Eskdagoat/Qorvo_F24_SD/Eclypse_TEST/Eclypse_Test_PLL_1/Eclypse_Test_PLL_1.runs/impl_1/.init_design.begin.rst

<?xml version="1.0"?>
<ProcessHandle Version="1" Minor="0">
    <Process Command=".planAhead." Owner="ambsc" Host="AB-BEAST" Pid="18544">
    </Process>
</ProcessHandle>
