Eskdagoat/Qorvo_F24_SD/PYNQ/PYNQ_CLOCK_TEST/PYNQ_PLL_TEST.runs/MainDesign_ClockDivider_4_0_synth_1/.vivado.begin.rst

<?xml version="1.0"?>
<ProcessHandle Version="1" Minor="0">
    <Process Command="vivado.bat" Owner="ambsc" Host="AB-BEAST" Pid="27872" HostCore="16" HostMemory="051385802752">
    </Process>
</ProcessHandle>
