Eskdagoat/Qorvo_F24_SD/Eclypse_TEST/Eclypse_Transceiver/Eclypse_Transceiver/Eclypse_Transceiver.runs/impl_1/.init_design.begin.rst

<?xml version="1.0"?>
<ProcessHandle Version="1" Minor="0">
    <Process Command=".planAhead." Owner="andrew" Host="" Pid="36212">
    </Process>
</ProcessHandle>
