Eskdagoat/Qorvo_F24_SD/Computer/Eclypse/Eclypse_Transceiver/Eclypse_Transceiver/Eclypse_Transceiver.runs/impl_1/.vivado.begin.rst

<?xml version="1.0"?>
<ProcessHandle Version="1" Minor="0">
    <Process Command="vivado" Owner="andrew" Host="AB-UB24Vivado" Pid="36140" HostCore="8" HostMemory="16375808">
    </Process>
</ProcessHandle>
