Eskdagoat/Qorvo_F24_SD/SD1_Fall24/Computer/Eclypse/Eclypse_Transceiver/Eclypse_Transceiver/Eclypse_Transceiver.runs/impl_1/clockInfo.txt

-------------------------------------
| Tool Version : Vivado v.2024.2
| Date         : Sat Nov 23 22:49:03 2024
| Host         : AB-UB24Vivado
| Design       : design_1
| Device       : xc7z020-clg484-1--
-------------------------------------

For more information on clockInfo.txt clock routing debug file see https://support.xilinx.com/s/article/000035660?language=en_US
