Eskdagoat/Qorvo_F24_SD/SD2_Spring25/Reports/QORVO_RADIO_EXPO_POSTER_SDII.pptx.pdf

# Design of a Reconfigurable (Software Defined) Radio

# Senior Design II - Fall 2024

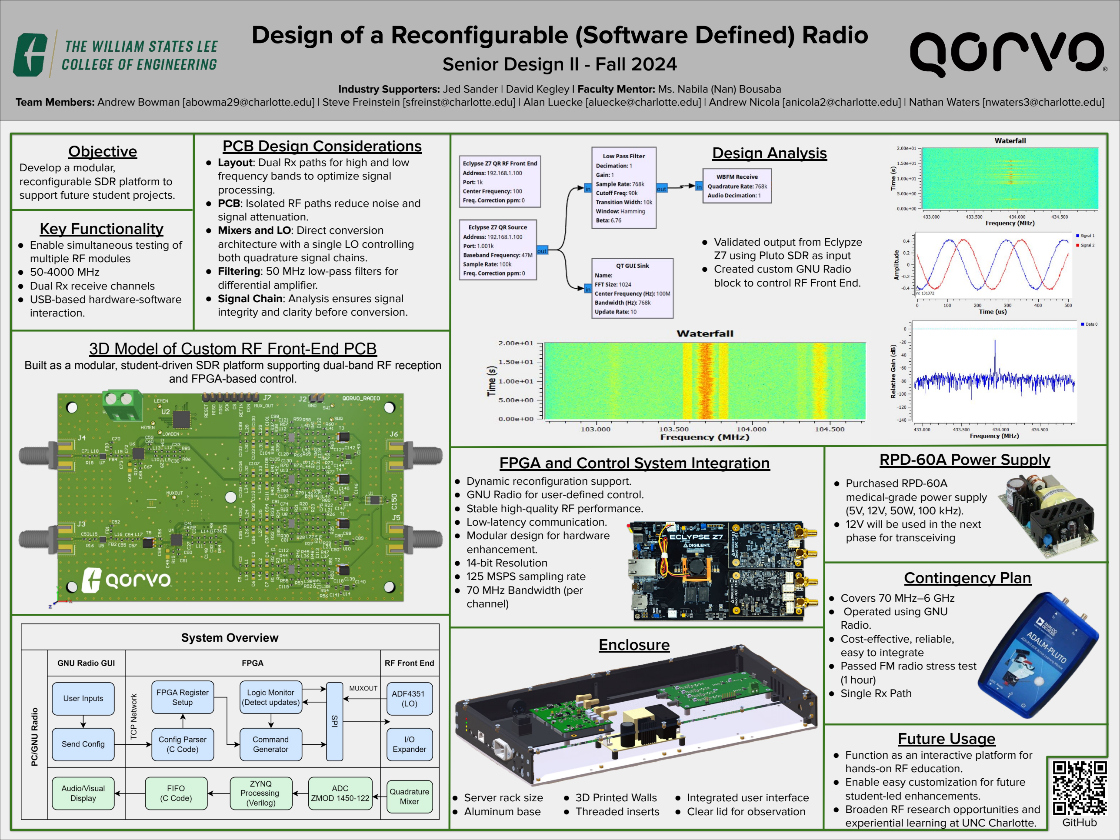
[picture p6: page 1]

## RPD-60A Power Supply

Industry Supporters: Jed Sander | David Kegley | Faculty Mentor: Ms. Nabila (Nan) Bousaba
Team Members: Andrew Bowman [abowma29@charlotte.edu] | Steve Freinstein [sfreinst@charlotte.edu] | Alan Luecke [aluecke@charlotte.edu] | Andrew Nicola [anicola2@charlotte.edu] | Nathan Waters [nwaters3@charlotte.edu]

## Objective

Develop a modular,
reconfigurable SDR platform to support future student projects.

## Key Functionality

- Enable simultaneous testing of multiple RF modules
- 50-4000 MHz
- Dual Rx receive channels
- USB-based hardware-software interaction.

## Design Analysis

## Contingency Plan

## Future Usage

- Function as an interactive platform for hands-on RF education.
- Enable easy customization for future
student-led enhancements.
- Broaden RF research opportunities and experiential learning at UNC Charlotte. GitHub

## PCB Design Considerations

- Layout: Dual Rx paths for high and low frequency bands to optimize signal processing.
- PCB: Isolated RF paths reduce noise and signal attenuation.
- Mixers and LO: Direct conversion architecture with a single LO controlling both quadrature signal chains.
- Filtering: 50 MHz low-pass filters for differential amplifier.
- Signal Chain: Analysis ensures signal integrity and clarity before conversion.

## FPGA and Control System Integration

- Dynamic reconfiguration support.
- GNU Radio for user-defined control.
- Stable high-quality RF performance.
- Low-latency communication.
- Modular design for hardware enhancement.
- 14-bit Resolution
- 125 MSPS sampling rate
- 70 MHz Bandwidth (per
channel)

## 3D Model of Custom RF Front-End PCB

Built as a modular, student-driven SDR platform supporting dual-band RF reception and FPGA-based control.

## Enclosure

- 3D Printed Walls
- Threaded inserts
- Integrated user interface
- Clear lid for observation
- Purchased RPD-60A
medical-grade power supply (5V, 12V, 50W, 100 kHz).
- 12V will be used in the next phase for transceiving
- Covers 70 MHz–6 GHz
- Operated using GNU
Radio.
- Cost-effective, reliable, easy to integrate
- Passed FM radio stress test (1 hour)
- Single Rx Path
- Server rack size
- Aluminum base
- Validated output from Eclypze Z7 using Pluto SDR as input
- Created custom GNU Radio block to control RF Front End.
