Eskdagoat/Qorvo_F24_SD/SD2_Spring25/Reports/QORVO_RADIO_ProjectSummary.pdf

Team Members Andrew Bowman (CPGR), Steve Freinstein (CPGR), Alan Luecke (MEGR), Andrew Nicola (EEGR), Nathan Waters (EEGR)

Mentors Ms. Nabila (Nan) BouSaba (ECE)

Project Overview Our project is the design and implementation of a modular, reconfigurable Software Defined Radio (SDR) platform. The goal is to provide a versatile system that can serve as an educational and prototyping tool for RF communication and signal processing. The system features a custom 6-layer RF front-end PCB designed in Altium, integrated with a Digilent Eclypse Z7 FPGA for high-speed digital signal processing. The RF front-end supports a tuning range of 50 MHz to 4 GHz and includes components for low-noise amplification, filtering, and mixing. The enclosure is constructed from an aluminum base plate and 3D printed walls to provide structural integrity and effective RF shielding. This SDR platform is designed with future expansion in mind—modules can be easily added, removed, or reconfigured. A host interface with GNU Radio on a PC enables real-time signal visualization and control. To validate the design and ensure functionality under constraints, the team also implemented a testing and contingency plan using an ADALM-PLUTO SDR.

Project Supporter Qorvo Inc, Staff Test Engineer David Kegley and RF Test Develpment Engineer Jed Sander
