Eskdagoat/Qorvo_F24_SD/SD1_Fall24/Computer/Eclypse/Diagrams/EclypseZ7_rev0-Copy of Hardware.drawio.png

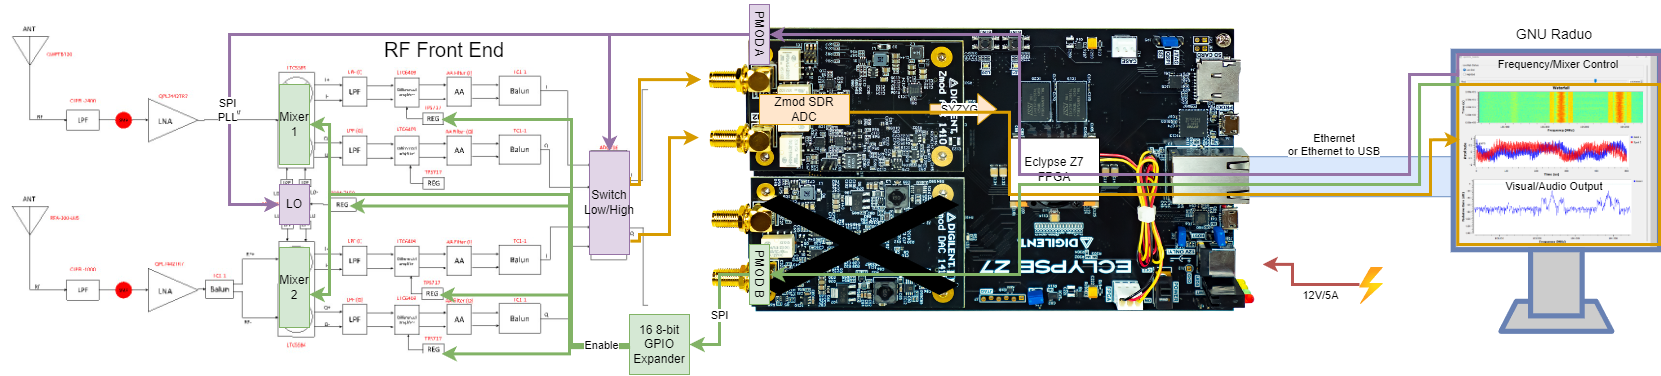
SD1_Fall24/Computer/Eclypse/Diagrams/EclypseZ7_rev0-Copy of Hardware.drawio.png
