Eskdagoat/Qorvo_F24_SD/SD1_Fall24/Computer/Eclypse/Images/Eclypse_PLL_1.png

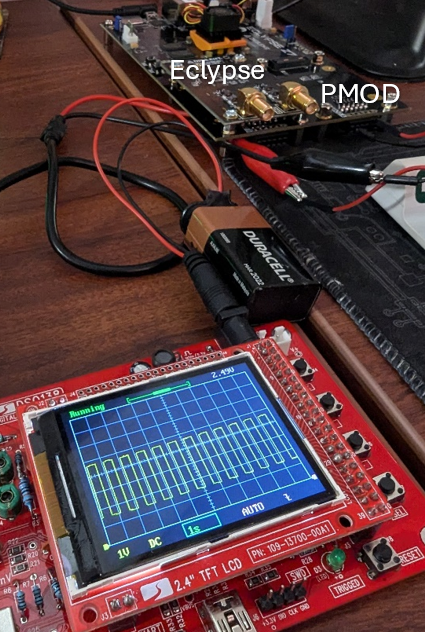
SD1_Fall24/Computer/Eclypse/Images/Eclypse_PLL_1.png
