Eskdagoat/Qorvo_F24_SD/SD1_Fall24/Computer/Images/GNU_Radio_1.png

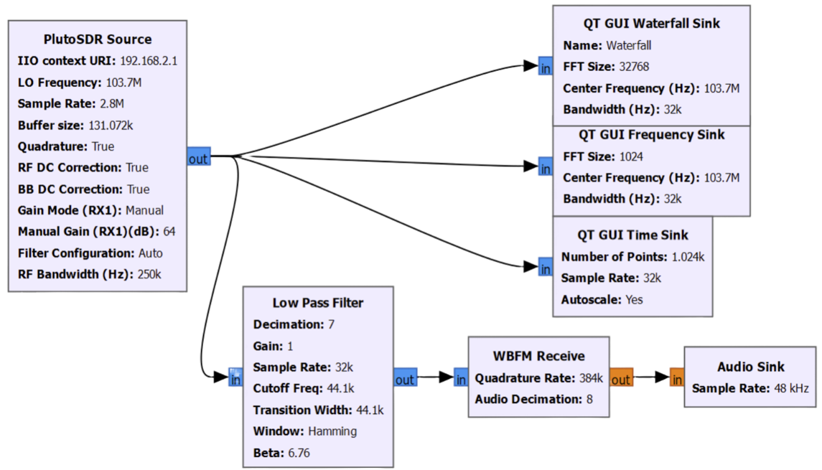
SD1_Fall24/Computer/Images/GNU_Radio_1.png
