Eskdagoat/Qorvo_F24_SD/SD1_Fall24/Electrical/BLOCK DIAGRAM/EclypseZ7_rev0-Hardware.drawio.png

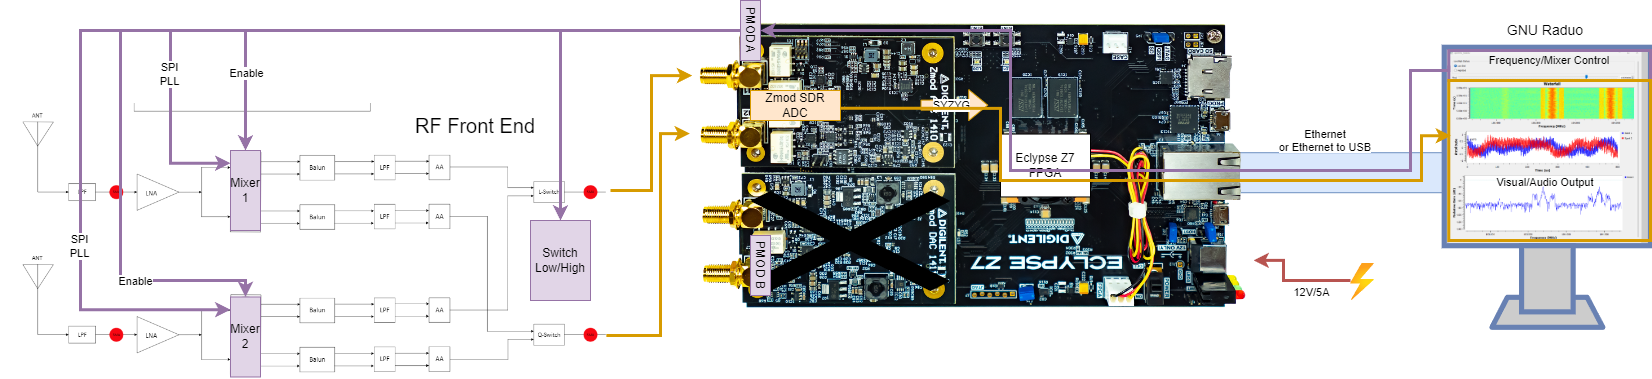
SD1_Fall24/Electrical/BLOCK DIAGRAM/EclypseZ7_rev0-Hardware.drawio.png
