Eskdagoat/Qorvo_F24_SD/SD1_Fall24/Electrical/FILTER/LPF&AA_FILTER.png

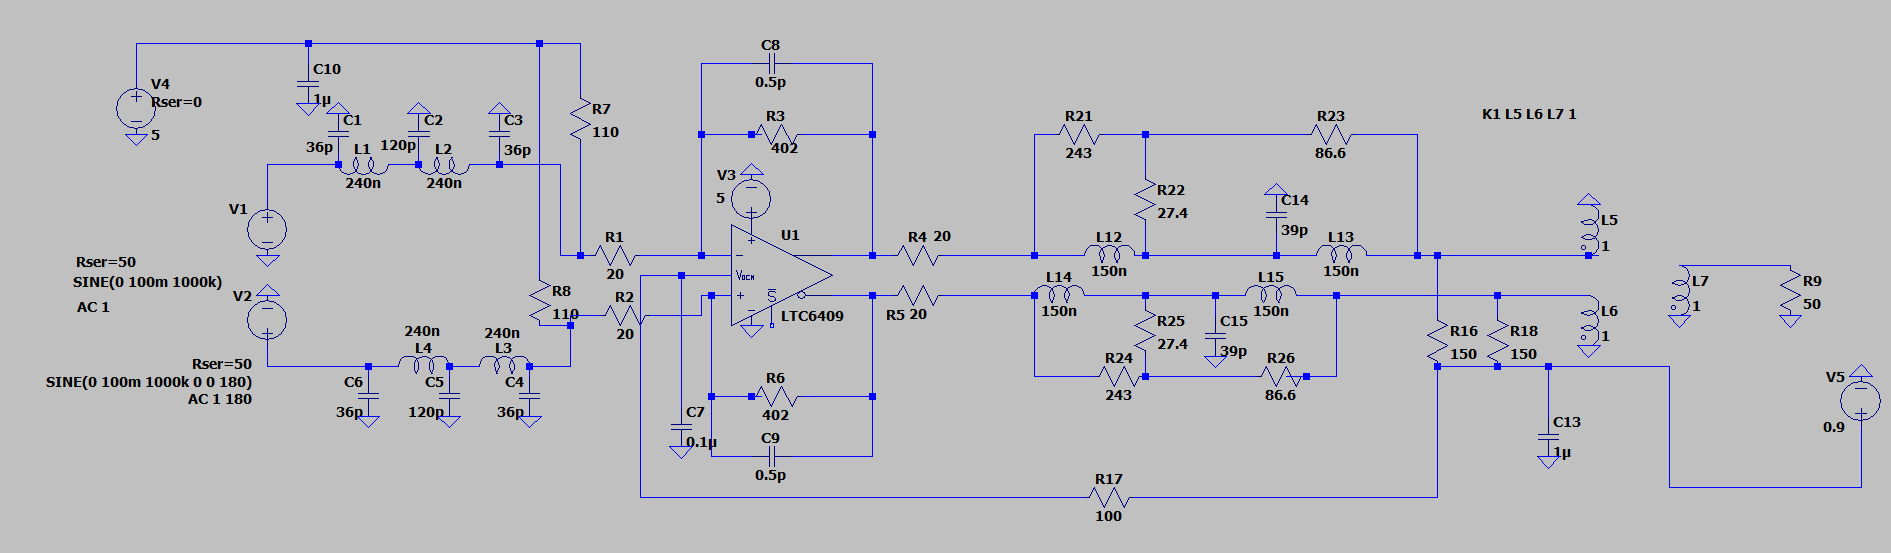
SD1_Fall24/Electrical/FILTER/LPF&AA_FILTER.png
