Eskdagoat/Qorvo_F24_SD/SD1_Fall24/Mechanical/MECHANICAL PICTURES/IMAGE_01.jpg

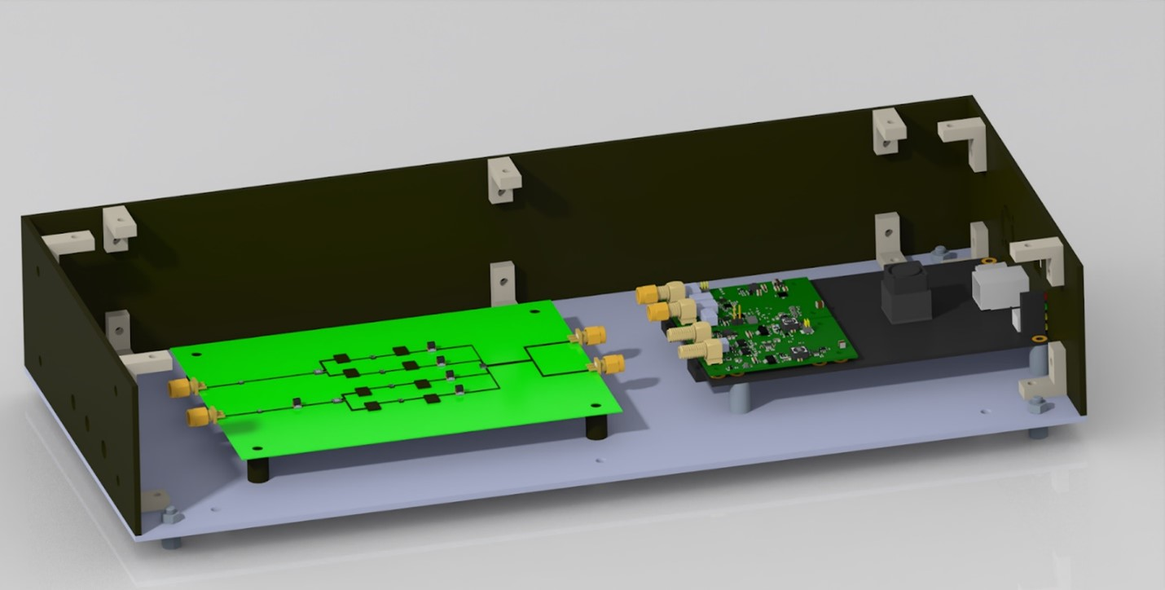
SD1_Fall24/Mechanical/MECHANICAL PICTURES/IMAGE_01.jpg
