Eskdagoat/Qorvo_F24_SD/SD1_Fall24/Mechanical/MECHANICAL PICTURES/IMAGE_02.png

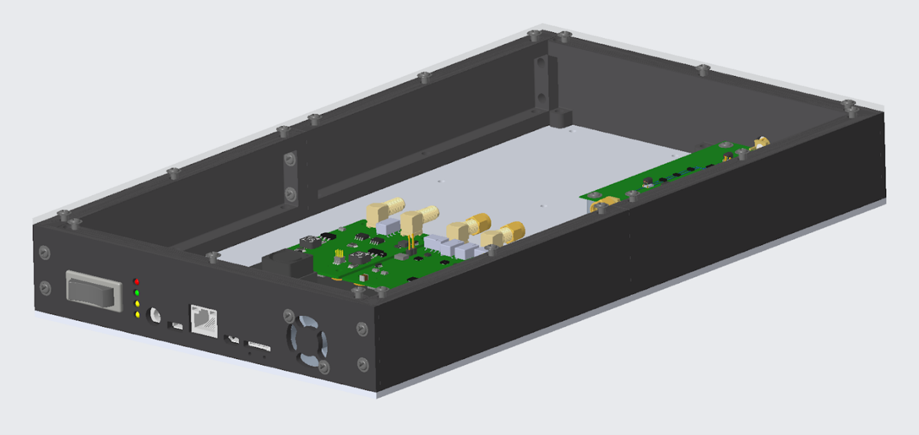
SD1_Fall24/Mechanical/MECHANICAL PICTURES/IMAGE_02.png
