Eskdagoat/Qorvo_F24_SD/Eclypse_TEST/Eclypse_Test_PLL_1/Eclypse_Test_PLL_1.runs/impl_1/.vivado.begin.rst

<?xml version="1.0"?>
<ProcessHandle Version="1" Minor="0">
    <Process Command="vivado.bat" Owner="ambsc" Host="AB-BEAST" Pid="11464" HostCore="16" HostMemory="051385802752">
    </Process>
</ProcessHandle>
<?xml version="1.0"?>
<ProcessHandle Version="1" Minor="0">
    <Process Command="vivado.bat" Owner="ambsc" Host="AB-BEAST" Pid="7532" HostCore="16" HostMemory="051385802752">
    </Process>
</ProcessHandle>
<?xml version="1.0"?>
<ProcessHandle Version="1" Minor="0">
    <Process Command="vivado.bat" Owner="ambsc" Host="AB-BEAST" Pid="12196" HostCore="16" HostMemory="051385802752">
    </Process>
</ProcessHandle>
<?xml version="1.0"?>
<ProcessHandle Version="1" Minor="0">
    <Process Command="vivado.bat" Owner="ambsc" Host="AB-BEAST" Pid="26444" HostCore="16" HostMemory="051385802752">
    </Process>
</ProcessHandle>
<?xml version="1.0"?>
<ProcessHandle Version="1" Minor="0">
    <Process Command="vivado.bat" Owner="ambsc" Host="AB-BEAST" Pid="27564" HostCore="16" HostMemory="051385802752">
    </Process>
</ProcessHandle>
<?xml version="1.0"?>
<ProcessHandle Version="1" Minor="0">
    <Process Command="vivado.bat" Owner="ambsc" Host="AB-BEAST" Pid="28036" HostCore="16" HostMemory="051385802752">
    </Process>
</ProcessHandle>
<?xml version="1.0"?>
<ProcessHandle Version="1" Minor="0">
    <Process Command="vivado.bat" Owner="ambsc" Host="AB-BEAST" Pid="27432" HostCore="16" HostMemory="051385802752">
    </Process>
</ProcessHandle>
<?xml version="1.0"?>
<ProcessHandle Version="1" Minor="0">
    <Process Command="vivado.bat" Owner="ambsc" Host="AB-BEAST" Pid="29864" HostCore="16" HostMemory="051385802752">
    </Process>
</ProcessHandle>
