Eskdagoat/Qorvo_F24_SD/Eclypse_TEST/Eclypse_Test_PLL_1/Eclypse_Test_PLL_1.runs/synth_1/.vivado.begin.rst

<?xml version="1.0"?>
<ProcessHandle Version="1" Minor="0">
    <Process Command="vivado.bat" Owner="ambsc" Host="AB-BEAST" Pid="6168" HostCore="16" HostMemory="051385802752">
    </Process>
</ProcessHandle>
