Eskdagoat/Qorvo_F24_SD/SD1_Fall24/Computer/Eclypse/Eclypse_Test_PLL_1/Eclypse_Test_PLL_1.runs/ClockDivider_Block_ClockDivider_0_0_synth_1/.vivado.begin.rst

<?xml version="1.0"?>
<ProcessHandle Version="1" Minor="0">
    <Process Command="vivado.bat" Owner="ambsc" Host="AB-LENOVO5" Pid="16440" HostCore="8" HostMemory="016705122304">
    </Process>
</ProcessHandle>
