Eskdagoat/Qorvo_F24_SD/SD1_Fall24/Computer/PYNQ/PYNQ_CLOCK_TEST/PYNQ_PLL_TEST.runs/impl_1/clockInfo.txt

-------------------------------------
| Tool Version : Vivado v.2024.1
| Date         : Sun Nov 17 23:51:58 2024
| Host         : AB-Beast
| Design       : design_1
| Device       : xc7z020-clg400-1--
-------------------------------------

For more information on clockInfo.txt clock routing debug file see https://support.xilinx.com/s/article/000035660?language=en_US
