Eskdagoat/Qorvo_F24_SD/SD1_Fall24/Computer/Eclypse/Eclypse_Testing.MD

# Eclypse Z7 Testing

## PLL Output

A PLL signal was output from the PMOD on the PYNQ to test the feasability of outputing a clock over PMOD ports. The code for the PLL was based on code that was tested on the PYNQ-Z2. The guide linked below was used as a starting place for code on the PYNQ-Z2.   The output was tested with a cheap oscilliscope. 

[A PYNQ-Z2 Guide for Absolute Dummies — Part III: Configuring the FPGA Clock](https://blog.umer-farooq.com/a-pynq-z2-guide-for-absolute-dummies-part-iii-tick-tock-using-fpga-clock-33a34ef3f51a)

[Vivado source for PLL Output](https://github.com/Eskdagoat/Qorvo_F24_SD/tree/main/Eclypse_TEST/Eclypse_Test_PLL_1)

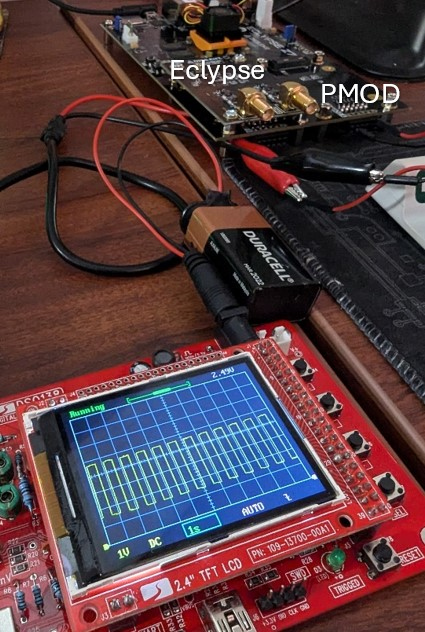
[picture p31: SD1_Fall24/Computer/Eclypse/Images/Eclypse_PLL_1.jpg]
Eclypse PLL Output


Figure 1 - Eclypse PLL Output
