Eskdagoat/Qorvo_F24_SD/SD1_Fall24/Computer/Eclypse/Images/Eclypse_Test_Images.docx

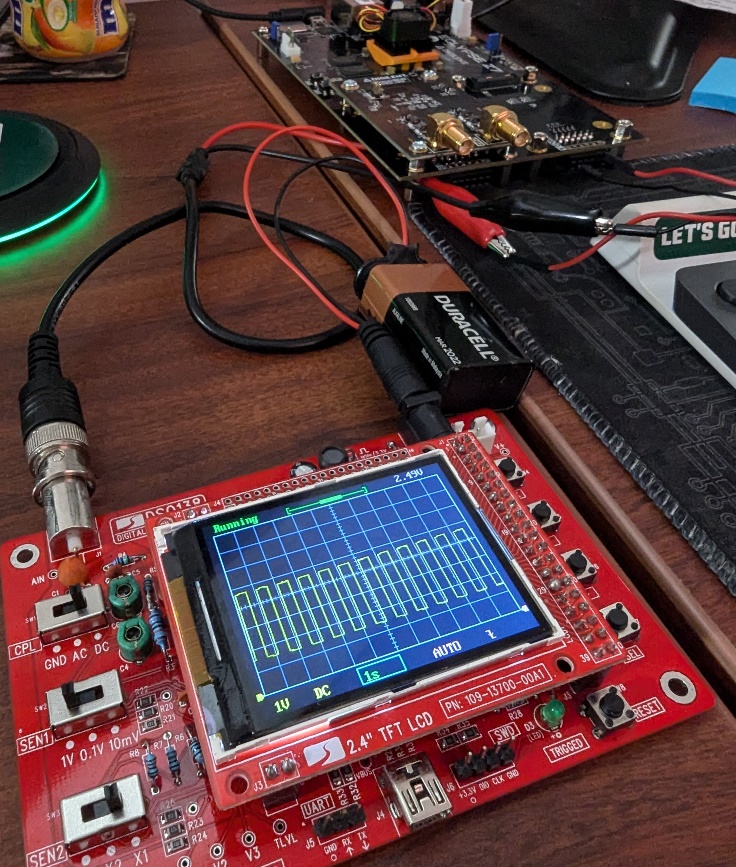
[picture p32: figure]

PMOD

Eclypse
