Eskdagoat/Qorvo_F24_SD/SD1_Fall24/Electrical/PCB/SCHEMATIC/QORVO_RADIO_PDR_DrawingSet_SCHEMATIC.pdf

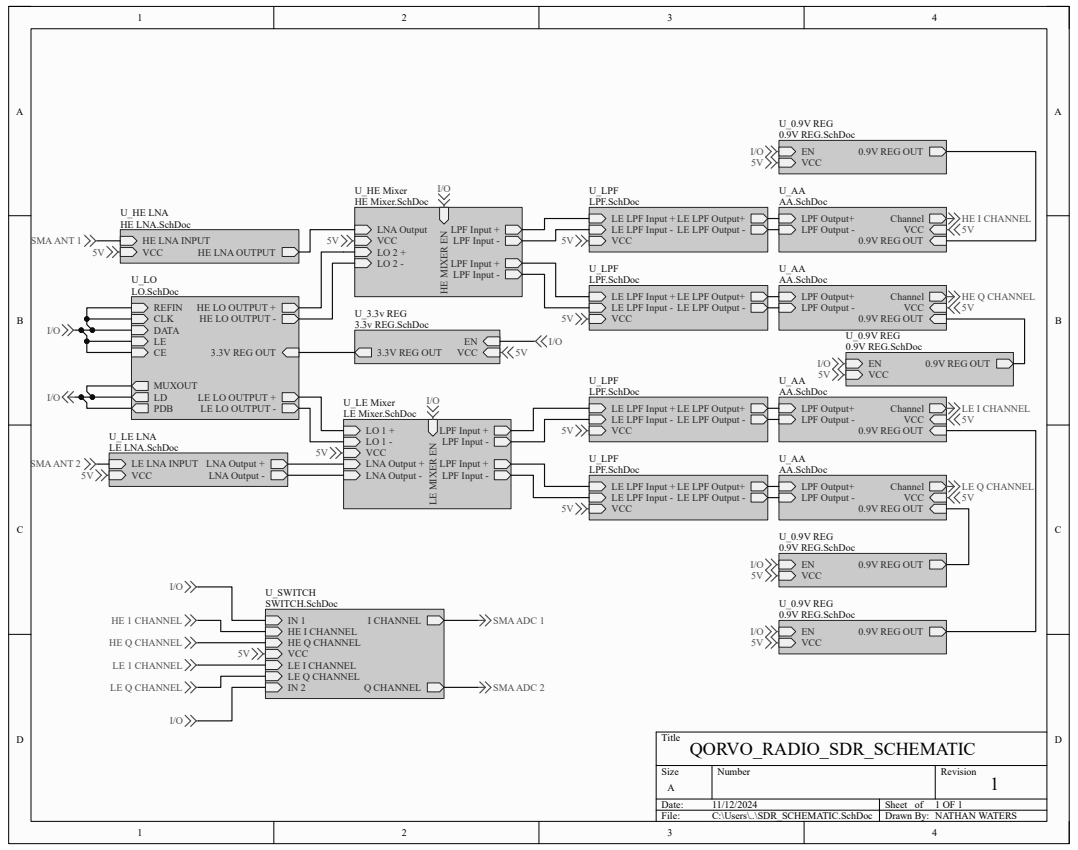
[picture p34: page 1]
Title; Size; Number; Revision; Date:; Sheet of; File:; C:\Users\..\SDR_SCHEMATIC.SchDoc; Drawn By:; VCC; HE LNA OUTPUT; LNA Output + LNA Output -; LNA Output; LPF Input + LPF Input -; HE MIXER EN; LE MIXER EN; REFIN; HE LO OUTPUT +; CLK DATA LE CE; MUXOUT LD PDB; 3.3V REG OUT; U_LO LO.SchDoc; U_3.3v REG 3.3v REG.SchDoc; U_LPF LPF.SchDoc 5V; SMA ANT 1; SMA ANT 2; LPF Output+ LPF Output -; Channel VCC 0.9V REG OUT; U_AA AA.SchDoc; HE I CHANNEL; EN VCC; 0.9V REG OUT; U_0.9V REG 0.9V REG.SchDoc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

U_HE Mixer
HE Mixer.SchDoc

U_LPF
LPF.SchDoc
LE LPF Input +
LE LPF Input -
VCC

U_HE LNA
HE LNA.SchDoc
HE LNA INPUT

LE LPF Output+
LE LPF Output -

HE LO OUTPUT -

LE LO OUTPUT +
LE LO OUTPUT -

U_LE Mixer
LE Mixer.SchDoc
LNA Output +
LNA Output -

U_LE LNA
LE LNA.SchDoc
LE LNA INPUT

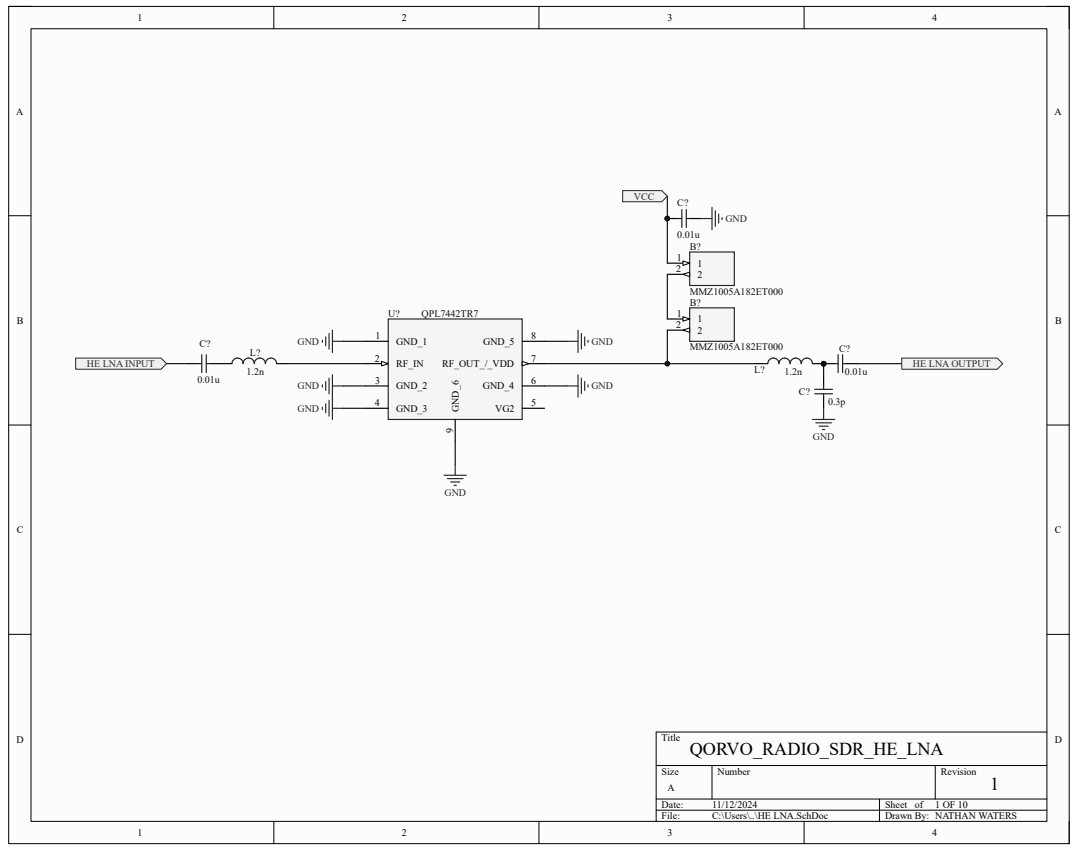
[picture p35: page 2]
Title; Size; Number; Revision; File:; C:\Users\..\HE LNA.SchDoc; Drawn By:; GND_1 1; GND_2 3; GND_3 4; GND_6; GND_5; RF_OUT_/_VDD; GND_4; QPL7442TR7; GND; MMZ1005A182ET000; VCC; QORVO_RADIO_SDR_HE_LNA

HE LNA INPUT

HE LNA OUTPUT

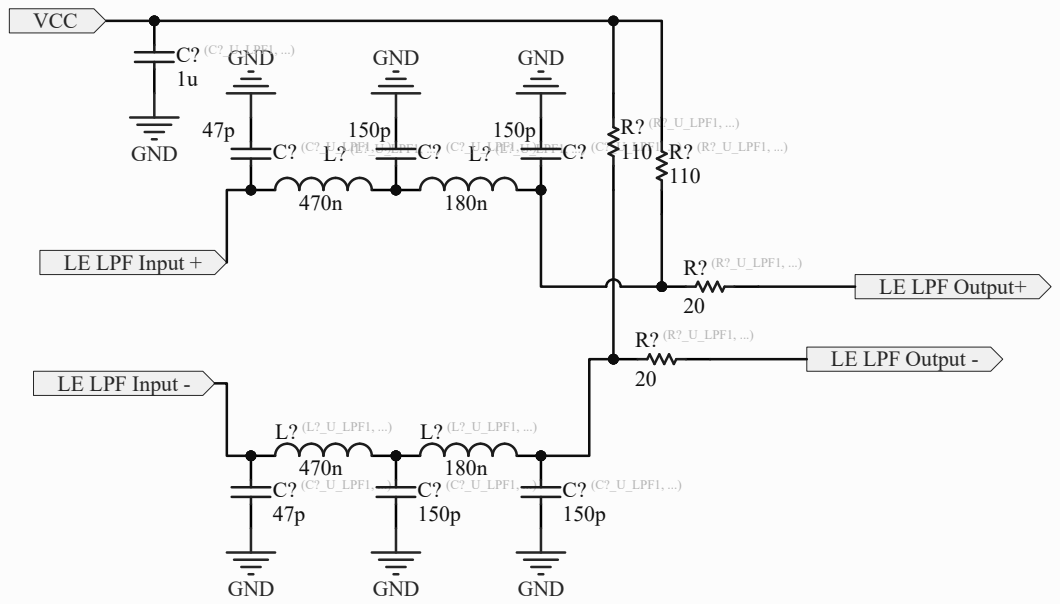
[picture p36: page 3]
Title; Size; Number; Revision; File:; C:\Users\..\LPF.SchDoc; Drawn By:; L? ⁽L?_U_LPF1, ...); C? ⁽C?_U_LPF1, ...); GND; R? ⁽R?_U_LPF1, ...); VCC; QORVO_RADIO_SDR_LPF

LE LPF Input +

LE LPF Output+

LE LPF Output -

LE LPF Input -

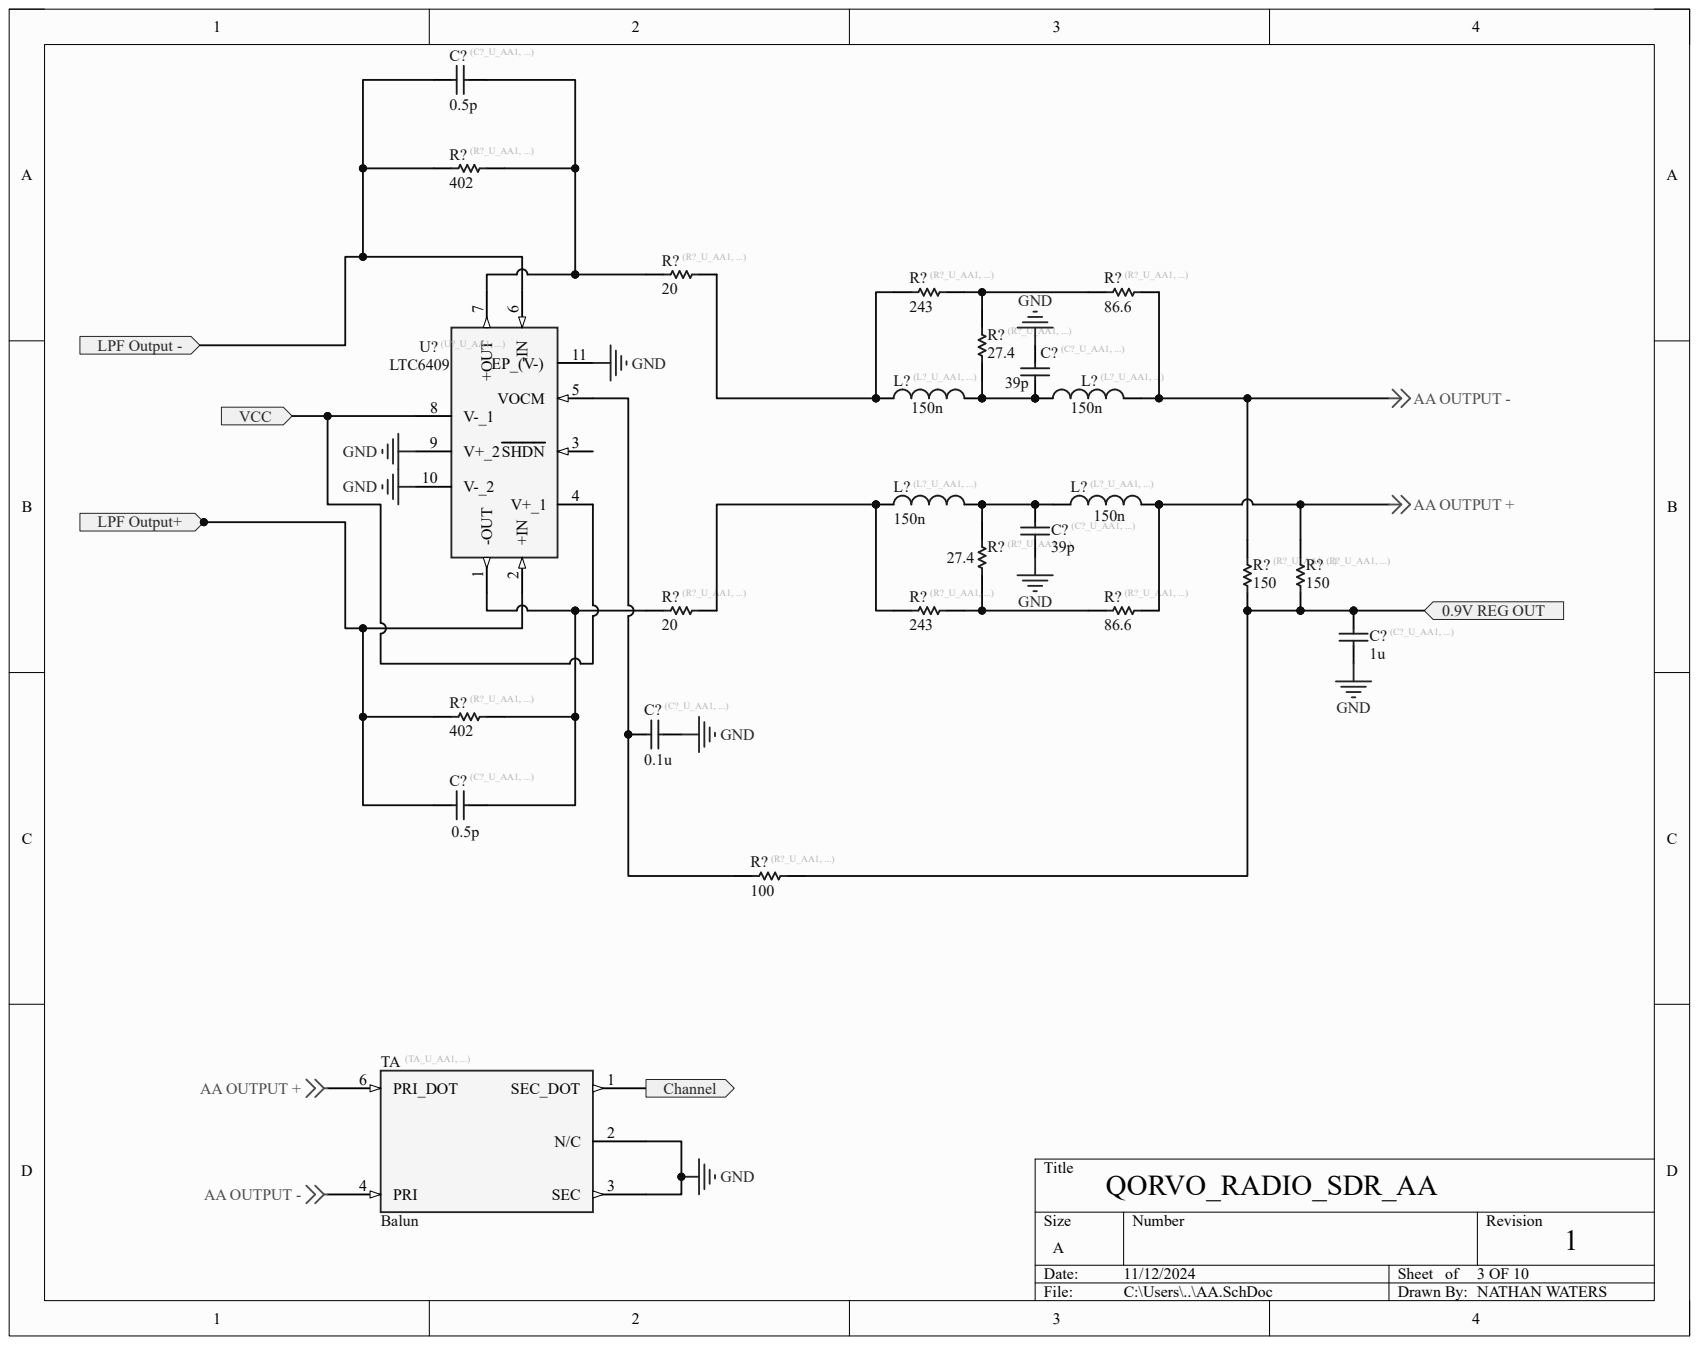
[picture p37: page 4]
Title; Size; Number; Revision; File:; C:\Users\..\AA.SchDoc; Drawn By:; LPF Output+; LPF Output -; -OUT; SHDN; VOCM; 6 +OUT; LTC6409; GND; C? ⁽C?_U_AA1, ...) GND; SEC_DOT; PRI_DOT 6; PRI 4; SEC; Balun; Channel; VCC; 0.9V REG OUT; AA OUTPUT -; AA OUTPUT +; QORVO_RADIO_SDR_AA

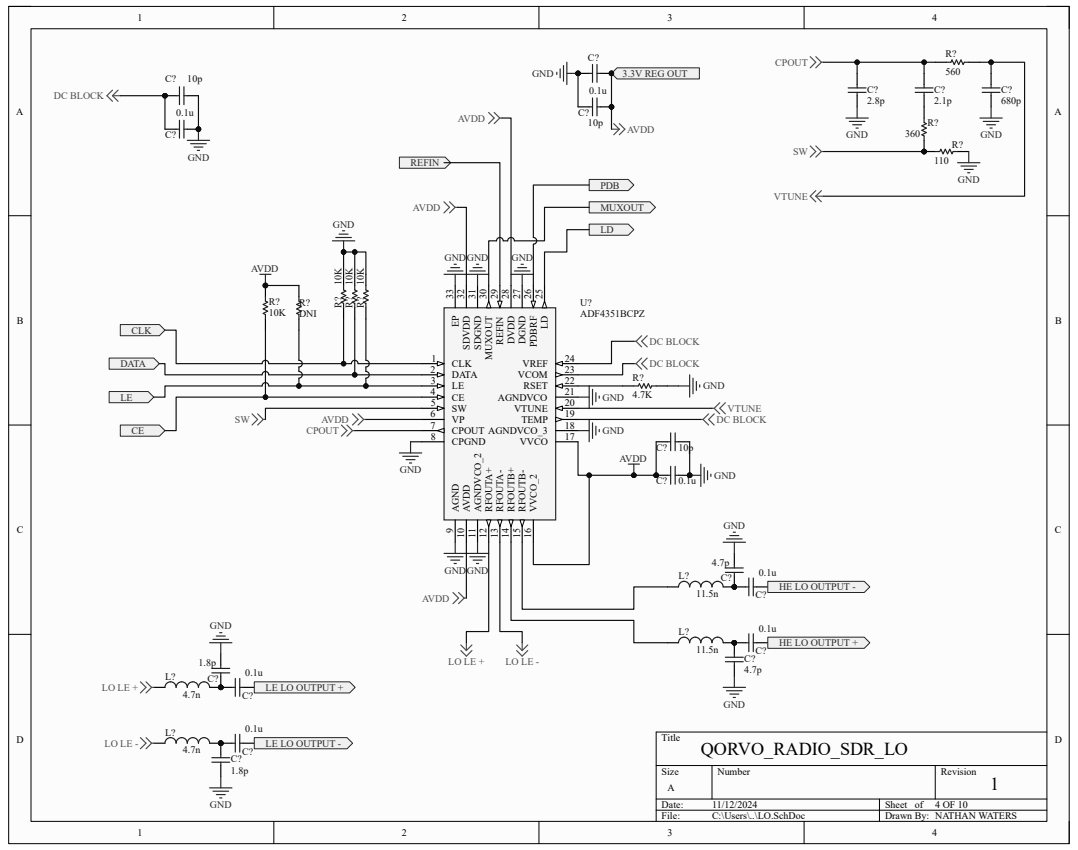
[picture p38: page 5]
Title; Size; Number; Revision; File:; C:\Users\..\LO.SchDoc; Drawn By:; CLK 1 DATA 2 LE 3 CE 4 SW 5 VP 6 CPOUT 7; CPGND 8; AGND; VVCO; 17 AGNDVCO_3; 18 TEMP; 19 VTUNE; 20 AGNDVCO; 21 RSET; 22 VCOM; 23 VREF; 24 LD ²⁵ PDBRF ²⁶ DGND ²⁷ DVDD ²⁸ REFIN ²⁹ MUXOUT ³⁰ SDGND ³¹ SDVDD ³² EP ³³; U? ADF4351BCPZ; AVDD; DNI; GND; DC BLOCK; LE LO OUTPUT -; HE LO OUTPUT +; CPOUT; VTUNE; REFIN; CLK; DATA; MUXOUT; PDB; 3.3V REG OUT; QORVO_RADIO_SDR_LO

9 AVDD 10 AGNDVCO_2 11 RFOUTA+ 12 RFOUTA- 13 RFOUTB+ 14 RFOUTB- 15 VVCO_2 16

HE LO OUTPUT -

LE LO OUTPUT +

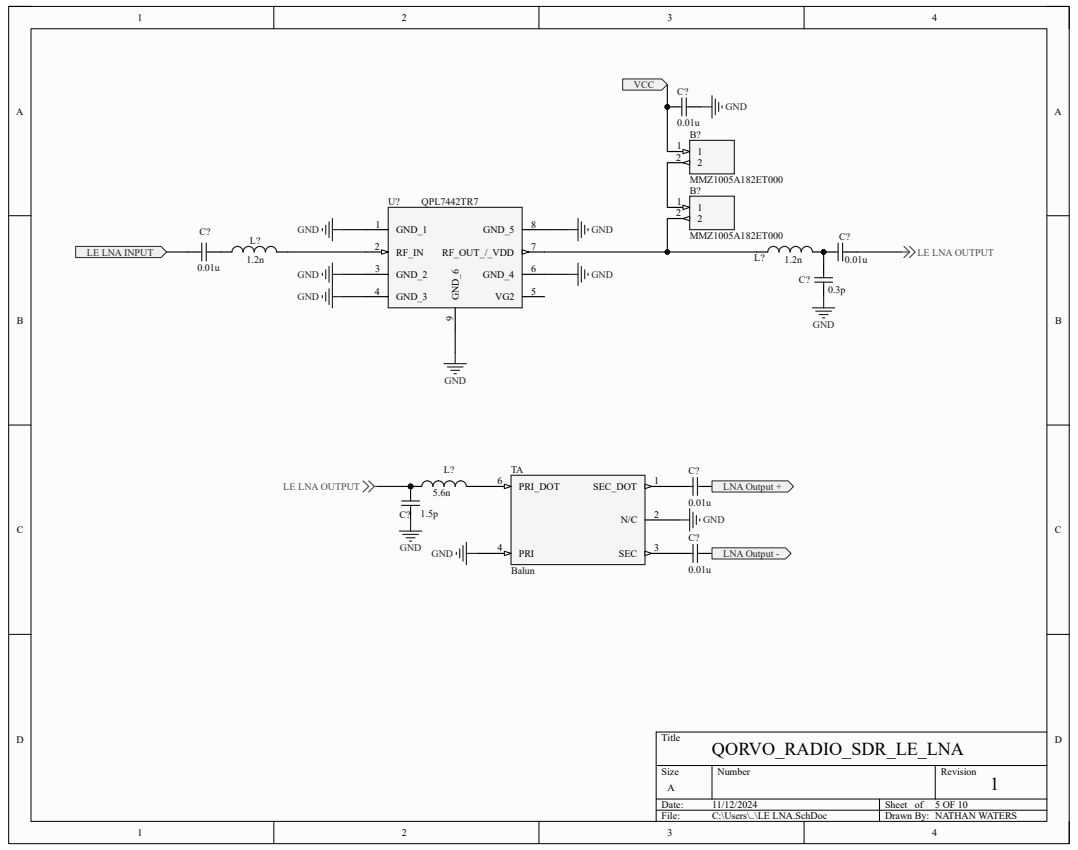
[picture p39: page 6]
Title; Size; Number; Revision; File:; C:\Users\..\LE LNA.SchDoc; Drawn By:; SEC_DOT; 1 PRI_DOT 6; PRI 4; SEC; Balun; GND; LNA Output +; GND_1 1; GND_2 3; GND_3 4; GND_6; GND_5; RF_OUT_/_VDD; GND_4; QPL7442TR7; MMZ1005A182ET000; VCC; QORVO_RADIO_SDR_LE_LNA

LE LNA INPUT

LE LNA OUTPUT

LNA Output - GND
GND

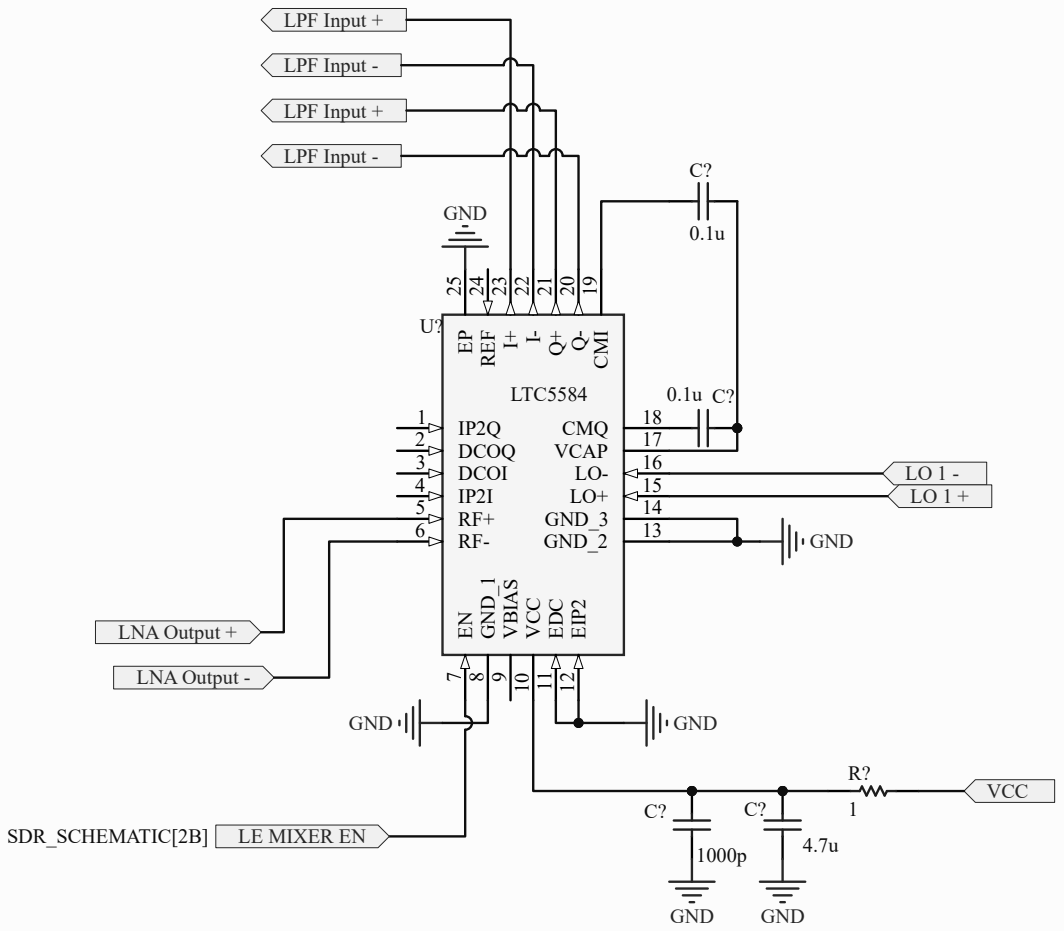
[picture p40: page 7]
Title; Size; Number; Revision; File:; C:\Users\..\LE Mixer.SchDoc; Drawn By:; IP2Q 1 DCOQ 2 DCOI 3 IP2I 4 RF+ 5; 7 GND_1 8 VBIAS; 9 VCC 10 EDC 11 EIP2 12; CMQ; VCAP; GND_3; GND_2; 13 EP ²⁵ REF ²⁴ I+ ²³ I- 22 Q⁺ ²¹ Q⁻ ²⁰ CMI 19; LTC5584; GND; LNA Output +; LNA Output -; LPF Input +; LPF Input -; VCC; QORVO_RADIO_SDR_LE_MIXER; SDR_SCHEMATIC[2B]; LE MIXER EN

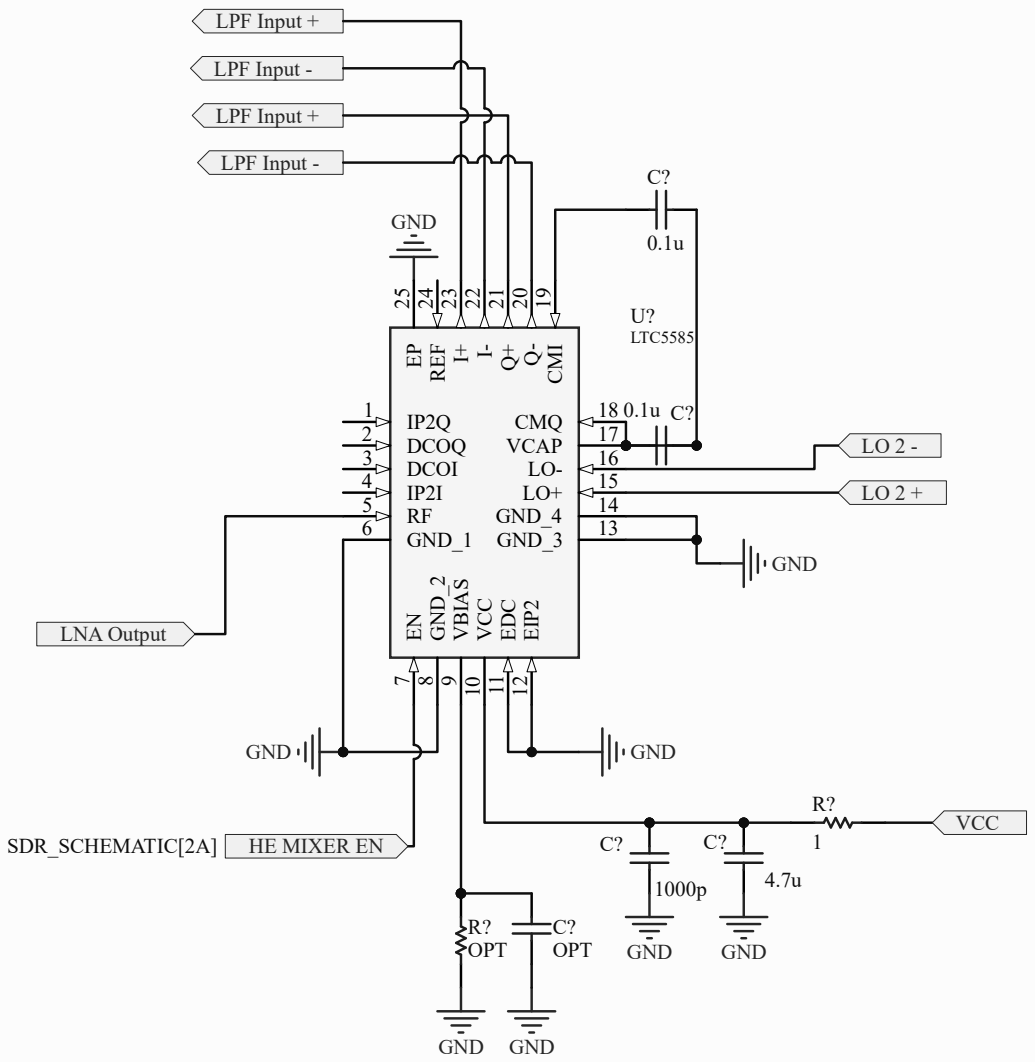
[picture p41: page 8]
Title; Size; Number; Revision; File:; C:\Users\..\HE Mixer.SchDoc; Drawn By:; OPT; GND GND; GND; IP2Q 1 DCOQ 2 DCOI 3 IP2I 4 RF 5; GND_1 6; 7 GND_2 8 VBIAS; 9 VCC 10 EDC 11 EIP2 12; CMQ; VCAP; GND_4; GND_3; 13 EP ²⁵ REF ²⁴ I+ ²³ I- 22 Q⁺ ²¹ Q⁻ ²⁰ CMI 19; U? LTC5585; LNA Output; LPF Input +; LPF Input -; VCC; QORVO_RADIO_SDR_HE_MIXER; SDR_SCHEMATIC[2A]; HE MIXER EN

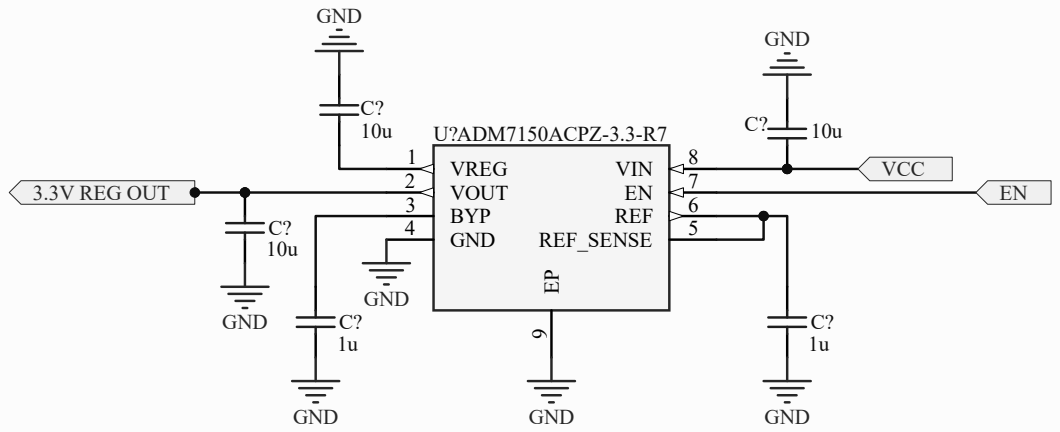
[picture p42: page 9]
Title; Size; Number; Revision; File:; C:\Users\..\3.3v REG.SchDoc; Drawn By:; VREG 1 VOUT 2 BYP 3; GND 4; VIN; REF; REF_SENSE; U?ADM7150ACPZ-3.3-R7; GND; VCC; 3.3V REG OUT; QORVO_RADIO_SDR_3.3V_REG

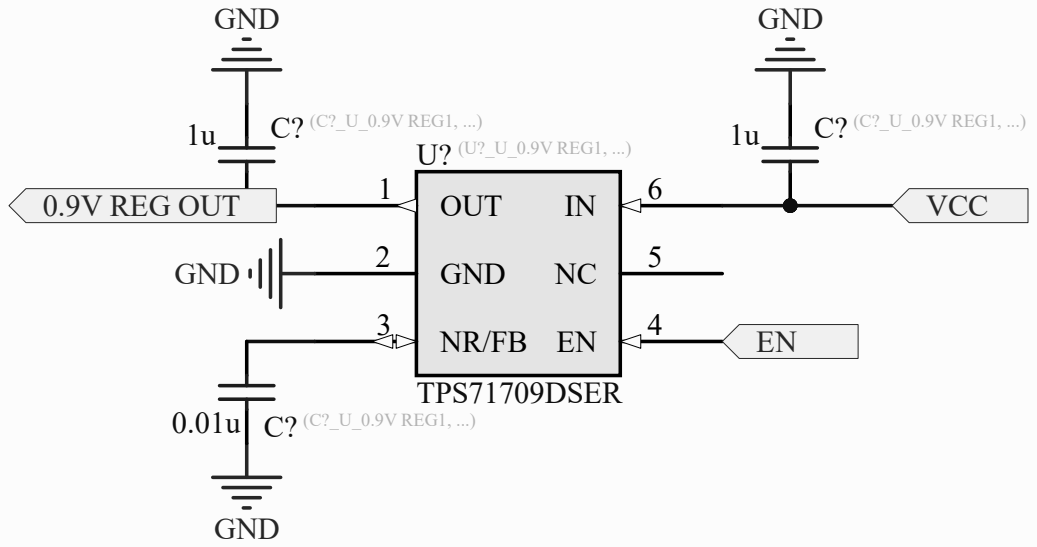
[picture p43: page 10]
Title; Size; Number; Revision; File:; C:\Users\..\0.9V REG.SchDoc; Drawn By:; OUT 1; GND 2; U? ⁽U?_U_0.9V REG1, ...); TPS71709DSER; C? ⁽C?_U_0.9V REG1, ...); GND; VCC; 0.9V REG OUT; QORVO_RADIO_SDR_0.9V_REG

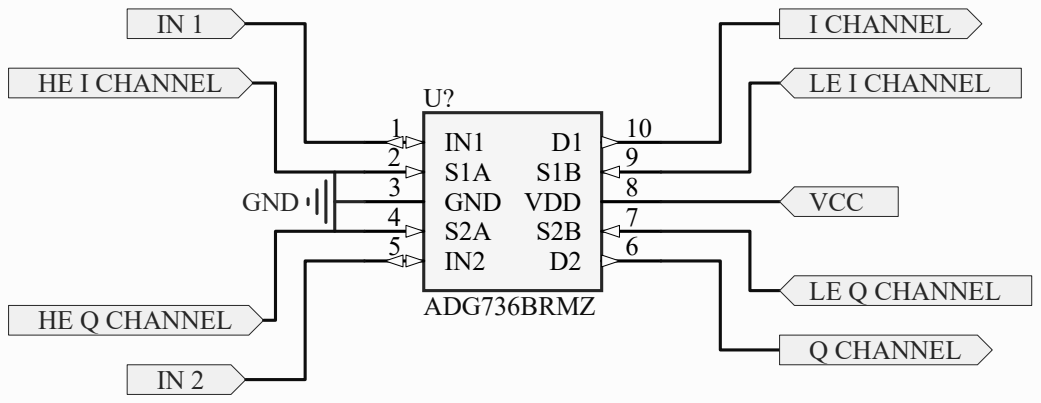
[picture p44: page 11]
Title; Size; Number; Revision; File:; C:\Users\..\SWITCH.SchDoc; Drawn By:; IN1 1 S1A 2 GND 3 S2A 4 IN2 5; VDD; ADG736BRMZ; GND; HE I CHANNEL; HE Q CHANNEL; I CHANNEL; Q CHANNEL; LE I CHANNEL; LE Q CHANNEL; VCC; QORVO_RADIO_SDR_SWITCH
