Eskdagoat/Qorvo_F24_SD/SD1_Fall24/Electrical/BLOCK DIAGRAM/PDR_BLOCK_DIAGRAM.pdf

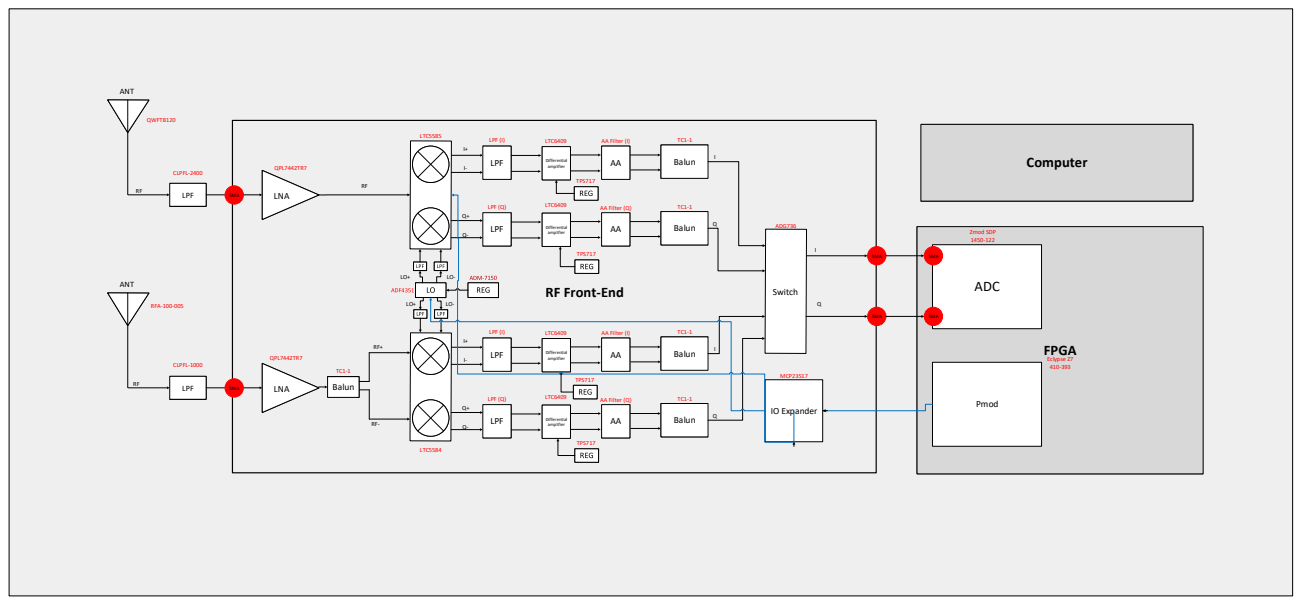
[picture p45: page 1]
LPF; ANT; SMA; LNA; FPGA; ADC; RFA; CLPFL; LTC5585; QPL7442TR7; QWFTB120; Balun; LPF (Q); AA Filter (Q); Differential amplifier; LPF (I); AA Filter (I); Differential; amplifier; Switch; LTC6409; LTC5584; ADG736; TPS717; Eclypse Z7 410; Zmod SDP 1450; RF Front; -End; Computer; IO Expander; Pmod; MCP23S17
