Eskdagoat/Qorvo_F24_SD/SD1_Fall24/Mechanical/ENCLOSURE/Drafts/Base_Plate.pdf

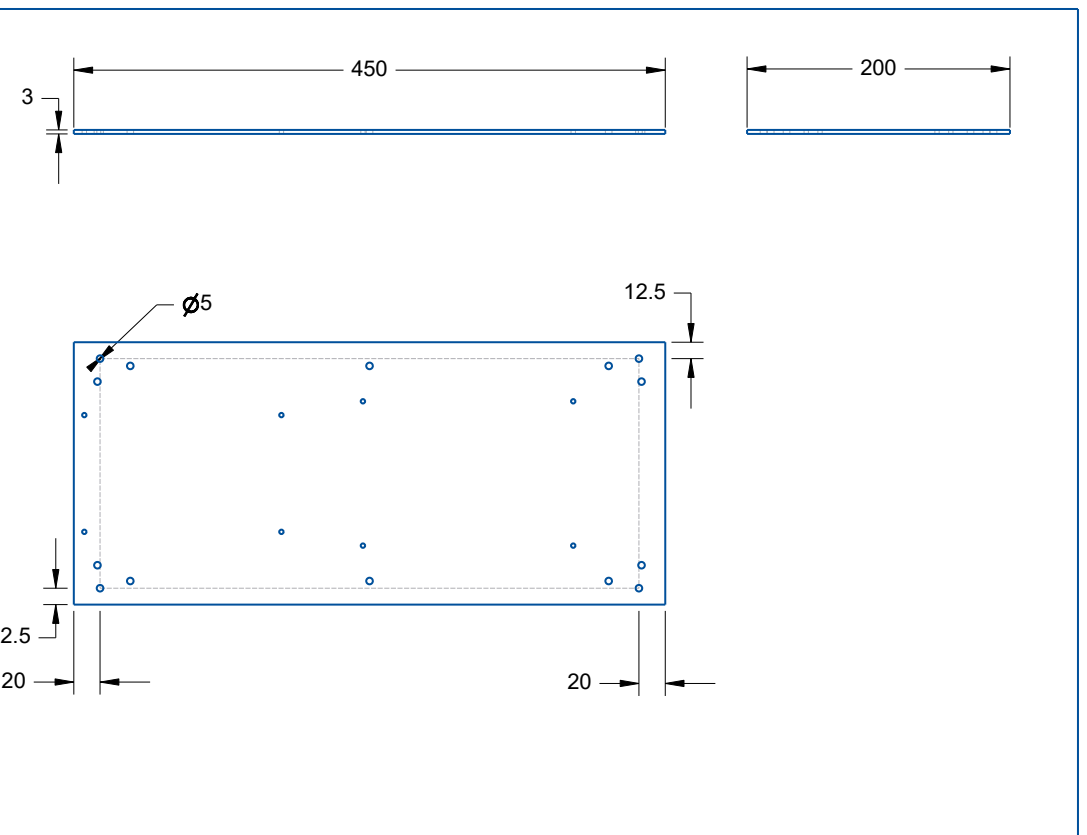
[picture p46: page 1]
