Eskdagoat/Qorvo_F24_SD/SD1_Fall24/Mechanical/ENCLOSURE/Drafts/Base_Plate_02.pdf

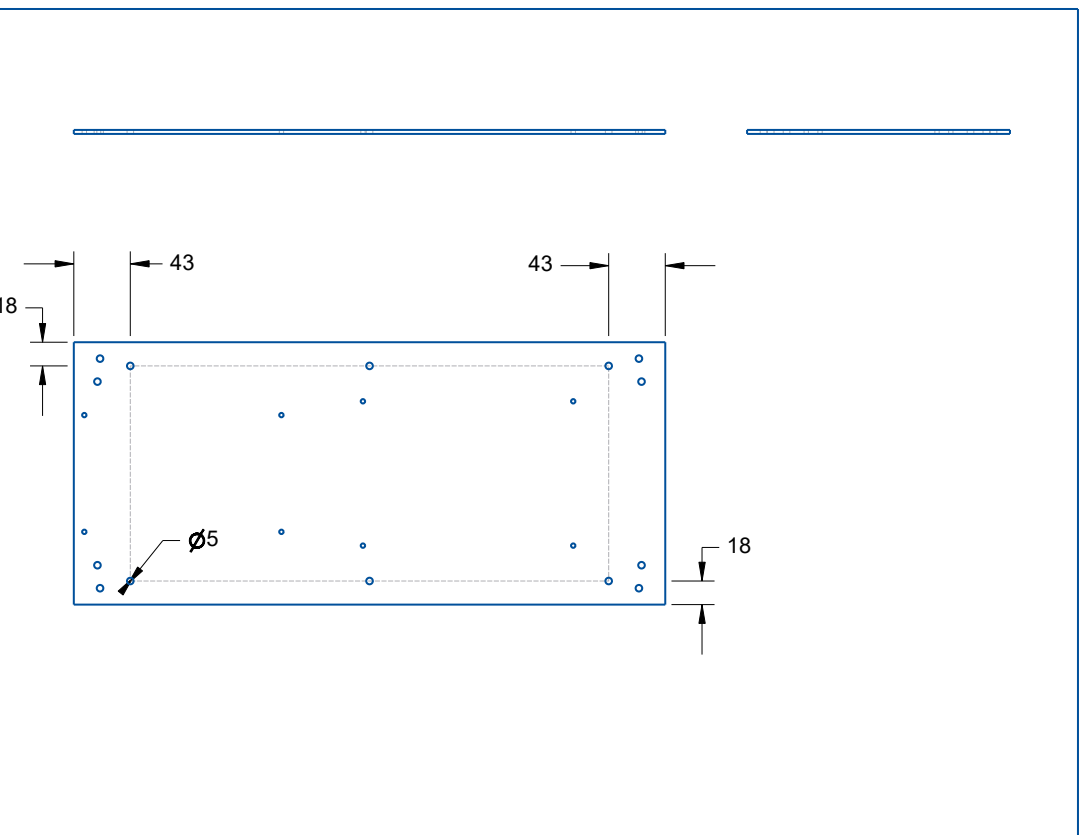
[picture p47: page 1]
