Eskdagoat/Qorvo_F24_SD/SD1_Fall24/Mechanical/ENCLOSURE/Drafts/Base_Plate_03.pdf

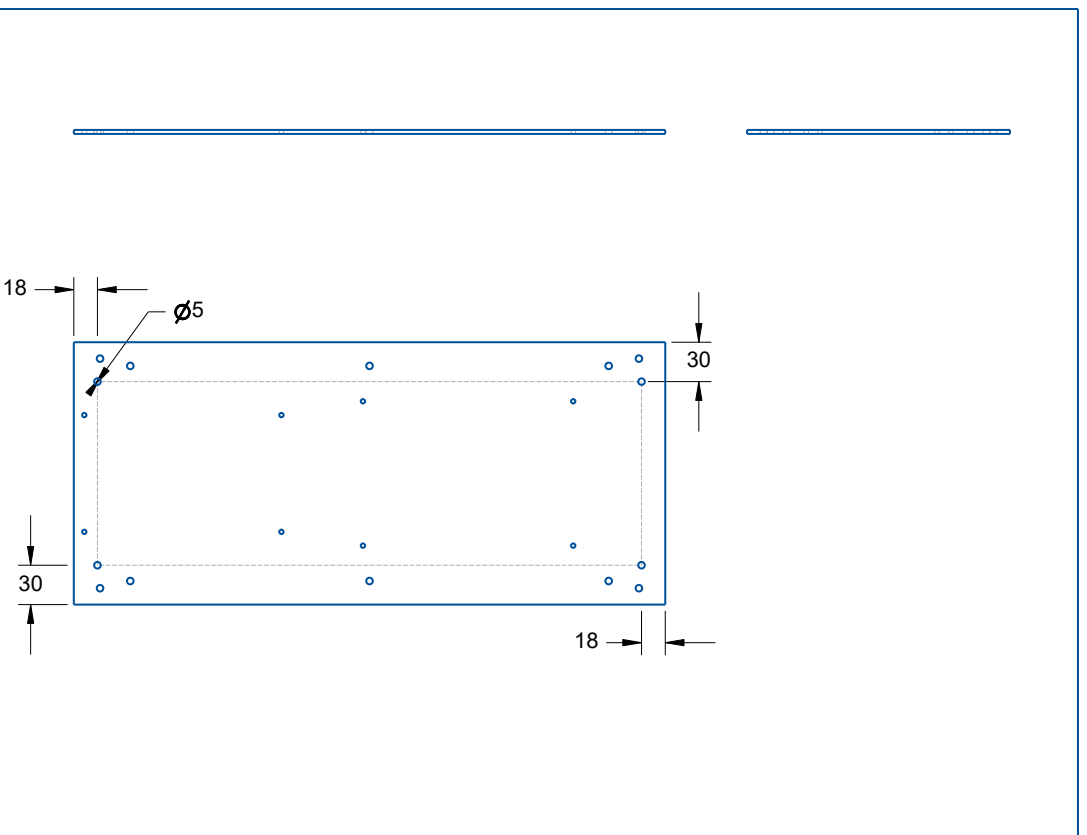
[picture p48: page 1]
