Eskdagoat/Qorvo_F24_SD/SD1_Fall24/Mechanical/ENCLOSURE/Drafts/Base_Plate_04.pdf

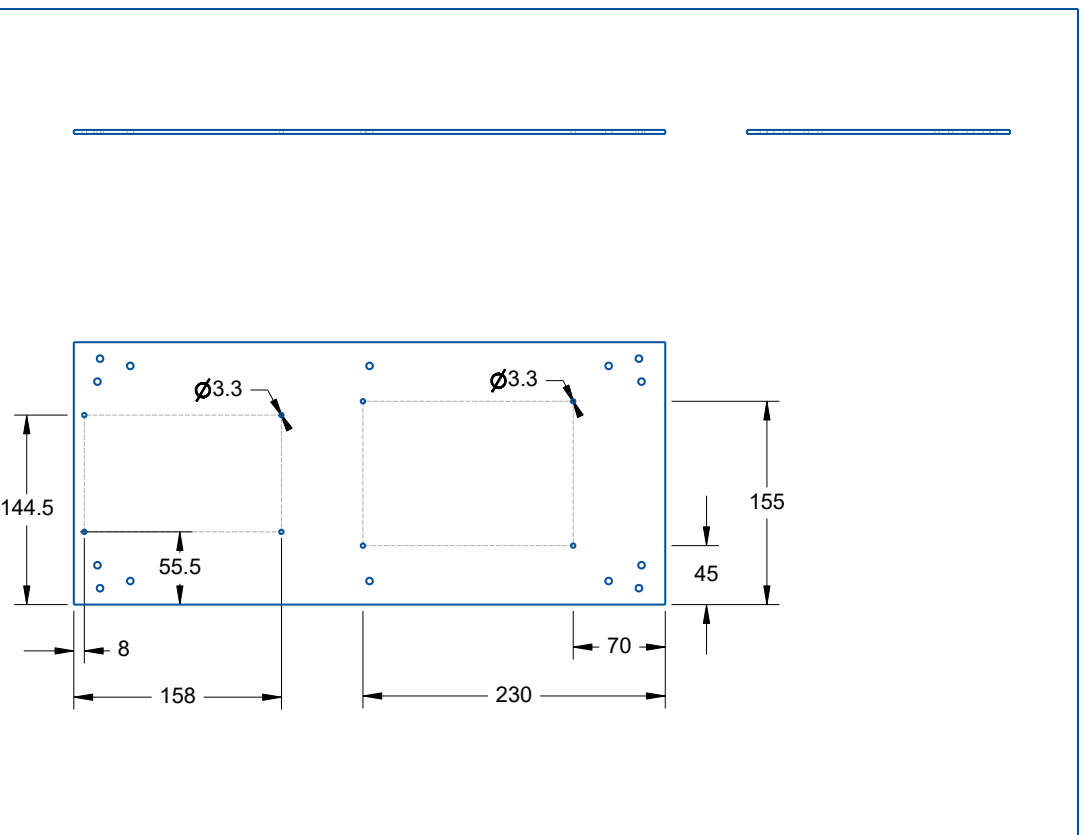
[picture p49: page 1]
