Eskdagoat/Qorvo_F24_SD/SD1_Fall24/Mechanical/ENCLOSURE/Drafts/Enclosure_ISO.pdf

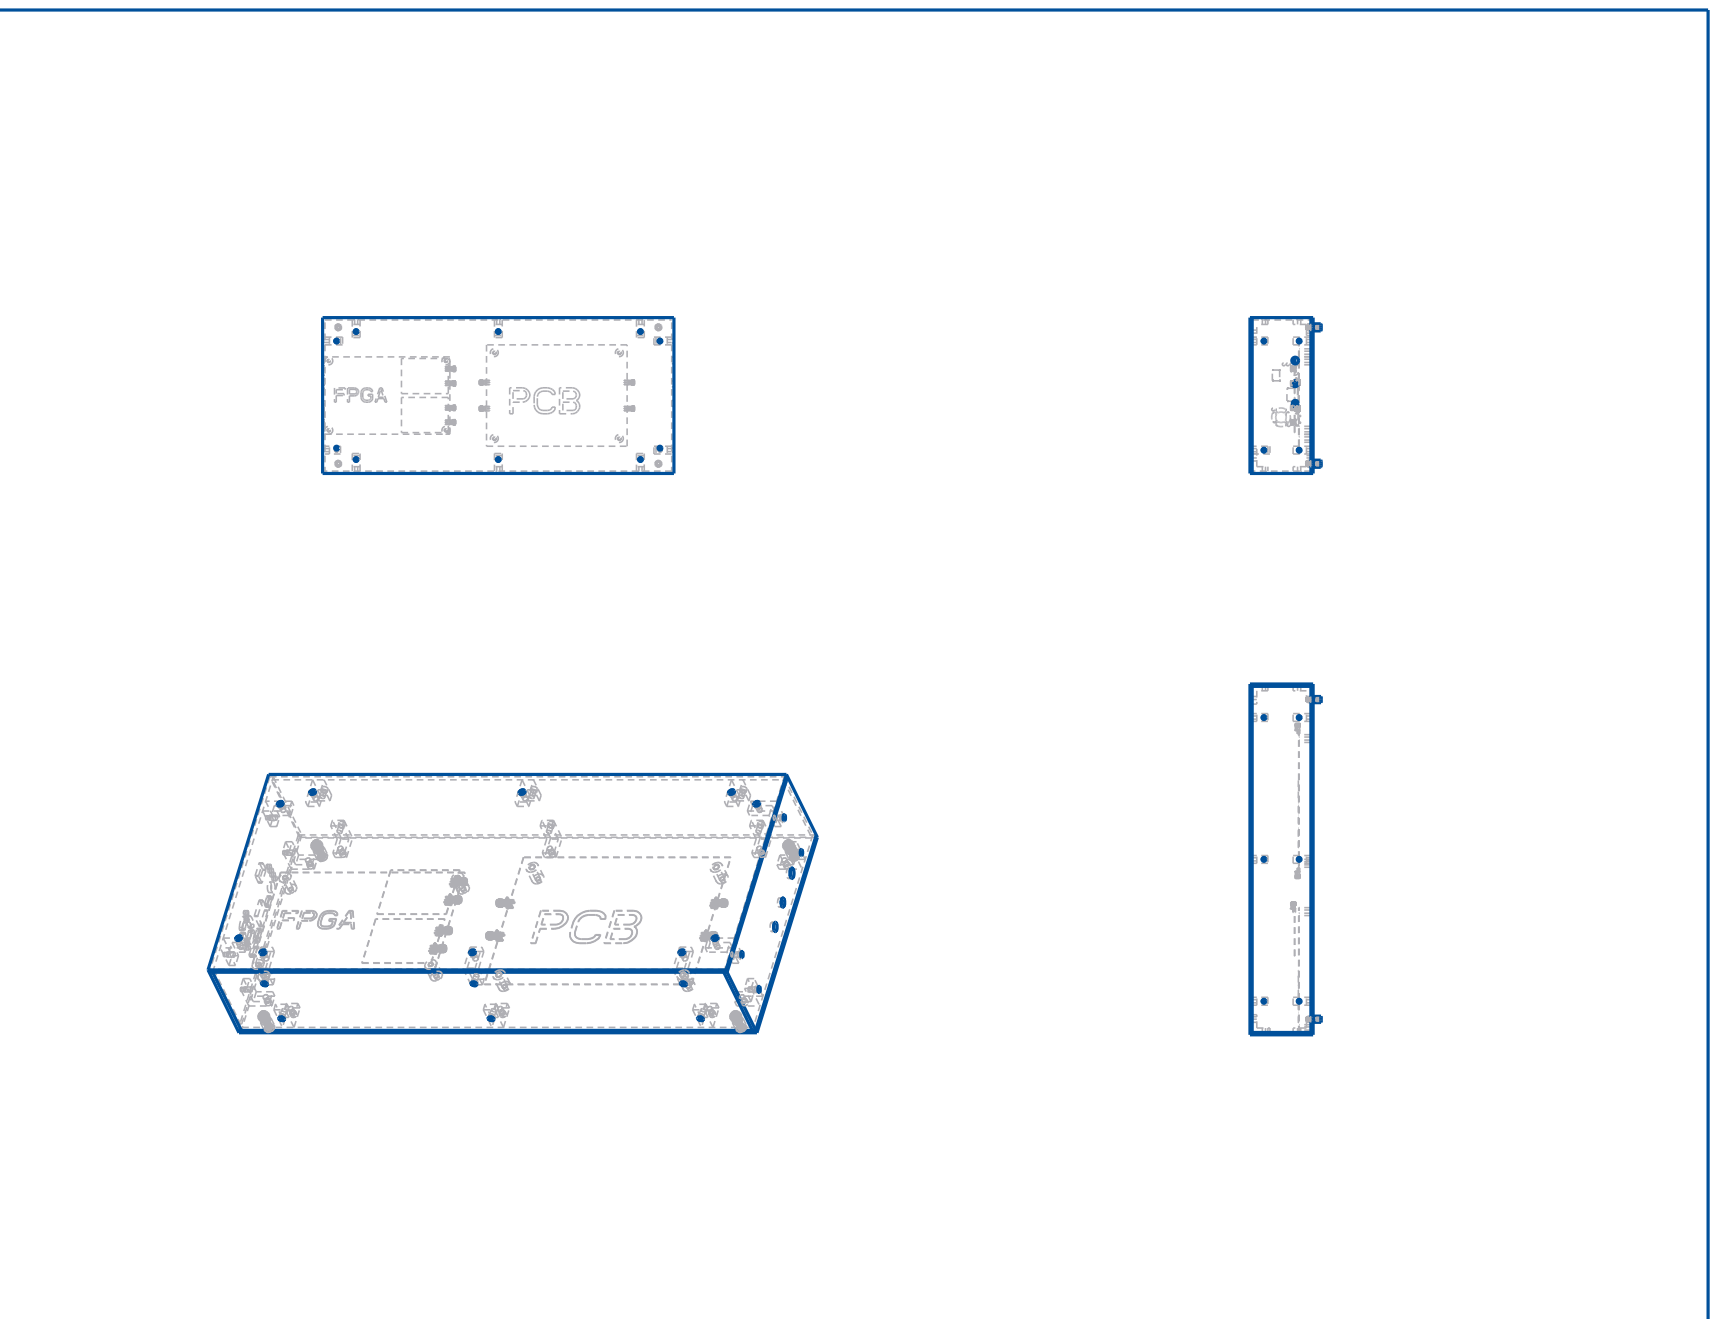
[picture p50: page 1]
