Eskdagoat/Qorvo_F24_SD/SD1_Fall24/Mechanical/ENCLOSURE/Drafts/FPGA_Interface_01.pdf

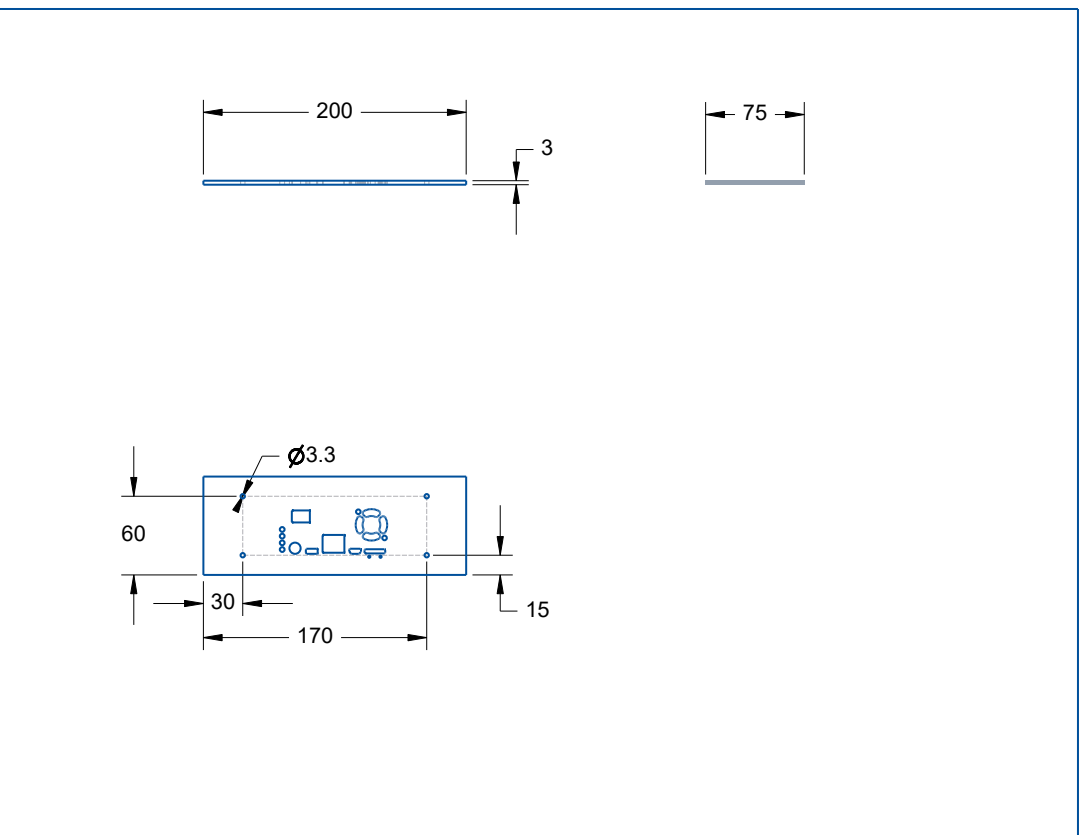
[picture p51: page 1]
