Eskdagoat/Qorvo_F24_SD/SD1_Fall24/Mechanical/ENCLOSURE/Drafts/PCB_interface_01.pdf

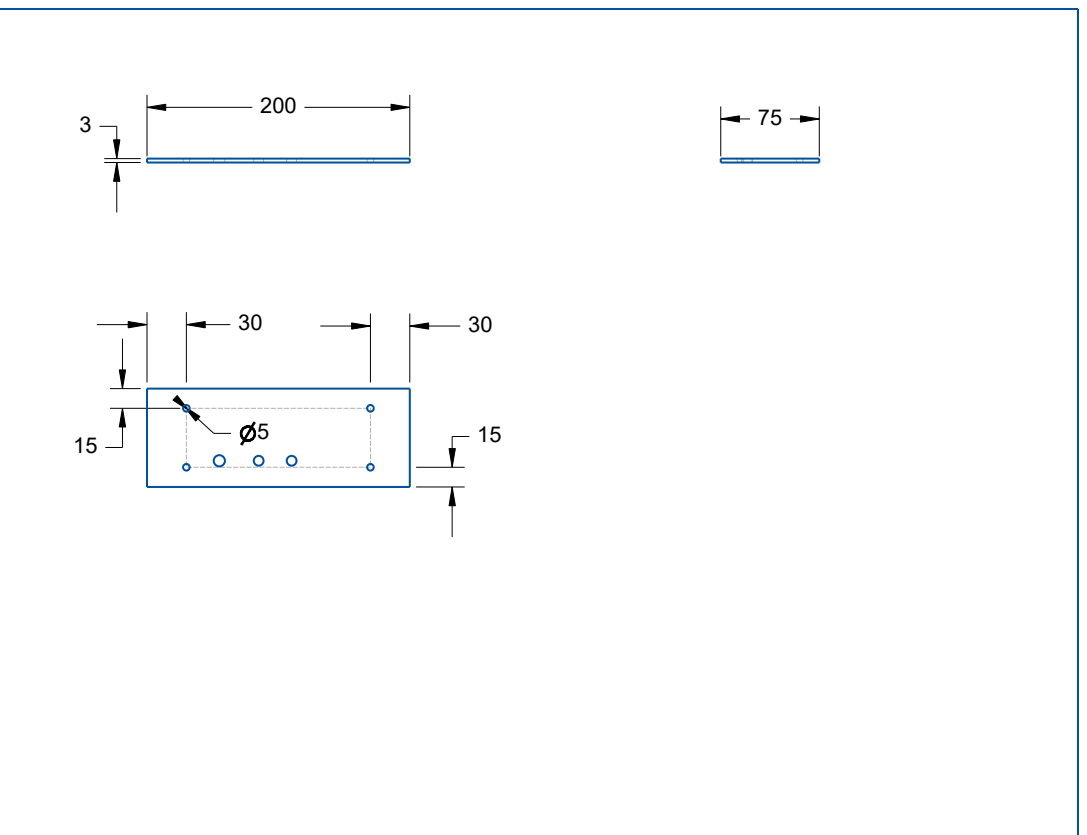
[picture p52: page 1]
