Eskdagoat/Qorvo_F24_SD/SD1_Fall24/Mechanical/ENCLOSURE/Drafts/PCB_interface_02.pdf

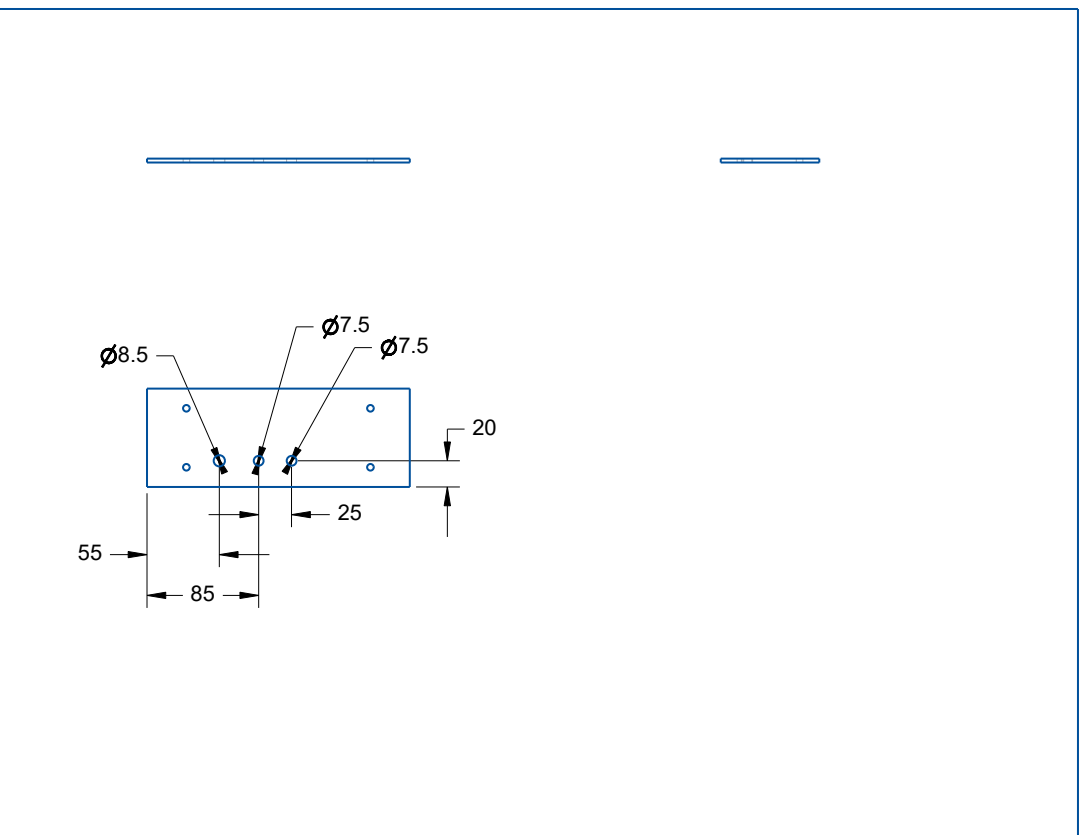
[picture p53: page 1]
