Eskdagoat/Qorvo_F24_SD/SD1_Fall24/Mechanical/ENCLOSURE/Drafts/Plain_Wall_01.pdf

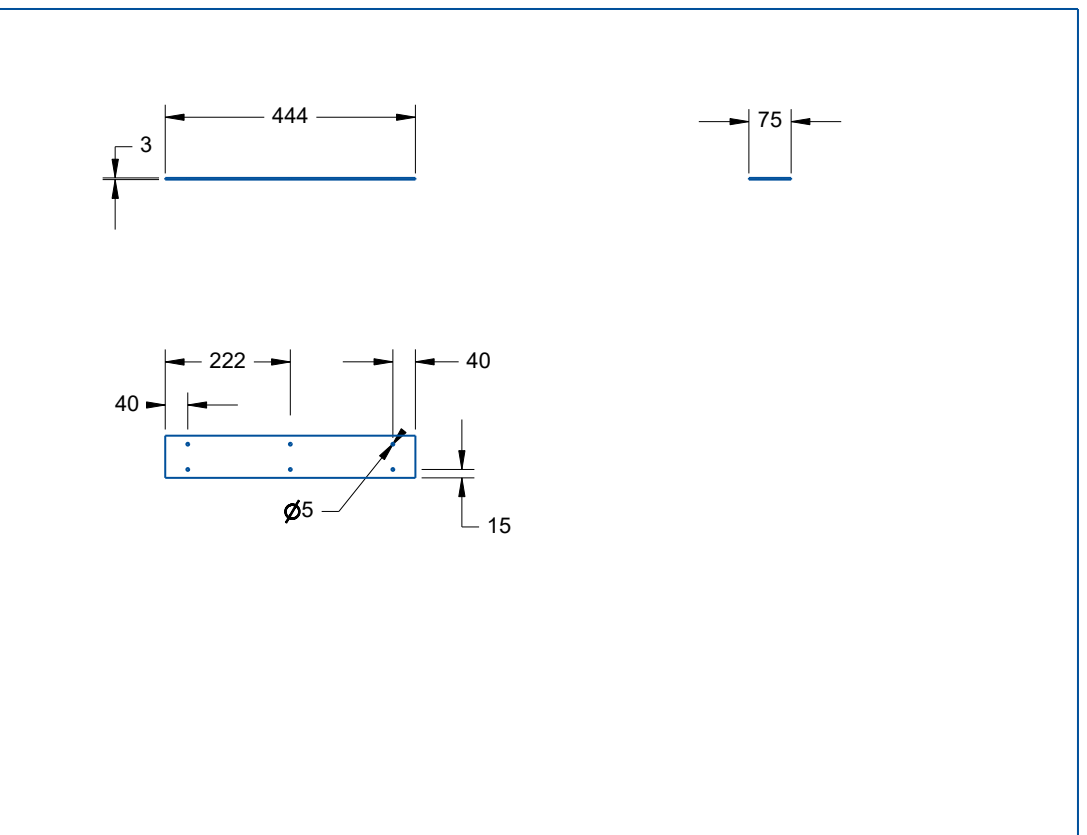
[picture p54: page 1]
