Eskdagoat/Qorvo_F24_SD/SD2_Spring25/Computer/ez7n_sdr_transceiver_with_clock.pdf

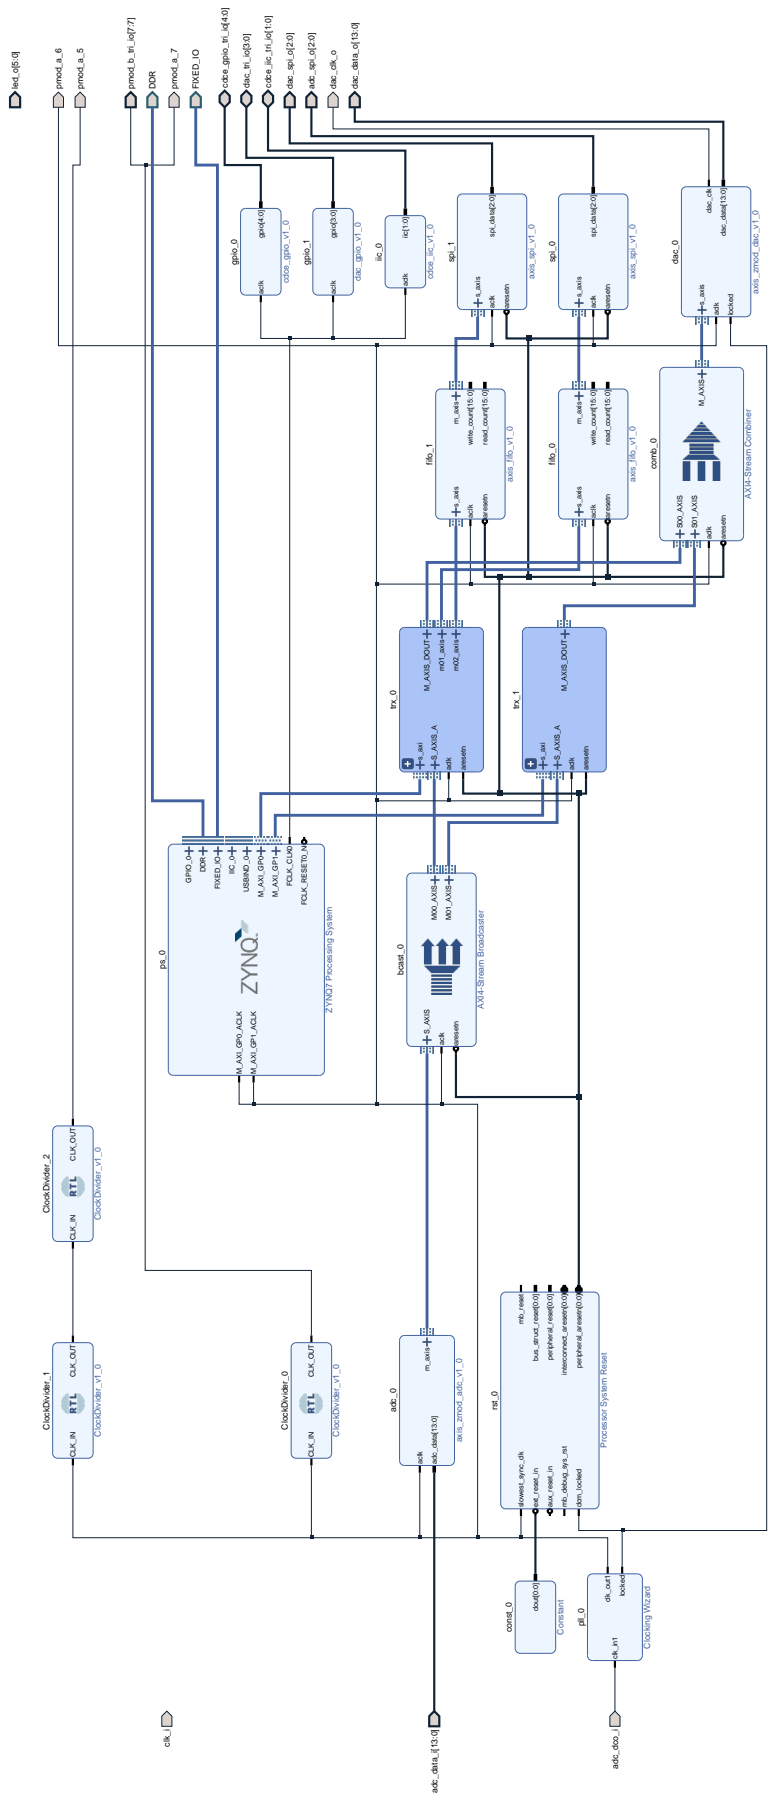
[picture p55: page 1]
ClockDivider_0; ClockDivider_v1_0; CLK_IN CLK_OUT; ClockDivider_1; ClockDivider_2; DDR; FIXED_IO; adc_data_i[13:0]; adc_spi_o[2:0]; adc_0; axis_zmod_adc_v1_0; m_axis; aclk; adc_data[13:0]; bcast_0; AXI4-Stream Broadcaster; S_AXIS M00_AXIS M01_AXIS; aresetn; cdce_gpio_tri_io[4:0]; cdce_iic_tri_io[1:0]; comb_0; AXI4-Stream Combiner; M_AXIS; S00_AXIS; S01_AXIS; const_0; Constant; dout[0:0]; dac_tri_io[3:0]; dac_spi_o[2:0]; dac_data_o[13:0]; dac_0; axis_zmod_dac_v1_0; s_axis; locked; dac_clk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

Processor System Reset
