Eskdagoat/Qorvo_F24_SD/SD1_Fall24/Electrical/BLOCK DIAGRAM/CDR_BLOCK_DIAGRAM.pdf

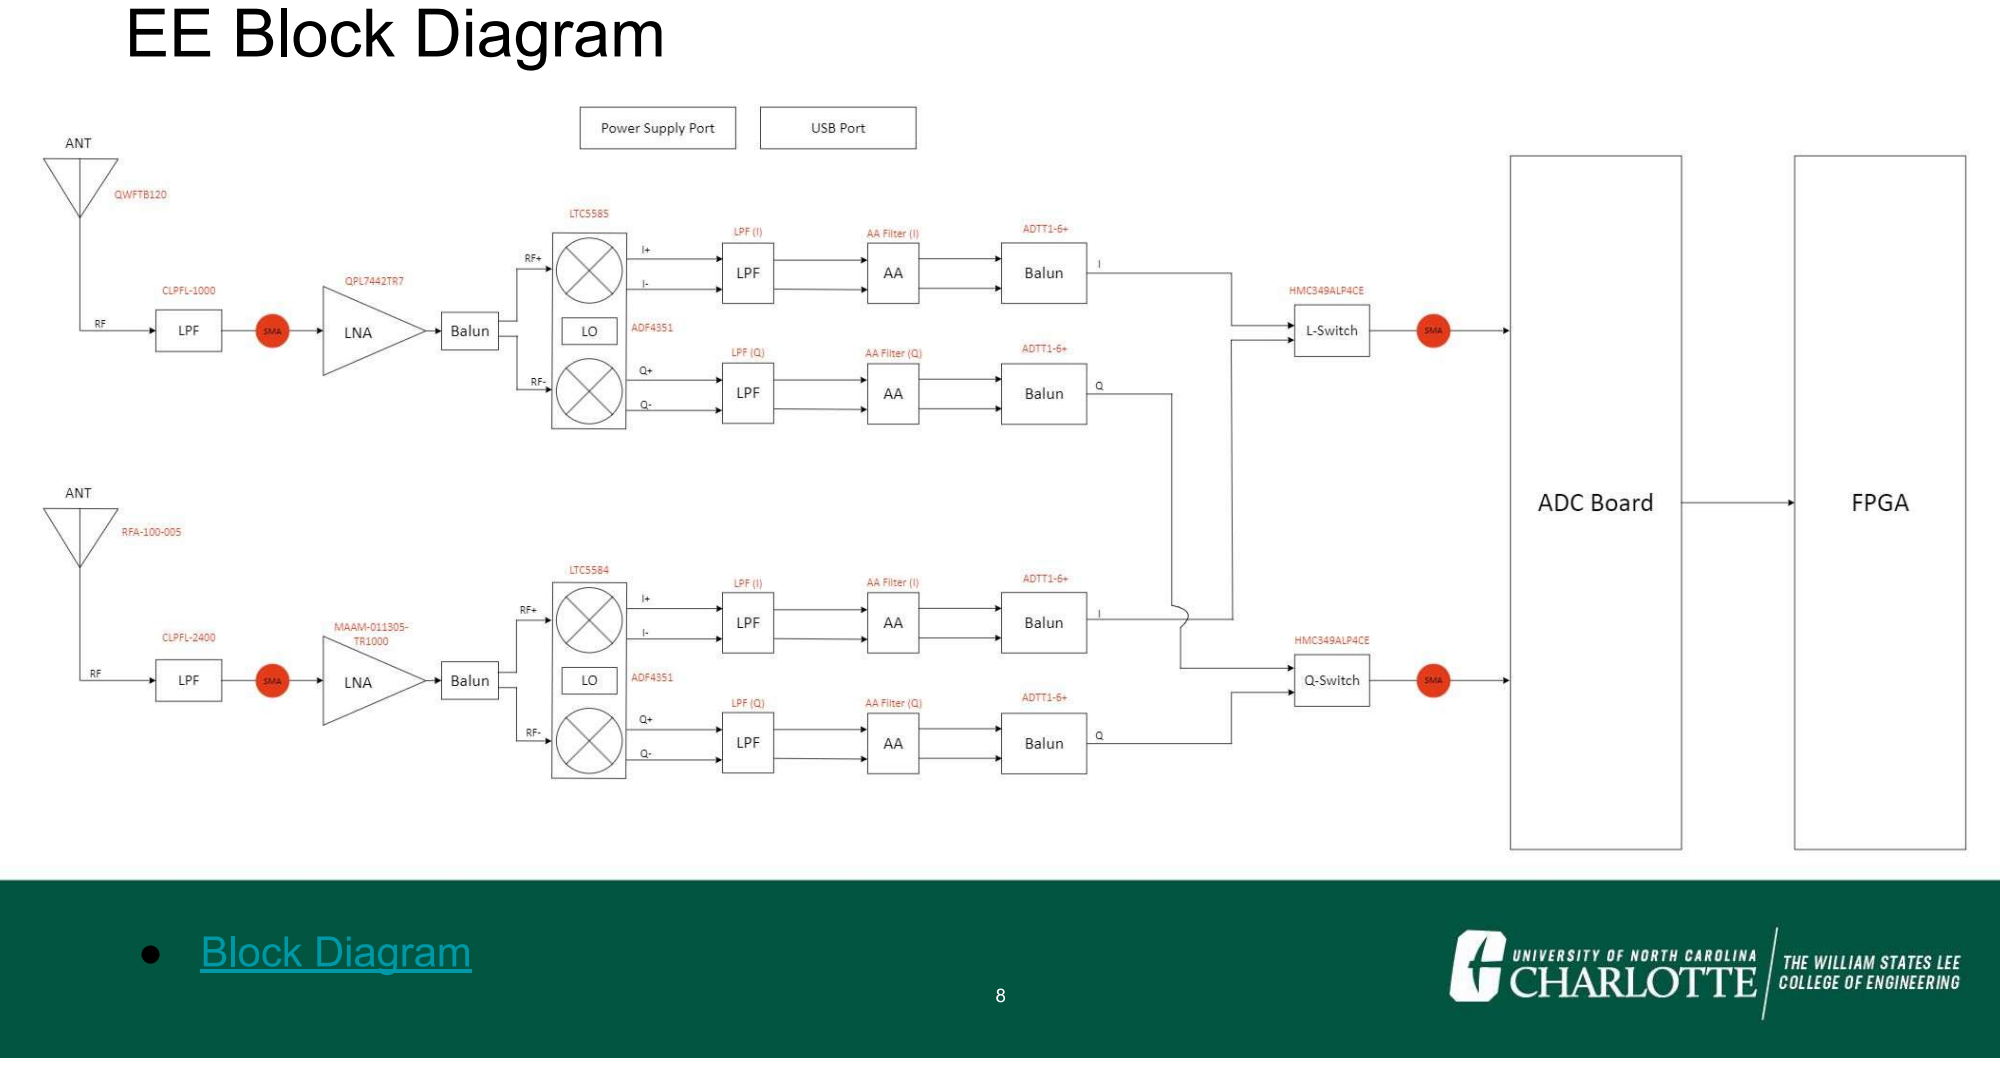
[picture p56: page 1]
