Eskdagoat/Qorvo_F24_SD/SD1_Fall24/Electrical/BLOCK DIAGRAM/INITIAL_BLOCK_DIAGRAM.pdf

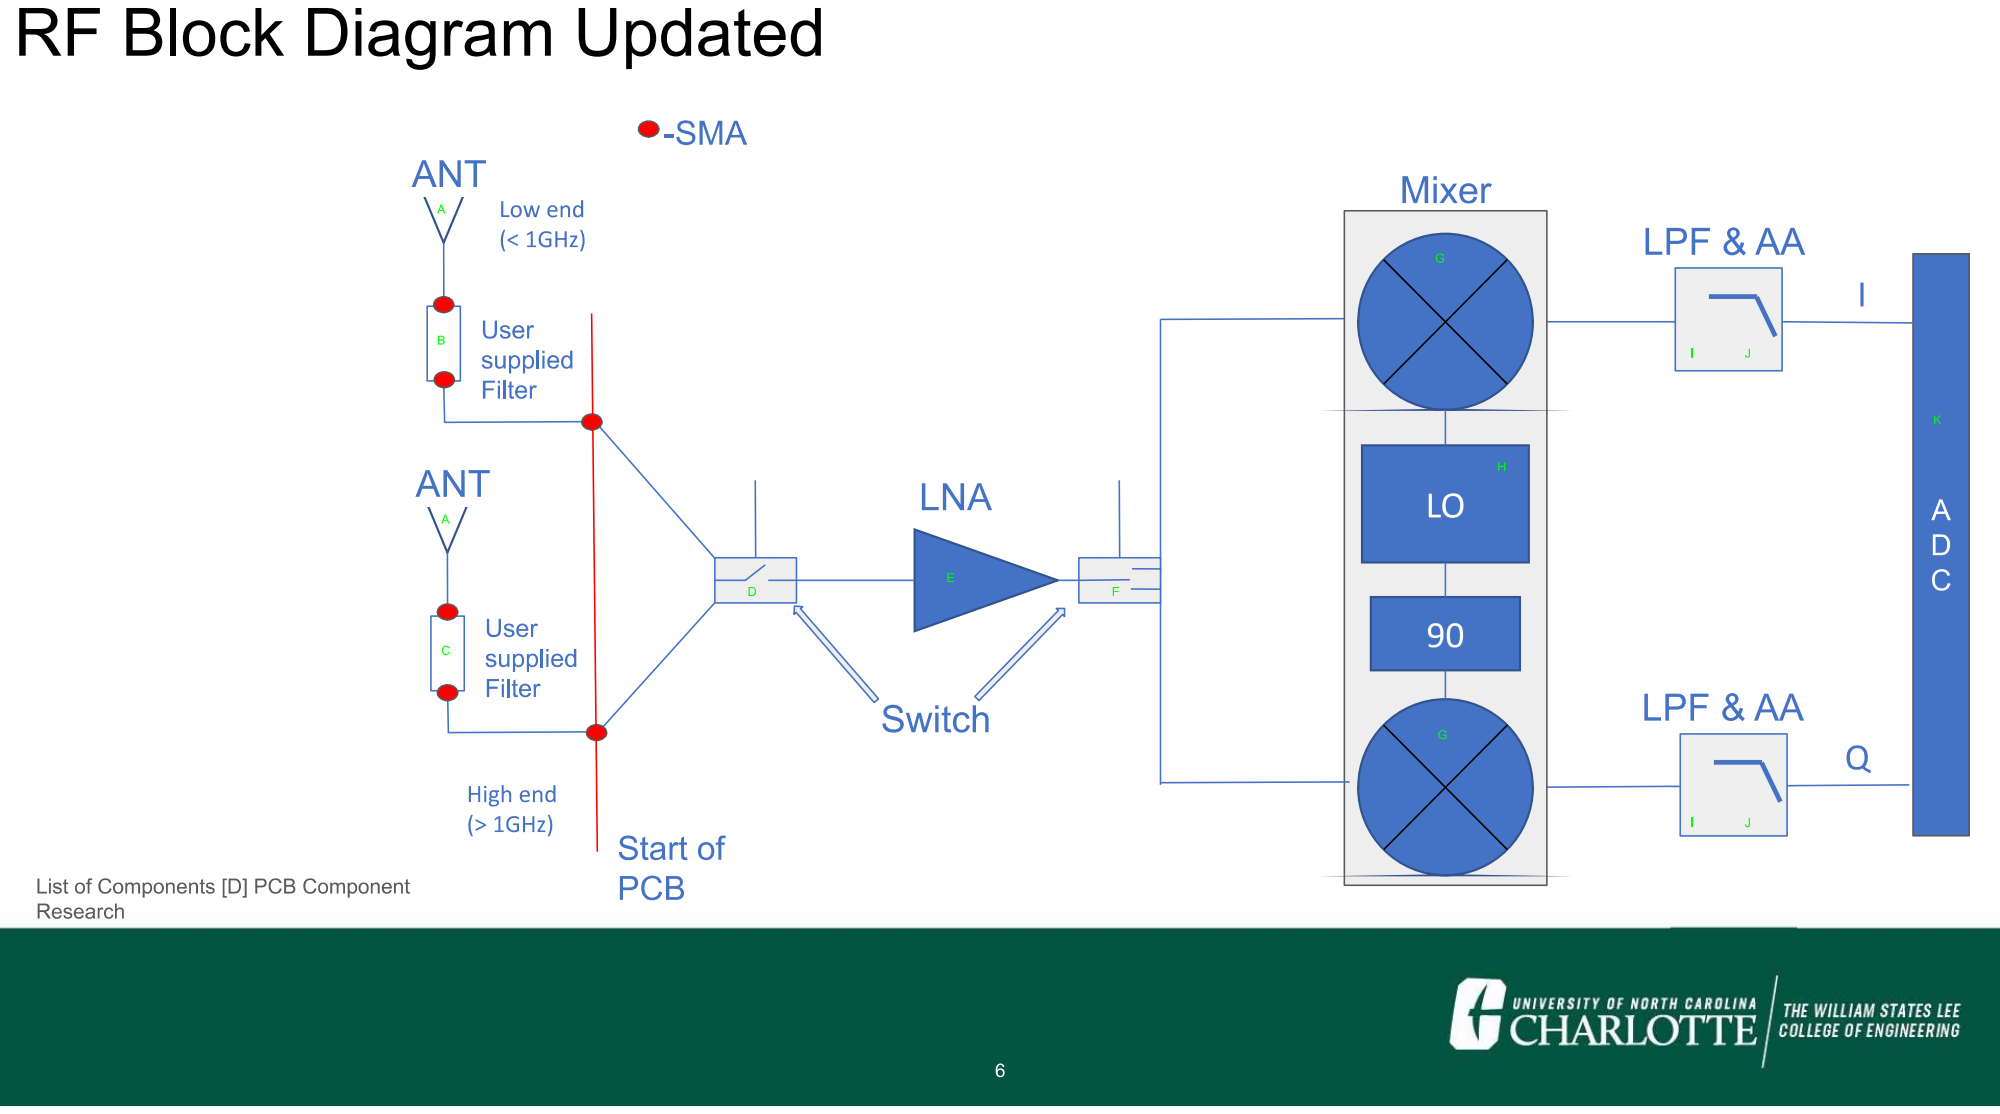
[picture p57: page 1]
