Eskdagoat/Qorvo_F24_SD/(list of files, drawings)

Other design files:
SD1_Fall24/Electrical/PCB/FOOTPRINT/QORVO_RADIO_FOOTPRINT_LIB.PcbLib
SD1_Fall24/Electrical/PCB/SCHEMATIC/QORVO_RADIO_SCHEMATIC_LIB.SchLib
SD1_Fall24/Electrical/PCB/SCHEMATIC/SCHEMATIC DOC/0.9V REG.SchDoc
SD1_Fall24/Electrical/PCB/SCHEMATIC/SCHEMATIC DOC/3.3v REG.SchDoc
SD1_Fall24/Electrical/PCB/SCHEMATIC/SCHEMATIC DOC/AA.SchDoc
SD1_Fall24/Electrical/PCB/SCHEMATIC/SCHEMATIC DOC/HE LNA.SchDoc
SD1_Fall24/Electrical/PCB/SCHEMATIC/SCHEMATIC DOC/HE Mixer.SchDoc
SD1_Fall24/Electrical/PCB/SCHEMATIC/SCHEMATIC DOC/LE LNA.SchDoc
SD1_Fall24/Electrical/PCB/SCHEMATIC/SCHEMATIC DOC/LE Mixer.SchDoc
SD1_Fall24/Electrical/PCB/SCHEMATIC/SCHEMATIC DOC/LO.SchDoc
SD1_Fall24/Electrical/PCB/SCHEMATIC/SCHEMATIC DOC/LPF.SchDoc
SD1_Fall24/Electrical/PCB/SCHEMATIC/SCHEMATIC DOC/SDR_SCHEMATIC.SchDoc
SD1_Fall24/Electrical/PCB/SCHEMATIC/SCHEMATIC DOC/SWITCH.SchDoc
