Eskdagoat/Qorvo_F24_SD/SD1_Fall24/Computer/Eclypse/Eclypse_Transceiver/Eclypse_Transceiver/Eclypse_Transceiver.runs/synth_1/.Xil/system_wrapper_propImpl.xdc

set_property SRC_FILE_INFO {cfile:/home/andrew/eclypse-z7-notes/tmp/sdr_transceiver.gen/sources_1/bd/system/ip/system_pll_0_0/system_pll_0_0.xdc rfile:../../../sdr_transceiver.gen/sources_1/bd/system/ip/system_pll_0_0/system_pll_0_0.xdc id:1 order:EARLY scoped_inst:system_i/pll_0/inst} [current_design]
set_property SRC_FILE_INFO {cfile:/home/andrew/eclypse-z7-notes/tmp/sdr_transceiver.gen/sources_1/bd/system/ip/system_ps_0_0/system_ps_0_0.xdc rfile:../../../sdr_transceiver.gen/sources_1/bd/system/ip/system_ps_0_0/system_ps_0_0.xdc id:2 order:EARLY scoped_inst:system_i/ps_0/inst} [current_design]
set_property SRC_FILE_INFO {cfile:/home/andrew/eclypse-z7-notes/tmp/sdr_transceiver.gen/sources_1/bd/system/ip/system_rst_0_0/system_rst_0_0.xdc rfile:../../../sdr_transceiver.gen/sources_1/bd/system/ip/system_rst_0_0/system_rst_0_0.xdc id:3 order:EARLY scoped_inst:system_i/rst_0/U0} [current_design]
set_property SRC_FILE_INFO {cfile:/home/andrew/eclypse-z7-notes/cfg/ports.xdc rfile:../../../../cfg/ports.xdc id:4} [current_design]
current_instance system_i/pll_0/inst
set_property src_info {type:SCOPED_XDC file:1 line:54 export:INPUT save:INPUT read:READ} [current_design]
set_input_jitter [get_clocks -of_objects [get_ports clk_in1]] 0.600
current_instance
current_instance system_i/ps_0/inst
set_property src_info {type:SCOPED_XDC file:2 line:21 export:INPUT save:INPUT read:READ} [current_design]
set_input_jitter clk_fpga_0 0.3
set_property src_info {type:SCOPED_XDC file:2 line:31 export:INPUT save:INPUT read:READ} [current_design]
set_property PACKAGE_PIN "C12" [get_ports "MIO[53]"]
set_property src_info {type:SCOPED_XDC file:2 line:38 export:INPUT save:INPUT read:READ} [current_design]
set_property PACKAGE_PIN "D10" [get_ports "MIO[52]"]
set_property src_info {type:SCOPED_XDC file:2 line:45 export:INPUT save:INPUT read:READ} [current_design]
set_property PACKAGE_PIN "C10" [get_ports "MIO[51]"]
set_property src_info {type:SCOPED_XDC file:2 line:52 export:INPUT save:INPUT read:READ} [current_design]
set_property PACKAGE_PIN "D13" [get_ports "MIO[50]"]
set_property src_info {type:SCOPED_XDC file:2 line:59 export:INPUT save:INPUT read:READ} [current_design]
set_property PACKAGE_PIN "C14" [get_ports "MIO[49]"]
set_property src_info {type:SCOPED_XDC file:2 line:66 export:INPUT save:INPUT read:READ} [current_design]
set_property PACKAGE_PIN "D11" [get_ports "MIO[48]"]
set_property src_info {type:SCOPED_XDC file:2 line:73 export:INPUT save:INPUT read:READ} [current_design]
set_property PACKAGE_PIN "B10" [get_ports "MIO[47]"]
set_property src_info {type:SCOPED_XDC file:2 line:80 export:INPUT save:INPUT read:READ} [current_design]
set_property PACKAGE_PIN "D12" [get_ports "MIO[46]"]
set_property src_info {type:SCOPED_XDC file:2 line:87 export:INPUT save:INPUT read:READ} [current_design]
set_property PACKAGE_PIN "B9" [get_ports "MIO[45]"]
set_property src_info {type:SCOPED_XDC file:2 line:94 export:INPUT save:INPUT read:READ} [current_design]
set_property PACKAGE_PIN "E13" [get_ports "MIO[44]"]
set_property src_info {type:SCOPED_XDC file:2 line:101 export:INPUT save:INPUT read:READ} [current_design]
set_property PACKAGE_PIN "B11" [get_ports "MIO[43]"]
set_property src_info {type:SCOPED_XDC file:2 line:108 export:INPUT save:INPUT read:READ} [current_design]
set_property PACKAGE_PIN "D8" [get_ports "MIO[42]"]
set_property src_info {type:SCOPED_XDC file:2 line:115 export:INPUT save:INPUT read:READ} [current_design]
set_property PACKAGE_PIN "C8" [get_ports "MIO[41]"]
set_property src_info {type:SCOPED_XDC file:2 line:122 export:INPUT save:INPUT read:READ} [current_design]
set_property PACKAGE_PIN "E14" [get_ports "MIO[40]"]
set_property src_info {type:SCOPED_XDC file:2 line:129 export:INPUT save:INPUT read:READ} [current_design]
set_property PACKAGE_PIN "C13" [get_ports "MIO[39]"]
set_property src_info {type:SCOPED_XDC file:2 line:136 export:INPUT save:INPUT read:READ} [current_design]
set_property PACKAGE_PIN "F13" [get_ports "MIO[38]"]
set_property src_info {type:SCOPED_XDC file:2 line:143 export:INPUT save:INPUT read:READ} [current_design]
set_property PACKAGE_PIN "B14" [get_ports "MIO[37]"]
set_property src_info {type:SCOPED_XDC file:2 line:150 export:INPUT save:INPUT read:READ} [current_design]
set_property PACKAGE_PIN "A9" [get_ports "MIO[36]"]
set_property src_info {type:SCOPED_XDC file:2 line:157 export:INPUT save:INPUT read:READ} [current_design]
set_property PACKAGE_PIN "F14" [get_ports "MIO[35]"]
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
set_property src_info {type:SCOPED_XDC file:2 line:344 export:INPUT save:INPUT read:READ} [current_design]
set_property PACKAGE_PIN "E5" [get_ports "MIO[8]"]
set_property src_info {type:SCOPED_XDC file:2 line:350 export:INPUT save:INPUT read:READ} [current_design]
set_property PACKAGE_PIN "D5" [get_ports "MIO[7]"]
set_property src_info {type:SCOPED_XDC file:2 line:356 export:INPUT save:INPUT read:READ} [current_design]
set_property PACKAGE_PIN "A4" [get_ports "MIO[6]"]
set_property src_info {type:SCOPED_XDC file:2 line:362 export:INPUT save:INPUT read:READ} [current_design]
set_property PACKAGE_PIN "A3" [get_ports "MIO[5]"]
set_property src_info {type:SCOPED_XDC file:2 line:368 export:INPUT save:INPUT read:READ} [current_design]
set_property PACKAGE_PIN "E4" [get_ports "MIO[4]"]
set_property src_info {type:SCOPED_XDC file:2 line:374 export:INPUT save:INPUT read:READ} [current_design]
set_property PACKAGE_PIN "F6" [get_ports "MIO[3]"]
set_property src_info {type:SCOPED_XDC file:2 line:380 export:INPUT save:INPUT read:READ} [current_design]
set_property PACKAGE_PIN "A2" [get_ports "MIO[2]"]
set_property src_info {type:SCOPED_XDC file:2 line:386 export:INPUT save:INPUT read:READ} [current_design]
set_property PACKAGE_PIN "A1" [get_ports "MIO[1]"]
set_property src_info {type:SCOPED_XDC file:2 line:393 export:INPUT save:INPUT read:READ} [current_design]
set_property PACKAGE_PIN "G6" [get_ports "MIO[0]"]
set_property src_info {type:SCOPED_XDC file:2 line:399 export:INPUT save:INPUT read:READ} [current_design]
set_property PACKAGE_PIN "N7" [get_ports "DDR_VRP"]
set_property src_info {type:SCOPED_XDC file:2 line:403 export:INPUT save:INPUT read:READ} [current_design]
set_property PACKAGE_PIN "M7" [get_ports "DDR_VRN"]
set_property src_info {type:SCOPED_XDC file:2 line:407 export:INPUT save:INPUT read:READ} [current_design]
set_property PACKAGE_PIN "R4" [get_ports "DDR_WEB"]
set_property src_info {type:SCOPED_XDC file:2 line:411 export:INPUT save:INPUT read:READ} [current_design]
set_property PACKAGE_PIN "R5" [get_ports "DDR_RAS_n"]
set_property src_info {type:SCOPED_XDC file:2 line:415 export:INPUT save:INPUT read:READ} [current_design]
set_property PACKAGE_PIN "P5" [get_ports "DDR_ODT"]
set_property src_info {type:SCOPED_XDC file:2 line:419 export:INPUT save:INPUT read:READ} [current_design]
set_property PACKAGE_PIN "F3" [get_ports "DDR_DRSTB"]
set_property src_info {type:SCOPED_XDC file:2 line:423 export:INPUT save:INPUT read:READ} [current_design]
set_property PACKAGE_PIN "V2" [get_ports "DDR_DQS[3]"]
set_property src_info {type:SCOPED_XDC file:2 line:427 export:INPUT save:INPUT read:READ} [current_design]
set_property PACKAGE_PIN "N2" [get_ports "DDR_DQS[2]"]
set_property src_info {type:SCOPED_XDC file:2 line:431 export:INPUT save:INPUT read:READ} [current_design]
set_property PACKAGE_PIN "H2" [get_ports "DDR_DQS[1]"]
set_property src_info {type:SCOPED_XDC file:2 line:435 export:INPUT save:INPUT read:READ} [current_design]
set_property PACKAGE_PIN "C2" [get_ports "DDR_DQS[0]"]
set_property src_info {type:SCOPED_XDC file:2 line:439 export:INPUT save:INPUT read:READ} [current_design]
set_property PACKAGE_PIN "W2" [get_ports "DDR_DQS_n[3]"]
set_property src_info {type:SCOPED_XDC file:2 line:443 export:INPUT save:INPUT read:READ} [current_design]
set_property PACKAGE_PIN "P2" [get_ports "DDR_DQS_n[2]"]
set_property src_info {type:SCOPED_XDC file:2 line:447 export:INPUT save:INPUT read:READ} [current_design]
set_property PACKAGE_PIN "J2" [get_ports "DDR_DQS_n[1]"]
set_property src_info {type:SCOPED_XDC file:2 line:451 export:INPUT save:INPUT read:READ} [current_design]
set_property PACKAGE_PIN "D2" [get_ports "DDR_DQS_n[0]"]
set_property src_info {type:SCOPED_XDC file:2 line:455 export:INPUT save:INPUT read:READ} [current_design]
set_property PACKAGE_PIN "G1" [get_ports "DDR_DQ[9]"]
set_property src_info {type:SCOPED_XDC file:2 line:459 export:INPUT save:INPUT read:READ} [current_design]
set_property PACKAGE_PIN "G2" [get_ports "DDR_DQ[8]"]
set_property src_info {type:SCOPED_XDC file:2 line:463 export:INPUT save:INPUT read:READ} [current_design]
set_property PACKAGE_PIN "F1" [get_ports "DDR_DQ[7]"]
set_property src_info {type:SCOPED_XDC file:2 line:467 export:INPUT save:INPUT read:READ} [current_design]
set_property PACKAGE_PIN "F2" [get_ports "DDR_DQ[6]"]
set_property src_info {type:SCOPED_XDC file:2 line:471 export:INPUT save:INPUT read:READ} [current_design]
set_property PACKAGE_PIN "E1" [get_ports "DDR_DQ[5]"]
set_property src_info {type:SCOPED_XDC file:2 line:475 export:INPUT save:INPUT read:READ} [current_design]
set_property PACKAGE_PIN "E3" [get_ports "DDR_DQ[4]"]
set_property src_info {type:SCOPED_XDC file:2 line:479 export:INPUT save:INPUT read:READ} [current_design]
set_property PACKAGE_PIN "D3" [get_ports "DDR_DQ[3]"]
set_property src_info {type:SCOPED_XDC file:2 line:483 export:INPUT save:INPUT read:READ} [current_design]
set_property PACKAGE_PIN "Y1" [get_ports "DDR_DQ[31]"]
set_property src_info {type:SCOPED_XDC file:2 line:487 export:INPUT save:INPUT read:READ} [current_design]
set_property PACKAGE_PIN "W3" [get_ports "DDR_DQ[30]"]
set_property src_info {type:SCOPED_XDC file:2 line:491 export:INPUT save:INPUT read:READ} [current_design]
set_property PACKAGE_PIN "B2" [get_ports "DDR_DQ[2]"]
set_property src_info {type:SCOPED_XDC file:2 line:495 export:INPUT save:INPUT read:READ} [current_design]
set_property PACKAGE_PIN "Y3" [get_ports "DDR_DQ[29]"]
set_property src_info {type:SCOPED_XDC file:2 line:499 export:INPUT save:INPUT read:READ} [current_design]
set_property PACKAGE_PIN "W1" [get_ports "DDR_DQ[28]"]
set_property src_info {type:SCOPED_XDC file:2 line:503 export:INPUT save:INPUT read:READ} [current_design]
set_property PACKAGE_PIN "U2" [get_ports "DDR_DQ[27]"]
set_property src_info {type:SCOPED_XDC file:2 line:507 export:INPUT save:INPUT read:READ} [current_design]
set_property PACKAGE_PIN "AA1" [get_ports "DDR_DQ[26]"]
set_property src_info {type:SCOPED_XDC file:2 line:511 export:INPUT save:INPUT read:READ} [current_design]
set_property PACKAGE_PIN "U1" [get_ports "DDR_DQ[25]"]
set_property src_info {type:SCOPED_XDC file:2 line:515 export:INPUT save:INPUT read:READ} [current_design]
set_property PACKAGE_PIN "AA3" [get_ports "DDR_DQ[24]"]
set_property src_info {type:SCOPED_XDC file:2 line:519 export:INPUT save:INPUT read:READ} [current_design]
set_property PACKAGE_PIN "R1" [get_ports "DDR_DQ[23]"]
set_property src_info {type:SCOPED_XDC file:2 line:523 export:INPUT save:INPUT read:READ} [current_design]
set_property PACKAGE_PIN "M2" [get_ports "DDR_DQ[22]"]
set_property src_info {type:SCOPED_XDC file:2 line:527 export:INPUT save:INPUT read:READ} [current_design]
set_property PACKAGE_PIN "T2" [get_ports "DDR_DQ[21]"]
set_property src_info {type:SCOPED_XDC file:2 line:531 export:INPUT save:INPUT read:READ} [current_design]
set_property PACKAGE_PIN "R3" [get_ports "DDR_DQ[20]"]
set_property src_info {type:SCOPED_XDC file:2 line:535 export:INPUT save:INPUT read:READ} [current_design]
set_property PACKAGE_PIN "C3" [get_ports "DDR_DQ[1]"]
set_property src_info {type:SCOPED_XDC file:2 line:539 export:INPUT save:INPUT read:READ} [current_design]
set_property PACKAGE_PIN "T1" [get_ports "DDR_DQ[19]"]
set_property src_info {type:SCOPED_XDC file:2 line:543 export:INPUT save:INPUT read:READ} [current_design]
set_property PACKAGE_PIN "N3" [get_ports "DDR_DQ[18]"]
set_property src_info {type:SCOPED_XDC file:2 line:547 export:INPUT save:INPUT read:READ} [current_design]
set_property PACKAGE_PIN "T3" [get_ports "DDR_DQ[17]"]
set_property src_info {type:SCOPED_XDC file:2 line:551 export:INPUT save:INPUT read:READ} [current_design]
set_property PACKAGE_PIN "M1" [get_ports "DDR_DQ[16]"]
set_property src_info {type:SCOPED_XDC file:2 line:555 export:INPUT save:INPUT read:READ} [current_design]
set_property PACKAGE_PIN "K3" [get_ports "DDR_DQ[15]"]
set_property src_info {type:SCOPED_XDC file:2 line:559 export:INPUT save:INPUT read:READ} [current_design]
set_property PACKAGE_PIN "J1" [get_ports "DDR_DQ[14]"]
set_property src_info {type:SCOPED_XDC file:2 line:563 export:INPUT save:INPUT read:READ} [current_design]
set_property PACKAGE_PIN "K1" [get_ports "DDR_DQ[13]"]
set_property src_info {type:SCOPED_XDC file:2 line:567 export:INPUT save:INPUT read:READ} [current_design]
set_property PACKAGE_PIN "L3" [get_ports "DDR_DQ[12]"]
set_property src_info {type:SCOPED_XDC file:2 line:571 export:INPUT save:INPUT read:READ} [current_design]
set_property PACKAGE_PIN "L2" [get_ports "DDR_DQ[11]"]
set_property src_info {type:SCOPED_XDC file:2 line:575 export:INPUT save:INPUT read:READ} [current_design]
set_property PACKAGE_PIN "L1" [get_ports "DDR_DQ[10]"]
set_property src_info {type:SCOPED_XDC file:2 line:579 export:INPUT save:INPUT read:READ} [current_design]
set_property PACKAGE_PIN "D1" [get_ports "DDR_DQ[0]"]
set_property src_info {type:SCOPED_XDC file:2 line:583 export:INPUT save:INPUT read:READ} [current_design]
set_property PACKAGE_PIN "AA2" [get_ports "DDR_DM[3]"]
set_property src_info {type:SCOPED_XDC file:2 line:587 export:INPUT save:INPUT read:READ} [current_design]
set_property PACKAGE_PIN "P1" [get_ports "DDR_DM[2]"]
set_property src_info {type:SCOPED_XDC file:2 line:591 export:INPUT save:INPUT read:READ} [current_design]
set_property PACKAGE_PIN "H3" [get_ports "DDR_DM[1]"]
set_property src_info {type:SCOPED_XDC file:2 line:595 export:INPUT save:INPUT read:READ} [current_design]
set_property PACKAGE_PIN "B1" [get_ports "DDR_DM[0]"]
set_property src_info {type:SCOPED_XDC file:2 line:599 export:INPUT save:INPUT read:READ} [current_design]
set_property PACKAGE_PIN "P6" [get_ports "DDR_CS_n"]
set_property src_info {type:SCOPED_XDC file:2 line:603 export:INPUT save:INPUT read:READ} [current_design]
set_property PACKAGE_PIN "V3" [get_ports "DDR_CKE"]
set_property src_info {type:SCOPED_XDC file:2 line:607 export:INPUT save:INPUT read:READ} [current_design]
set_property PACKAGE_PIN "N4" [get_ports "DDR_Clk"]
set_property src_info {type:SCOPED_XDC file:2 line:611 export:INPUT save:INPUT read:READ} [current_design]
set_property PACKAGE_PIN "N5" [get_ports "DDR_Clk_n"]
set_property src_info {type:SCOPED_XDC file:2 line:615 export:INPUT save:INPUT read:READ} [current_design]
set_property PACKAGE_PIN "P3" [get_ports "DDR_CAS_n"]
set_property src_info {type:SCOPED_XDC file:2 line:619 export:INPUT save:INPUT read:READ} [current_design]
set_property PACKAGE_PIN "M6" [get_ports "DDR_BankAddr[2]"]
set_property src_info {type:SCOPED_XDC file:2 line:623 export:INPUT save:INPUT read:READ} [current_design]
set_property PACKAGE_PIN "L6" [get_ports "DDR_BankAddr[1]"]
set_property src_info {type:SCOPED_XDC file:2 line:627 export:INPUT save:INPUT read:READ} [current_design]
set_property PACKAGE_PIN "L7" [get_ports "DDR_BankAddr[0]"]
set_property src_info {type:SCOPED_XDC file:2 line:631 export:INPUT save:INPUT read:READ} [current_design]
set_property PACKAGE_PIN "H5" [get_ports "DDR_Addr[9]"]
set_property src_info {type:SCOPED_XDC file:2 line:635 export:INPUT save:INPUT read:READ} [current_design]
set_property PACKAGE_PIN "J5" [get_ports "DDR_Addr[8]"]
set_property src_info {type:SCOPED_XDC file:2 line:639 export:INPUT save:INPUT read:READ} [current_design]
set_property PACKAGE_PIN "J6" [get_ports "DDR_Addr[7]"]
set_property src_info {type:SCOPED_XDC file:2 line:643 export:INPUT save:INPUT read:READ} [current_design]
set_property PACKAGE_PIN "J7" [get_ports "DDR_Addr[6]"]
set_property src_info {type:SCOPED_XDC file:2 line:647 export:INPUT save:INPUT read:READ} [current_design]
set_property PACKAGE_PIN "K5" [get_ports "DDR_Addr[5]"]
set_property src_info {type:SCOPED_XDC file:2 line:651 export:INPUT save:INPUT read:READ} [current_design]
set_property PACKAGE_PIN "K6" [get_ports "DDR_Addr[4]"]
set_property src_info {type:SCOPED_XDC file:2 line:655 export:INPUT save:INPUT read:READ} [current_design]
set_property PACKAGE_PIN "L4" [get_ports "DDR_Addr[3]"]
set_property src_info {type:SCOPED_XDC file:2 line:659 export:INPUT save:INPUT read:READ} [current_design]
set_property PACKAGE_PIN "K4" [get_ports "DDR_Addr[2]"]
set_property src_info {type:SCOPED_XDC file:2 line:663 export:INPUT save:INPUT read:READ} [current_design]
set_property PACKAGE_PIN "M5" [get_ports "DDR_Addr[1]"]
set_property src_info {type:SCOPED_XDC file:2 line:667 export:INPUT save:INPUT read:READ} [current_design]
set_property PACKAGE_PIN "G4" [get_ports "DDR_Addr[14]"]
set_property src_info {type:SCOPED_XDC file:2 line:671 export:INPUT save:INPUT read:READ} [current_design]
set_property PACKAGE_PIN "F4" [get_ports "DDR_Addr[13]"]
set_property src_info {type:SCOPED_XDC file:2 line:675 export:INPUT save:INPUT read:READ} [current_design]
set_property PACKAGE_PIN "H4" [get_ports "DDR_Addr[12]"]
set_property src_info {type:SCOPED_XDC file:2 line:679 export:INPUT save:INPUT read:READ} [current_design]
set_property PACKAGE_PIN "G5" [get_ports "DDR_Addr[11]"]
set_property src_info {type:SCOPED_XDC file:2 line:683 export:INPUT save:INPUT read:READ} [current_design]
set_property PACKAGE_PIN "J3" [get_ports "DDR_Addr[10]"]
set_property src_info {type:SCOPED_XDC file:2 line:687 export:INPUT save:INPUT read:READ} [current_design]
set_property PACKAGE_PIN "M4" [get_ports "DDR_Addr[0]"]
set_property src_info {type:SCOPED_XDC file:2 line:691 export:INPUT save:INPUT read:READ} [current_design]
set_property PACKAGE_PIN "B5" [get_ports "PS_PORB"]
set_property src_info {type:SCOPED_XDC file:2 line:694 export:INPUT save:INPUT read:READ} [current_design]
set_property PACKAGE_PIN "C9" [get_ports "PS_SRSTB"]
set_property src_info {type:SCOPED_XDC file:2 line:697 export:INPUT save:INPUT read:READ} [current_design]
set_property PACKAGE_PIN "F7" [get_ports "PS_CLK"]
current_instance
current_instance system_i/rst_0/U0
set_property src_info {type:SCOPED_XDC file:3 line:50 export:INPUT save:INPUT read:READ} [current_design]
create_waiver -type CDC -id {CDC-11} -user "proc_sys_reset" -desc "Timing uncritical paths" -tags "1171415" -scope -internal -to [get_pins -quiet -filter REF_PIN_NAME=~*D -of_objects [get_cells -hierarchical -filter {NAME =~ */ACTIVE_LOW_AUX.ACT_LO_AUX/GENERATE_LEVEL_P_S_CDC.SINGLE_BIT.CROSS_PLEVEL_IN2SCNDRY_IN_cdc_to}]]
current_instance
set_property src_info {type:XDC file:4 line:4 export:INPUT save:INPUT read:READ} [current_design]
set_property PACKAGE_PIN D18 [get_ports clk_i]
set_property src_info {type:XDC file:4 line:12 export:INPUT save:INPUT read:READ} [current_design]
set_property PACKAGE_PIN B17 [get_ports {led_o[0]}]
set_property src_info {type:XDC file:4 line:13 export:INPUT save:INPUT read:READ} [current_design]
set_property PACKAGE_PIN B16 [get_ports {led_o[1]}]
set_property src_info {type:XDC file:4 line:14 export:INPUT save:INPUT read:READ} [current_design]
set_property PACKAGE_PIN A17 [get_ports {led_o[2]}]
set_property src_info {type:XDC file:4 line:15 export:INPUT save:INPUT read:READ} [current_design]
set_property PACKAGE_PIN A19 [get_ports {led_o[3]}]
set_property src_info {type:XDC file:4 line:16 export:INPUT save:INPUT read:READ} [current_design]
set_property PACKAGE_PIN A18 [get_ports {led_o[4]}]
set_property src_info {type:XDC file:4 line:17 export:INPUT save:INPUT read:READ} [current_design]
set_property PACKAGE_PIN A16 [get_ports {led_o[5]}]
set_property src_info {type:XDC file:4 line:23 export:INPUT save:INPUT read:READ} [current_design]
set_property PACKAGE_PIN B15 [get_ports {pmod_a_tri_io[0]}]
set_property src_info {type:XDC file:4 line:24 export:INPUT save:INPUT read:READ} [current_design]
set_property PACKAGE_PIN C15 [get_ports {pmod_a_tri_io[1]}]
set_property src_info {type:XDC file:4 line:25 export:INPUT save:INPUT read:READ} [current_design]
set_property PACKAGE_PIN D15 [get_ports {pmod_a_tri_io[2]}]
set_property src_info {type:XDC file:4 line:26 export:INPUT save:INPUT read:READ} [current_design]
set_property PACKAGE_PIN E16 [get_ports {pmod_a_tri_io[3]}]
set_property src_info {type:XDC file:4 line:27 export:INPUT save:INPUT read:READ} [current_design]
set_property PACKAGE_PIN E15 [get_ports {pmod_a_tri_io[4]}]
set_property src_info {type:XDC file:4 line:28 export:INPUT save:INPUT read:READ} [current_design]
set_property PACKAGE_PIN F17 [get_ports {pmod_a_tri_io[5]}]
set_property src_info {type:XDC file:4 line:29 export:INPUT save:INPUT read:READ} [current_design]
set_property PACKAGE_PIN F16 [get_ports {pmod_a_tri_io[6]}]
set_property src_info {type:XDC file:4 line:30 export:INPUT save:INPUT read:READ} [current_design]
set_property PACKAGE_PIN G16 [get_ports {pmod_a_tri_io[7]}]
set_property src_info {type:XDC file:4 line:34 export:INPUT save:INPUT read:READ} [current_design]
set_property PACKAGE_PIN G15 [get_ports {pmod_b_tri_io[0]}]
set_property src_info {type:XDC file:4 line:35 export:INPUT save:INPUT read:READ} [current_design]
set_property PACKAGE_PIN D16 [get_ports {pmod_b_tri_io[1]}]
set_property src_info {type:XDC file:4 line:36 export:INPUT save:INPUT read:READ} [current_design]
set_property PACKAGE_PIN D17 [get_ports {pmod_b_tri_io[2]}]
set_property src_info {type:XDC file:4 line:37 export:INPUT save:INPUT read:READ} [current_design]
set_property PACKAGE_PIN E18 [get_ports {pmod_b_tri_io[3]}]
set_property src_info {type:XDC file:4 line:38 export:INPUT save:INPUT read:READ} [current_design]
set_property PACKAGE_PIN F18 [get_ports {pmod_b_tri_io[4]}]
set_property src_info {type:XDC file:4 line:39 export:INPUT save:INPUT read:READ} [current_design]
set_property PACKAGE_PIN G17 [get_ports {pmod_b_tri_io[5]}]
set_property src_info {type:XDC file:4 line:40 export:INPUT save:INPUT read:READ} [current_design]
set_property PACKAGE_PIN H18 [get_ports {pmod_b_tri_io[6]}]
set_property src_info {type:XDC file:4 line:41 export:INPUT save:INPUT read:READ} [current_design]
set_property PACKAGE_PIN H17 [get_ports {pmod_b_tri_io[7]}]
set_property src_info {type:XDC file:4 line:47 export:INPUT save:INPUT read:READ} [current_design]
set_property PACKAGE_PIN N22 [get_ports {adc_data_i[0]}]
set_property src_info {type:XDC file:4 line:48 export:INPUT save:INPUT read:READ} [current_design]
set_property PACKAGE_PIN L21 [get_ports {adc_data_i[1]}]
set_property src_info {type:XDC file:4 line:49 export:INPUT save:INPUT read:READ} [current_design]
set_property PACKAGE_PIN R16 [get_ports {adc_data_i[2]}]
set_property src_info {type:XDC file:4 line:50 export:INPUT save:INPUT read:READ} [current_design]
set_property PACKAGE_PIN J18 [get_ports {adc_data_i[3]}]
set_property src_info {type:XDC file:4 line:51 export:INPUT save:INPUT read:READ} [current_design]
set_property PACKAGE_PIN K18 [get_ports {adc_data_i[4]}]
set_property src_info {type:XDC file:4 line:52 export:INPUT save:INPUT read:READ} [current_design]
set_property PACKAGE_PIN L19 [get_ports {adc_data_i[5]}]
set_property src_info {type:XDC file:4 line:53 export:INPUT save:INPUT read:READ} [current_design]
set_property PACKAGE_PIN L18 [get_ports {adc_data_i[6]}]
set_property src_info {type:XDC file:4 line:54 export:INPUT save:INPUT read:READ} [current_design]
set_property PACKAGE_PIN L22 [get_ports {adc_data_i[7]}]
set_property src_info {type:XDC file:4 line:55 export:INPUT save:INPUT read:READ} [current_design]
set_property PACKAGE_PIN K20 [get_ports {adc_data_i[8]}]
set_property src_info {type:XDC file:4 line:56 export:INPUT save:INPUT read:READ} [current_design]
set_property PACKAGE_PIN P16 [get_ports {adc_data_i[9]}]
set_property src_info {type:XDC file:4 line:57 export:INPUT save:INPUT read:READ} [current_design]
set_property PACKAGE_PIN K19 [get_ports {adc_data_i[10]}]
set_property src_info {type:XDC file:4 line:58 export:INPUT save:INPUT read:READ} [current_design]
set_property PACKAGE_PIN J22 [get_ports {adc_data_i[11]}]
set_property src_info {type:XDC file:4 line:59 export:INPUT save:INPUT read:READ} [current_design]
set_property PACKAGE_PIN J21 [get_ports {adc_data_i[12]}]
set_property src_info {type:XDC file:4 line:60 export:INPUT save:INPUT read:READ} [current_design]
set_property PACKAGE_PIN P22 [get_ports {adc_data_i[13]}]
set_property src_info {type:XDC file:4 line:63 export:INPUT save:INPUT read:READ} [current_design]
set_property PACKAGE_PIN M19 [get_ports adc_dco_i]
set_property src_info {type:XDC file:4 line:67 export:INPUT save:INPUT read:READ} [current_design]
set_property PACKAGE_PIN R18 [get_ports {adc_spi_o[0]}]
set_property src_info {type:XDC file:4 line:68 export:INPUT save:INPUT read:READ} [current_design]
set_property PACKAGE_PIN T18 [get_ports {adc_spi_o[1]}]
set_property src_info {type:XDC file:4 line:69 export:INPUT save:INPUT read:READ} [current_design]
set_property PACKAGE_PIN M21 [get_ports {adc_spi_o[2]}]
set_property src_info {type:XDC file:4 line:75 export:INPUT save:INPUT read:READ} [current_design]
set_property PACKAGE_PIN P17 [get_ports {cdce_gpio_tri_io[0]}]
set_property src_info {type:XDC file:4 line:76 export:INPUT save:INPUT read:READ} [current_design]
set_property PACKAGE_PIN T16 [get_ports {cdce_gpio_tri_io[1]}]
set_property src_info {type:XDC file:4 line:77 export:INPUT save:INPUT read:READ} [current_design]
set_property PACKAGE_PIN T19 [get_ports {cdce_gpio_tri_io[2]}]
set_property src_info {type:XDC file:4 line:78 export:INPUT save:INPUT read:READ} [current_design]
set_property PACKAGE_PIN P18 [get_ports {cdce_gpio_tri_io[3]}]
set_property src_info {type:XDC file:4 line:79 export:INPUT save:INPUT read:READ} [current_design]
set_property PACKAGE_PIN N15 [get_ports {cdce_gpio_tri_io[4]}]
set_property src_info {type:XDC file:4 line:85 export:INPUT save:INPUT read:READ} [current_design]
set_property PACKAGE_PIN T17 [get_ports {cdce_iic_tri_io[0]}]
set_property src_info {type:XDC file:4 line:86 export:INPUT save:INPUT read:READ} [current_design]
set_property PACKAGE_PIN R19 [get_ports {cdce_iic_tri_io[1]}]
set_property src_info {type:XDC file:4 line:92 export:INPUT save:INPUT read:READ} [current_design]
set_property PACKAGE_PIN Y19 [get_ports {dac_data_o[0]}]
set_property src_info {type:XDC file:4 line:93 export:INPUT save:INPUT read:READ} [current_design]
set_property PACKAGE_PIN Y18 [get_ports {dac_data_o[1]}]
set_property src_info {type:XDC file:4 line:94 export:INPUT save:INPUT read:READ} [current_design]
set_property PACKAGE_PIN AB22 [get_ports {dac_data_o[2]}]
set_property src_info {type:XDC file:4 line:95 export:INPUT save:INPUT read:READ} [current_design]
set_property PACKAGE_PIN AB20 [get_ports {dac_data_o[3]}]
set_property src_info {type:XDC file:4 line:96 export:INPUT save:INPUT read:READ} [current_design]
set_property PACKAGE_PIN AA18 [get_ports {dac_data_o[4]}]
set_property src_info {type:XDC file:4 line:97 export:INPUT save:INPUT read:READ} [current_design]
set_property PACKAGE_PIN AA19 [get_ports {dac_data_o[5]}]
set_property src_info {type:XDC file:4 line:98 export:INPUT save:INPUT read:READ} [current_design]
set_property PACKAGE_PIN Y21 [get_ports {dac_data_o[6]}]
set_property src_info {type:XDC file:4 line:99 export:INPUT save:INPUT read:READ} [current_design]
set_property PACKAGE_PIN Y20 [get_ports {dac_data_o[7]}]
set_property src_info {type:XDC file:4 line:100 export:INPUT save:INPUT read:READ} [current_design]
set_property PACKAGE_PIN V15 [get_ports {dac_data_o[8]}]
set_property src_info {type:XDC file:4 line:101 export:INPUT save:INPUT read:READ} [current_design]
set_property PACKAGE_PIN V14 [get_ports {dac_data_o[9]}]
set_property src_info {type:XDC file:4 line:102 export:INPUT save:INPUT read:READ} [current_design]
set_property PACKAGE_PIN AB15 [get_ports {dac_data_o[10]}]
set_property src_info {type:XDC file:4 line:103 export:INPUT save:INPUT read:READ} [current_design]
set_property PACKAGE_PIN AB14 [get_ports {dac_data_o[11]}]
set_property src_info {type:XDC file:4 line:104 export:INPUT save:INPUT read:READ} [current_design]
set_property PACKAGE_PIN W13 [get_ports {dac_data_o[12]}]
set_property src_info {type:XDC file:4 line:105 export:INPUT save:INPUT read:READ} [current_design]
set_property PACKAGE_PIN V13 [get_ports {dac_data_o[13]}]
set_property src_info {type:XDC file:4 line:108 export:INPUT save:INPUT read:READ} [current_design]
set_property PACKAGE_PIN W16 [get_ports dac_clk_o]
set_property src_info {type:XDC file:4 line:112 export:INPUT save:INPUT read:READ} [current_design]
set_property PACKAGE_PIN Y14 [get_ports {dac_spi_o[0]}]
set_property src_info {type:XDC file:4 line:113 export:INPUT save:INPUT read:READ} [current_design]
set_property PACKAGE_PIN AA13 [get_ports {dac_spi_o[1]}]
set_property src_info {type:XDC file:4 line:114 export:INPUT save:INPUT read:READ} [current_design]
set_property PACKAGE_PIN AA14 [get_ports {dac_spi_o[2]}]
set_property src_info {type:XDC file:4 line:118 export:INPUT save:INPUT read:READ} [current_design]
set_property PACKAGE_PIN Y13 [get_ports {dac_tri_io[0]}]
set_property src_info {type:XDC file:4 line:119 export:INPUT save:INPUT read:READ} [current_design]
set_property PACKAGE_PIN AA22 [get_ports {dac_tri_io[1]}]
set_property src_info {type:XDC file:4 line:120 export:INPUT save:INPUT read:READ} [current_design]
set_property PACKAGE_PIN W15 [get_ports {dac_tri_io[2]}]
set_property src_info {type:XDC file:4 line:121 export:INPUT save:INPUT read:READ} [current_design]
set_property PACKAGE_PIN Y15 [get_ports {dac_tri_io[3]}]
