Eskdagoat/Qorvo_F24_SD/SD1_Fall24/Computer/Eclypse/Eclypse_Transceiver/Eclypse_Transceiver/Eclypse_Transceiver.gen/sources_1/bd/system/ip/system_conv_1_0/synth/system_conv_1_0.v

// (c) Copyright 1986-2022 Xilinx, Inc. All Rights Reserved.
// (c) Copyright 2022-2024 Advanced Micro Devices, Inc. All rights reserved.
// 
// This file contains confidential and proprietary information
// of AMD and is protected under U.S. and international copyright
// and other intellectual property laws.
// 
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
// CRITICAL APPLICATIONS
// AMD products are not designed or intended to be fail-
// safe, or for use in any application requiring fail-safe
// performance, such as life-support or safety devices or
// systems, Class III medical devices, nuclear facilities,
// applications related to the deployment of airbags, or any
// other applications that could lead to death, personal
// injury, or severe property or environmental damage
// (individually and collectively, "Critical
// Applications"). Customer assumes the sole risk and
// liability of any use of AMD products in Critical
// Applications, subject only to applicable laws and
// regulations governing limitations on product liability.
// 
// THIS COPYRIGHT NOTICE AND DISCLAIMER MUST BE RETAINED AS
// PART OF THIS FILE AT ALL TIMES.
// 
// DO NOT MODIFY THIS FILE.


// IP VLNV: xilinx.com:ip:axis_dwidth_converter:1.1
// IP Revision: 32

(* X_CORE_INFO = "axis_dwidth_converter_v1_1_32_axis_dwidth_converter,Vivado 2024.2" *)
(* CHECK_LICENSE_TYPE = "system_conv_1_0,axis_dwidth_converter_v1_1_32_axis_dwidth_converter,{}" *)
(* CORE_GENERATION_INFO = "system_conv_1_0,axis_dwidth_converter_v1_1_32_axis_dwidth_converter,{x_ipProduct=Vivado 2024.2,x_ipVendor=xilinx.com,x_ipLibrary=ip,x_ipName=axis_dwidth_converter,x_ipVersion=1.1,x_ipCoreRevision=32,x_ipLanguage=VERILOG,x_ipSimLanguage=MIXED,C_FAMILY=zynq,C_S_AXIS_TDATA_WIDTH=32,C_M_AXIS_TDATA_WIDTH=64,C_AXIS_TID_WIDTH=1,C_AXIS_TDEST_WIDTH=1,C_S_AXIS_TUSER_WIDTH=1,C_M_AXIS_TUSER_WIDTH=1,C_AXIS_SIGNAL_SET=0b00000000000000000000000000000011}" *)
(* DowngradeIPIdentifiedWarnings = "yes" *)
module system_conv_1_0 (
  aclk,
  aresetn,
  s_axis_tvalid,
  s_axis_tready,
  s_axis_tdata,
  m_axis_tvalid,
  m_axis_tready,
  m_axis_tdata
);

(* X_INTERFACE_INFO = "xilinx.com:signal:clock:1.0 CLKIF CLK" *)
(* X_INTERFACE_MODE = "slave" *)
(* X_INTERFACE_PARAMETER = "XIL_INTERFACENAME CLKIF, ASSOCIATED_BUSIF S_AXIS:M_AXIS, ASSOCIATED_RESET aresetn, ASSOCIATED_CLKEN aclken, FREQ_HZ 122880000, FREQ_TOLERANCE_HZ 0, PHASE 0.0, CLK_DOMAIN /pll_0_clk_out1, INSERT_VIP 0" *)
input wire aclk;
(* X_INTERFACE_INFO = "xilinx.com:signal:reset:1.0 RSTIF RST" *)
(* X_INTERFACE_MODE = "slave" *)
(* X_INTERFACE_PARAMETER = "XIL_INTERFACENAME RSTIF, POLARITY ACTIVE_LOW, INSERT_VIP 0, TYPE INTERCONNECT" *)
input wire aresetn;
(* X_INTERFACE_INFO = "xilinx.com:interface:axis:1.0 S_AXIS TVALID" *)
(* X_INTERFACE_MODE = "slave" *)
(* X_INTERFACE_PARAMETER = "XIL_INTERFACENAME S_AXIS, TDATA_NUM_BYTES 4, TDEST_WIDTH 0, TID_WIDTH 0, TUSER_WIDTH 0, HAS_TREADY 1, HAS_TSTRB 0, HAS_TKEEP 0, HAS_TLAST 0, FREQ_HZ 122880000, PHASE 0.0, CLK_DOMAIN /pll_0_clk_out1, LAYERED_METADATA xilinx.com:interface:datatypes:1.0 {TDATA {datatype {name {attribs {resolve_type immediate dependency {} format string minimum {} maximum {}} value data} bitwidth {attribs {resolve_type generated dependency width format long minimum {} maximum {}} value 32} bitoffset {attribs {resolv\
e_type immediate dependency {} format long minimum {} maximum {}} value 0} real {float {sigwidth {attribs {resolve_type generated dependency fractwidth format long minimum {} maximum {}} value 24}}}}} TDATA_WIDTH 32 TUSER {datatype {name {attribs {resolve_type immediate dependency {} format string minimum {} maximum {}} value {}} bitwidth {attribs {resolve_type automatic dependency {} format long minimum {} maximum {}} value 0} bitoffset {attribs {resolve_type immediate dependency {} format long\
 minimum {} maximum {}} value 0} struct {field_underflow {name {attribs {resolve_type immediate dependency {} format string minimum {} maximum {}} value underflow} enabled {attribs {resolve_type generated dependency underflow_enabled format bool minimum {} maximum {}} value false} datatype {name {attribs {resolve_type immediate dependency {} format string minimum {} maximum {}} value {}} bitwidth {attribs {resolve_type generated dependency underflow_bitwidth format long minimum {} maximum {}} va\
lue 0} bitoffset {attribs {resolve_type immediate dependency {} format long minimum {} maximum {}} value 0}}} field_overflow {name {attribs {resolve_type immediate dependency {} format string minimum {} maximum {}} value overflow} enabled {attribs {resolve_type generated dependency overflow_enabled format bool minimum {} maximum {}} value false} datatype {name {attribs {resolve_type immediate dependency {} format string minimum {} maximum {}} value {}} bitwidth {attribs {resolve_type generated d\
ependency overflow_bitwidth format long minimum {} maximum {}} value 0} bitoffset {attribs {resolve_type generated dependency overflow_bitoffset format long minimum {} maximum {}} value 0}}} field_invalid_op {name {attribs {resolve_type immediate dependency {} format string minimum {} maximum {}} value invalid_op} enabled {attribs {resolve_type generated dependency invalid_op_enabled format bool minimum {} maximum {}} value false} datatype {name {attribs {resolve_type immediate dependency {} for\
mat string minimum {} maximum {}} value {}} bitwidth {attribs {resolve_type generated dependency invalid_op_bitwidth format long minimum {} maximum {}} value 0} bitoffset {attribs {resolve_type generated dependency invalid_op_bitoffset format long minimum {} maximum {}} value 0}}} field_div_by_zero {name {attribs {resolve_type immediate dependency {} format string minimum {} maximum {}} value div_by_zero} enabled {attribs {resolve_type generated dependency div_by_zero_enabled format bool minimum\
 {} maximum {}} value false} datatype {name {attribs {resolve_type immediate dependency {} format string minimum {} maximum {}} value {}} bitwidth {attribs {resolve_type generated dependency div_by_zero_bitwidth format long minimum {} maximum {}} value 0} bitoffset {attribs {resolve_type generated dependency div_by_zero_bitoffset format long minimum {} maximum {}} value 0}}} field_accum_input_overflow {name {attribs {resolve_type immediate dependency {} format string minimum {} maximum {}} value\
 accum_input_overflow} enabled {attribs {resolve_type generated dependency accum_input_overflow_enabled format bool minimum {} maximum {}} value false} datatype {name {attribs {resolve_type immediate dependency {} format string minimum {} maximum {}} value {}} bitwidth {attribs {resolve_type generated dependency accum_input_overflow_bitwidth format long minimum {} maximum {}} value 0} bitoffset {attribs {resolve_type generated dependency accum_input_overflow_bitoffset format long minimum {} maxi\
mum {}} value 0}}} field_accum_overflow {name {attribs {resolve_type immediate dependency {} format string minimum {} maximum {}} value accum_overflow} enabled {attribs {resolve_type generated dependency accum_overflow_enabled format bool minimum {} maximum {}} value false} datatype {name {attribs {resolve_type immediate dependency {} format string minimum {} maximum {}} value {}} bitwidth {attribs {resolve_type generated dependency accum_overflow_bitwidth format long minimum {} maximum {}} valu\
e 0} bitoffset {attribs {resolve_type generated dependency accum_overflow_bitoffset format long minimum {} maximum {}} value 0}}} field_a_tuser {name {attribs {resolve_type immediate dependency {} format string minimum {} maximum {}} value a_tuser} enabled {attribs {resolve_type generated dependency a_tuser_enabled format bool minimum {} maximum {}} value false} datatype {name {attribs {resolve_type immediate dependency {} format string minimum {} maximum {}} value {}} bitwidth {attribs {resolve\
_type generated dependency a_tuser_bitwidth format long minimum {} maximum {}} value 0} bitoffset {attribs {resolve_type generated dependency a_tuser_bitoffset format long minimum {} maximum {}} value 0}}} field_b_tuser {name {attribs {resolve_type immediate dependency {} format string minimum {} maximum {}} value b_tuser} enabled {attribs {resolve_type generated dependency b_tuser_enabled format bool minimum {} maximum {}} value false} datatype {name {attribs {resolve_type immediate dependency \
{} format string minimum {} maximum {}} value {}} bitwidth {attribs {resolve_type generated dependency b_tuser_bitwidth format long minimum {} maximum {}} value 0} bitoffset {attribs {resolve_type generated dependency b_tuser_bitoffset format long minimum {} maximum {}} value 0}}} field_c_tuser {name {attribs {resolve_type immediate dependency {} format string minimum {} maximum {}} value c_tuser} enabled {attribs {resolve_type generated dependency c_tuser_enabled format bool minimum {} maximum \
{}} value false} datatype {name {attribs {resolve_type immediate dependency {} format string minimum {} maximum {}} value {}} bitwidth {attribs {resolve_type generated dependency c_tuser_bitwidth format long minimum {} maximum {}} value 0} bitoffset {attribs {resolve_type generated dependency c_tuser_bitoffset format long minimum {} maximum {}} value 0}}} field_operation_tuser {name {attribs {resolve_type immediate dependency {} format string minimum {} maximum {}} value operation_tuser} enabled\
 {attribs {resolve_type generated dependency operation_tuser_enabled format bool minimum {} maximum {}} value false} datatype {name {attribs {resolve_type immediate dependency {} format string minimum {} maximum {}} value {}} bitwidth {attribs {resolve_type generated dependency operation_tuser_bitwidth format long minimum {} maximum {}} value 0} bitoffset {attribs {resolve_type generated dependency operation_tuser_bitoffset format long minimum {} maximum {}} value 0}}}}}} TUSER_WIDTH 0}, INSERT_\
VIP 0" *)
input wire s_axis_tvalid;
(* X_INTERFACE_INFO = "xilinx.com:interface:axis:1.0 S_AXIS TREADY" *)
output wire s_axis_tready;
(* X_INTERFACE_INFO = "xilinx.com:interface:axis:1.0 S_AXIS TDATA" *)
input wire [31 : 0] s_axis_tdata;
(* X_INTERFACE_INFO = "xilinx.com:interface:axis:1.0 M_AXIS TVALID" *)
(* X_INTERFACE_MODE = "master" *)
(* X_INTERFACE_PARAMETER = "XIL_INTERFACENAME M_AXIS, TDATA_NUM_BYTES 8, TDEST_WIDTH 0, TID_WIDTH 0, TUSER_WIDTH 0, HAS_TREADY 1, HAS_TSTRB 0, HAS_TKEEP 0, HAS_TLAST 0, FREQ_HZ 122880000, PHASE 0.0, CLK_DOMAIN /pll_0_clk_out1, LAYERED_METADATA undef, INSERT_VIP 0" *)
output wire m_axis_tvalid;
(* X_INTERFACE_INFO = "xilinx.com:interface:axis:1.0 M_AXIS TREADY" *)
input wire m_axis_tready;
(* X_INTERFACE_INFO = "xilinx.com:interface:axis:1.0 M_AXIS TDATA" *)
output wire [63 : 0] m_axis_tdata;

  axis_dwidth_converter_v1_1_32_axis_dwidth_converter #(
    .C_FAMILY("zynq"),
    .C_S_AXIS_TDATA_WIDTH(32),
    .C_M_AXIS_TDATA_WIDTH(64),
    .C_AXIS_TID_WIDTH(1),
    .C_AXIS_TDEST_WIDTH(1),
    .C_S_AXIS_TUSER_WIDTH(1),
    .C_M_AXIS_TUSER_WIDTH(1),
    .C_AXIS_SIGNAL_SET(32'B00000000000000000000000000000011)
  ) inst (
    .aclk(aclk),
    .aresetn(aresetn),
    .aclken(1'H1),
    .s_axis_tvalid(s_axis_tvalid),
    .s_axis_tready(s_axis_tready),
    .s_axis_tdata(s_axis_tdata),
    .s_axis_tstrb(4'HF),
    .s_axis_tkeep(4'HF),
    .s_axis_tlast(1'H1),
    .s_axis_tid(1'H0),
    .s_axis_tdest(1'H0),
    .s_axis_tuser(1'H0),
    .m_axis_tvalid(m_axis_tvalid),
    .m_axis_tready(m_axis_tready),
    .m_axis_tdata(m_axis_tdata),
    .m_axis_tstrb(),
    .m_axis_tkeep(),
    .m_axis_tlast(),
    .m_axis_tid(),
    .m_axis_tdest(),
    .m_axis_tuser()
  );
endmodule
