Eskdagoat/Qorvo_F24_SD/SD1_Fall24/Computer/Eclypse/Eclypse_Transceiver/Eclypse_Transceiver/Eclypse_Transceiver.gen/sources_1/bd/system/ip/system_fir_0_0/cmodel/system_fir_0_0.h

//------------------------------------------------------------------------------
// (c) Copyright 2023 Advanced Micro Devices. All rights reserved.
//
// This file contains confidential and proprietary information
// of AMD, Inc. and is protected under U.S. and
// international copyright and other intellectual property
// laws.
//
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
// CRITICAL APPLICATIONS
// AMD products are not designed or intended to be fail-
// safe, or for use in any application requiring fail-safe
// performance, such as life-support or safety devices or
// systems, Class III medical devices, nuclear facilities,
// applications related to the deployment of airbags, or any
// other applications that could lead to death, personal
// injury, or severe property or environmental damage
// (individually and collectively, "Critical
// Applications"). Customer assumes the sole risk and
// liability of any use of AMD products in Critical
// Applications, subject only to applicable laws and
// regulations governing limitations on product liability.
//
// THIS COPYRIGHT NOTICE AND DISCLAIMER MUST BE RETAINED AS
// PART OF THIS FILE AT ALL TIMES.
//------------------------------------------------------------------------------ 
//
// C Model configuration for the "system_fir_0_0" instance.
//
//------------------------------------------------------------------------------
//
// coefficients: -1.6474608535e-08,-4.7302195930e-08,-7.8619468076e-10,3.0921189871e-08,1.8608837232e-08,3.2734022251e-08,-6.2813438189e-09,-1.5221363991e-07,-8.3032953559e-08,3.1439829734e-07,3.0552900504e-07,-4.7396324870e-07,-7.1323740619e-07,5.4707476786e-07,1.3341171590e-06,-4.1393271599e-07,-2.1496782582e-06,-6.7769353338e-08,3.0742601185e-06,1.0366765715e-06,-3.9428070248e-06,-2.5909585490e-06,4.5135845246e-06,4.7460225319e-06,-4.4910558070e-06,-7.3953978786e-06,3.5707408445e-06,1.0285546038e-05,-1.5032224453e-06,-1.3015815434e-05,-1.8313444384e-06,1.5072320650e-05,6.3521132941e-06,-1.5899576427e-05,-1.1727813184e-05,1.5005323291e-05,1.7365093303e-05,-1.2089910213e-05,-2.2458022005e-05,7.1673633916e-06,2.6093058018e-05,-6.6389116544e-07,-2.7418691729e-05,-6.5473442360e-06,2.5854600003e-05,1.3198330110e-05,-2.1309361735e-05,-1.7782206252e-05,1.4361810624e-05,1.8811515648e-05,-6.3566406461e-06,-1.5155979368e-05,-6.3247080943e-07,6.4130448230e-06,4.0040582068e-06,6.7546397959e-06,-1.0026074055e-06,-2.2393312940e-05,-1.0760842920e-05,3.7217184434e-05,3.2690283793e-05,-4.6839875203e-05,-6.4629245773e-05,4.6239001154e-05,1.0436232686e-04,-3.0525157948e-05,-1.4740012610e-04,-4.1219698477e-06,1.8711256488e-04,5.9452347683e-05,-2.1528991520e-04,-1.3425249804e-04,2.2313567651e-04,2.2375017156e-04,-2.0262013024e-04,-3.1950057315e-04,1.4803738125e-04,4.0989148374e-04,-5.7537086900e-05,-4.8132818219e-04,-6.5649818729e-05,5.2004965910e-04,2.1257912313e-04,-5.1442095551e-04,-3.688588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

const xip_fir_v7_2_pattern system_fir_0_0_chanpats[1] = {P_BASIC};

static xip_fir_v7_2_config gen_system_fir_0_0_config() {
  xip_fir_v7_2_config config;
  config.name                = "system_fir_0_0";
  config.filter_type         = 2;
  config.rate_change         = XIP_FIR_INTEGER_RATE;
  config.interp_rate         = 1;
  config.decim_rate          = 2;
  config.zero_pack_factor    = 1;
  config.coeff               = &system_fir_0_0_coefficients[0];
  config.coeff_padding       = 5;
  config.num_coeffs          = 309;
  config.coeff_sets          = 1;
  config.reloadable          = 0;
  config.is_halfband         = 0;
  config.quantization        = XIP_FIR_QUANTIZED_ONLY;
  config.coeff_width         = 24;
  config.coeff_fract_width   = 23;
  config.chan_seq            = XIP_FIR_BASIC_CHAN_SEQ;
  config.num_channels        = 2;
  config.init_pattern        = system_fir_0_0_chanpats[0];
  config.num_paths           = 1;
  config.data_width          = 32;
  config.data_fract_width    = 0;
  config.output_rounding_mode= XIP_FIR_CONVERGENT_EVEN;
  config.output_width        = 25;
  config.output_fract_width  = 0,
  config.config_method       = XIP_FIR_CONFIG_SINGLE;
  return config;
}

const xip_fir_v7_2_config system_fir_0_0_config = gen_system_fir_0_0_config();
