Eskdagoat/Qorvo_F24_SD/SD1_Fall24/Computer/Eclypse/Eclypse_Transceiver/Eclypse_Transceiver/Eclypse_Transceiver.gen/sources_1/bd/system/ip/system_fir_0_0/cmodel/tb_system_fir_0_0.c

//-----------------------------------------------------------------------------
//  (c) Copyright 2014 2023 Advanced Micro Devices, Inc. All rights reserved.
//
//  This file contains confidential and proprietary information
//  of AMD, Inc. and is protected under U.S. and
//  international copyright and other intellectual property
//  laws.
//
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
//  CRITICAL APPLICATIONS
//  AMD products are not designed or intended to be fail-
//  safe, or for use in any application requiring fail-safe
//  performance, such as life-support or safety devices or
//  systems, Class III medical devices, nuclear facilities,
//  applications related to the deployment of airbags, or any
//  other applications that could lead to death, personal
//  injury, or severe property or environmental damage
//  (individually and collectively, "Critical
//  Applications"). Customer assumes the sole risk and
//  liability of any use of AMD products in Critical
//  Applications, subject only to applicable laws and
//  regulations governing limitations on product liability.
//
//  THIS COPYRIGHT NOTICE AND DISCLAIMER MUST BE RETAINED AS
//  PART OF THIS FILE AT ALL TIMES.
//-----------------------------------------------------------------------------
// C testbench for the "system_fir_0_0" instance
//   o Basic C testbench based on the run_bitacc_cmodel.c smoke test program
//     included in the C model zip files. Please refer run_bitacc_cmodel.c
//     for further examples of how to use the FIR Compiler C model.
//   o Unzip the appropriate platform specifc zip file and use the following example 
//     command line to compile and link this TB:
//     gcc -x c++ -I. -L. -lIp_fir_compiler_v7_2_23_bitacc_cmodel -Wl,-rpath,. -o tb_system_fir_0_0 tb_system_fir_0_0.c

#include <stdio.h>
#include "fir_compiler_v7_2_bitacc_cmodel.h"
#include "system_fir_0_0.h"

//---------------------------------------------------------------------------------------------------------------------
// Example message handler
static void msg_print(void* handle, int error, const char* msg)
{
	printf("%s\n",msg);
}

//---------------------------------------------------------------------------------------------------------------------
//Print a xip_array_real
void print_array_real(const xip_array_real* x)
{
  putchar('[');
  if (x && x->data && x->data_size)
  {
    const xip_real* p=x->data;
    const xip_real* q=x->data;
    const xip_real* r=x->data+x->data_size;
    while (q!=r)
    {
      if (q!=p) putchar(' ');
      printf("%g",*q);
      q++;
    }
  }
  putchar(']');
  putchar('\n');
}

//----------------------------------------------------------------------------------------------------------------------
// Fill data array with a scaled impulse. Assumes 3-D array.
int create_impulse(xip_array_real* x) {
  int path;
  int chan;
  int i;
  for (path = 0; path < x->dim[0];path++) {
    for (chan = 0; chan < x->dim[1];chan++) {
       xip_fir_v7_2_xip_array_real_set_chan(x,(double)((path+1)*(chan+1)),path,chan,0,P_BASIC);
       for (i = 1; i < x->dim[2];i++) {
         xip_fir_v7_2_xip_array_real_set_chan(x,0,path,chan,i,P_BASIC);
       }
    }
  }
  return 0;
}
//----------------------------------------------------------------------------------------------------------------------
// String arrays used by the print_config funtion
const char *filt_desc[5] = { "SINGLE RATE", "INTERPOLATION", "DECIMATION", "HILBERT", "INTERPOLATED" };
const char *seq_desc[2] = { "Basic" , "Advanced" };

//----------------------------------------------------------------------------------------------------------------------
// Print a summary of a filter configuration
int print_config(const xip_fir_v7_2_config* cfg) {
  printf("Configuration of %s:\n",cfg->name);
  printf("\tFilter       : ");
  if ( cfg->filter_type == XIP_FIR_SINGLE_RATE || cfg->filter_type == XIP_FIR_HILBERT ) {
    printf("%s\n",filt_desc[cfg->filter_type]);
  } else if ( cfg->filter_type == XIP_FIR_INTERPOLATED ) {
    printf("%s by %d\n",filt_desc[cfg->filter_type],cfg->zero_pack_factor);
  } else {
    printf("%s up by %d down by %d\n",filt_desc[cfg->filter_type],cfg->interp_rate,cfg->decim_rate);
  }
  printf("\tCoefficients : %d ",cfg->coeff_sets);
  if ( cfg->is_halfband ) {
    printf("Halfband ");
  }
  if (cfg->reloadable) {
    printf("Reloadable ");
  }
  printf("coefficient set(s) of %d taps\n",cfg->num_coeffs);
  printf("\tData         : %d path(s) of %d %s channel(s)\n",cfg->num_paths,cfg->num_channels,seq_desc[cfg->chan_seq]);
  
  return 0;
}
  
//----------------------------------------------------------------------------------------------------------------------
int main () {
  const char* ver_str = xip_fir_v7_2_get_version();
  printf("FIR Compiler C Model version: %s\n",ver_str);
  
  print_config(&system_fir_0_0_config);
  
  //Create filter instances
  xip_fir_v7_2* system_fir_0_0_inst = xip_fir_v7_2_create(&system_fir_0_0_config,&msg_print,0);
  if (!system_fir_0_0_inst) {
    printf("Error creating instance\n",system_fir_0_0_config.name);
    return -1;
  } else { 
    printf("Created instance\n",system_fir_0_0_config.name);
  }
  
  // Create input data packet
  xip_array_real* din = xip_array_real_create();
  xip_array_real_reserve_dim(din,3);
  din->dim_size = 3; // 3D array
  din->dim[0] = system_fir_0_0_config.num_paths;
  din->dim[1] = system_fir_0_0_config.num_channels; 
  din->dim[2] = system_fir_0_0_config.num_coeffs; // vectors in a single packet
  din->data_size = din->dim[0] * din->dim[1] * din->dim[2];
  if (xip_array_real_reserve_data(din,din->data_size) == XIP_STATUS_OK) {
    printf("Reserved data\n");
  } else {
    printf("Unable to reserve data!\n");
    return -1;
  }
  
  // Create output data packet
  //  - Automatically sized using xip_fir_v7_2_calc_size
  xip_array_real* dout = xip_array_real_create();
  xip_array_real_reserve_dim(dout,3);
  dout->dim_size = 3; // 3D array
  if(xip_fir_v7_2_calc_size(system_fir_0_0_inst,din,dout,0)== XIP_STATUS_OK) {
    printf("Calculated output data size\n");
    if (xip_array_real_reserve_data(dout,dout->data_size) == XIP_STATUS_OK) {
      printf("Reserved data\n");
    } else {
      printf("Unable to reserve data!\n");
      return -1;
    }
  } else {
    printf("Unable to calculate output date size\n");
    return -1;
  }
  
  // Populate data in with an impulse
  printf("Create impulse\n");
  create_impulse(din);
  
  // Send input data and filter
  if ( xip_fir_v7_2_data_send(system_fir_0_0_inst,din)== XIP_STATUS_OK) {
    printf("Sent data     : ");
    print_array_real(din);
  } else {
    printf("Error sending data\n");
    return -1;
  }
  
  // Retrieve filtered data
  if ( xip_fir_v7_2_data_get(system_fir_0_0_inst,dout,0)== XIP_STATUS_OK) {
    printf("Fetched result: ");
    print_array_real(dout);
  } else {
    printf("Error getting data\n");
    return -1;
  }
}
