Eskdagoat/Qorvo_F24_SD/SD1_Fall24/Computer/Eclypse/Eclypse_Transceiver/Eclypse_Transceiver/Eclypse_Transceiver.gen/sources_1/bd/system/ip/system_concat_0_0/sim/system_concat_0_0_sc.cpp

// (c) Copyright 1986-2022 Xilinx, Inc. All Rights Reserved.
// (c) Copyright 2022-2024 Advanced Micro Devices, Inc. All rights reserved.
// 
// This file contains confidential and proprietary information
// of AMD and is protected under U.S. and international copyright
// and other intellectual property laws.
// 
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
// CRITICAL APPLICATIONS
// AMD products are not designed or intended to be fail-
// safe, or for use in any application requiring fail-safe
// performance, such as life-support or safety devices or
// systems, Class III medical devices, nuclear facilities,
// applications related to the deployment of airbags, or any
// other applications that could lead to death, personal
// injury, or severe property or environmental damage
// (individually and collectively, "Critical
// Applications"). Customer assumes the sole risk and
// liability of any use of AMD products in Critical
// Applications, subject only to applicable laws and
// regulations governing limitations on product liability.
// 
// THIS COPYRIGHT NOTICE AND DISCLAIMER MUST BE RETAINED AS
// PART OF THIS FILE AT ALL TIMES.
// 
// DO NOT MODIFY THIS FILE.


#include "system_concat_0_0_sc.h"

#include "system_concat_0_0_core.h"

#include <map>
#include <string>

system_concat_0_0_sc::system_concat_0_0_sc(const sc_core::sc_module_name& nm) : sc_core::sc_module(nm), mp_impl(NULL)
{
  // configure connectivity manager
  xsc::utils::xsc_sim_manager::addInstance("system_concat_0_0", this);

  // initialize module
    xsc::common_cpp::properties model_param_props;
    model_param_props.addLong("IN0_WIDTH", "16");
    model_param_props.addLong("IN1_WIDTH", "16");
    model_param_props.addLong("IN2_WIDTH", "1");
    model_param_props.addLong("IN3_WIDTH", "1");
    model_param_props.addLong("IN4_WIDTH", "1");
    model_param_props.addLong("IN5_WIDTH", "1");
    model_param_props.addLong("IN6_WIDTH", "1");
    model_param_props.addLong("IN7_WIDTH", "1");
    model_param_props.addLong("IN8_WIDTH", "1");
    model_param_props.addLong("IN9_WIDTH", "1");
    model_param_props.addLong("IN10_WIDTH", "1");
    model_param_props.addLong("IN11_WIDTH", "1");
    model_param_props.addLong("IN12_WIDTH", "1");
    model_param_props.addLong("IN13_WIDTH", "1");
    model_param_props.addLong("IN14_WIDTH", "1");
    model_param_props.addLong("IN15_WIDTH", "1");
    model_param_props.addLong("IN16_WIDTH", "1");
    model_param_props.addLong("IN17_WIDTH", "1");
    model_param_props.addLong("IN18_WIDTH", "1");
    model_param_props.addLong("IN19_WIDTH", "1");
    model_param_props.addLong("IN20_WIDTH", "1");
    model_param_props.addLong("IN21_WIDTH", "1");
    model_param_props.addLong("IN22_WIDTH", "1");
    model_param_props.addLong("IN23_WIDTH", "1");
    model_param_props.addLong("IN24_WIDTH", "1");
    model_param_props.addLong("IN25_WIDTH", "1");
    model_param_props.addLong("IN26_WIDTH", "1");
    model_param_props.addLong("IN27_WIDTH", "1");
    model_param_props.addLong("IN28_WIDTH", "1");
    model_param_props.addLong("IN29_WIDTH", "1");
    model_param_props.addLong("IN30_WIDTH", "1");
    model_param_props.addLong("IN31_WIDTH", "1");
    model_param_props.addLong("IN32_WIDTH", "1");
    model_param_props.addLong("IN33_WIDTH", "1");
    model_param_props.addLong("IN34_WIDTH", "1");
    model_param_props.addLong("IN35_WIDTH", "1");
    model_param_props.addLong("IN36_WIDTH", "1");
    model_param_props.addLong("IN37_WIDTH", "1");
    model_param_props.addLong("IN38_WIDTH", "1");
    model_param_props.addLong("IN39_WIDTH", "1");
    model_param_props.addLong("IN40_WIDTH", "1");
    model_param_props.addLong("IN41_WIDTH", "1");
    model_param_props.addLong("IN42_WIDTH", "1");
    model_param_props.addLong("IN43_WIDTH", "1");
    model_param_props.addLong("IN44_WIDTH", "1");
    model_param_props.addLong("IN45_WIDTH", "1");
    model_param_props.addLong("IN46_WIDTH", "1");
    model_param_props.addLong("IN47_WIDTH", "1");
    model_param_props.addLong("IN48_WIDTH", "1");
    model_param_props.addLong("IN49_WIDTH", "1");
    model_param_props.addLong("IN50_WIDTH", "1");
    model_param_props.addLong("IN51_WIDTH", "1");
    model_param_props.addLong("IN52_WIDTH", "1");
    model_param_props.addLong("IN53_WIDTH", "1");
    model_param_props.addLong("IN54_WIDTH", "1");
    model_param_props.addLong("IN55_WIDTH", "1");
    model_param_props.addLong("IN56_WIDTH", "1");
    model_param_props.addLong("IN57_WIDTH", "1");
    model_param_props.addLong("IN58_WIDTH", "1");
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
    model_param_props.addString("COMPONENT_NAME", "system_concat_0_0");

  mp_impl = new system_concat_0_0_core("inst", model_param_props);
}

system_concat_0_0_sc::~system_concat_0_0_sc()
{
  xsc::utils::xsc_sim_manager::clean();

  delete mp_impl;
}
