Eskdagoat/Qorvo_F24_SD/SD1_Fall24/Computer/Eclypse/Eclypse_Transceiver/Eclypse_Transceiver/Eclypse_Transceiver.gen/sources_1/bd/system/ip/system_ps_0_0/sim/system_ps_0_0.cpp

// (c) Copyright 1986-2022 Xilinx, Inc. All Rights Reserved.
// (c) Copyright 2022-2024 Advanced Micro Devices, Inc. All rights reserved.
// 
// This file contains confidential and proprietary information
// of AMD and is protected under U.S. and international copyright
// and other intellectual property laws.
// 
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
// CRITICAL APPLICATIONS
// AMD products are not designed or intended to be fail-
// safe, or for use in any application requiring fail-safe
// performance, such as life-support or safety devices or
// systems, Class III medical devices, nuclear facilities,
// applications related to the deployment of airbags, or any
// other applications that could lead to death, personal
// injury, or severe property or environmental damage
// (individually and collectively, "Critical
// Applications"). Customer assumes the sole risk and
// liability of any use of AMD products in Critical
// Applications, subject only to applicable laws and
// regulations governing limitations on product liability.
// 
// THIS COPYRIGHT NOTICE AND DISCLAIMER MUST BE RETAINED AS
// PART OF THIS FILE AT ALL TIMES.
// 
// DO NOT MODIFY THIS FILE.


#include "system_ps_0_0_sc.h"

#include "system_ps_0_0.h"

#include "processing_system7_v5_5_tlm.h"

#include <map>
#include <string>





#ifdef XILINX_SIMULATOR
system_ps_0_0::system_ps_0_0(const sc_core::sc_module_name& nm) : system_ps_0_0_sc(nm), GPIO_I("GPIO_I"), GPIO_O("GPIO_O"), GPIO_T("GPIO_T"), I2C0_SDA_I("I2C0_SDA_I"), I2C0_SDA_O("I2C0_SDA_O"), I2C0_SDA_T("I2C0_SDA_T"), I2C0_SCL_I("I2C0_SCL_I"), I2C0_SCL_O("I2C0_SCL_O"), I2C0_SCL_T("I2C0_SCL_T"), USB0_PORT_INDCTL("USB0_PORT_INDCTL"), USB0_VBUS_PWRSELECT("USB0_VBUS_PWRSELECT"), USB0_VBUS_PWRFAULT("USB0_VBUS_PWRFAULT"), M_AXI_GP0_ARVALID("M_AXI_GP0_ARVALID"), M_AXI_GP0_AWVALID("M_AXI_GP0_AWVALID"), M_AXI_GP0_BREADY("M_AXI_GP0_BREADY"), M_AXI_GP0_RREADY("M_AXI_GP0_RREADY"), M_AXI_GP0_WLAST("M_AXI_GP0_WLAST"), M_AXI_GP0_WVALID("M_AXI_GP0_WVALID"), M_AXI_GP0_ARID("M_AXI_GP0_ARID"), M_AXI_GP0_AWID("M_AXI_GP0_AWID"), M_AXI_GP0_WID("M_AXI_GP0_WID"), M_AXI_GP0_ARBURST("M_AXI_GP0_ARBURST"), M_AXI_GP0_ARLOCK("M_AXI_GP0_ARLOCK"), M_AXI_GP0_ARSIZE("M_AXI_GP0_ARSIZE"), M_AXI_GP0_AWBURST("M_AXI_GP0_AWBURST"), M_AXI_GP0_AWLOCK("M_AXI_GP0_AWLOCK"), M_AXI_GP0_AWSIZE("M_AXI_GP0_AWSIZE"), M_AXI_GP0_ARPROT("M_AXI_GP0_ARPROT"), M_AXI_GP0_AWPROT("M_AXI_GP0_AWPROT"), M_AXI_GP0_ARADDR("M_AXI_GP0_ARADDR"), M_AXI_GP0_AWADDR("M_AXI_GP0_AWADDR"), M_AXI_GP0_WDATA("M_AXI_GP0_WDATA"), M_AXI_GP0_ARCACHE("M_AXI_GP0_ARCACHE"), M_AXI_GP0_ARLEN("M_AXI_GP0_ARLEN"), M_AXI_GP0_ARQOS("M_AXI_GP0_ARQOS"), M_AXI_GP0_AWCACHE("M_AXI_GP0_AWCACHE"), M_AXI_GP0_AWLEN("M_AXI_GP0_AWLEN"), M_AXI_GP0_AWQOS("M_AXI_GP0_AWQOS"), M_AXI_GP0_WSTRB("M_AXI_GP0_WSTRB"), M_AXI_GP0_ACLK("M_AXI_GP0_ACLK"), M_AXI_GP0_ARREADY("M_AXI_GP0_ARREADY"), M_AXI_GP0_AWREADY("M_AXI_GP0_AWREADY"), M_AXI_GP0_BVALID("M_AXI_GP0_BVALID"), M_AXI_GP0_RLAST("M_AXI_GP0_RLAST"), M_AXI_GP0_RVALID("M_AXI_GP0_RVALID"), M_AXI_GP0_WREADY("M_AXI_GP0_WREADY"), M_AXI_GP0_BID("M_AXI_GP0_BID"), M_AXI_GP0_RID("M_AXI_GP0_RID"), M_AXI_GP0_BRESP("M_AXI_GP0_BRESP"), M_AXI_GP0_RRESP("M_AXI_GP0_RRESP"), M_AXI_GP0_RDATA("M_AXI_GP0_RDATA"), M_AXI_GP1_ARVALID("M_AXI_GP1_ARVALID"), M_AXI_GP1_AWVALID("M_AXI_GP1_AWVALID"), M_AXI_GP1_BREADY("M_AXI_GP1_BREADY"), M_AXI_GP1_RREADY("M_AXI_GP1_RREADY"), M_AXI_GP1_WLAST("M_AXI_GP1_WLAST"), M_AXI_GP1_WVALID("M_AXI_GP1_WVALID"), M_AXI_GP1_ARID("M_AXI_GP1_ARID"), M_AXI_GP1_AWID("M_AXI_GP1_AWID"), M_AXI_GP1_WID("M_AXI_GP1_WID"), M_AXI_GP1_ARBURST("M_AXI_GP1_ARBURST"), M_AXI_GP1_ARLOCK("M_AXI_GP1_ARLOCK"), M_AXI_GP1_ARSIZE("M_AXI_GP1_ARSIZE"), M_AXI_GP1_AWBURST("M_AXI_GP1_AWBURST"), M_AXI_GP1_AWLOCK("M_AXI_GP1_AWLOCK"), M_AXI_GP1_AWSIZE("M_AXI_GP1_AWSIZE"), M_AXI_GP1_ARPROT("M_AXI_GP1_ARPROT"), M_AXI_GP1_AWPROT("M_AXI_GP1_AWPROT"), M_AXI_GP1_ARADDR("M_AXI_GP1_ARADDR"), M_AXI_GP1_AWADDR("M_AXI_GP1_AWADDR"), M_AXI_GP1_WDATA("M_AXI_GP1_WDATA"), M_AXI_GP1_ARCACHE("M_AXI_GP1_ARCACHE"), M_AXI_GP1_ARLEN("M_AXI_GP1_ARLEN"), M_AXI_GP1_ARQOS("M_AXI_GP1_ARQOS"), M_AXI_GP1_AWCACHE("M_AXI_GP1_AWCACHE"), M_AXI_GP1_AWLEN("M_AXI_GP1_AWLEN"), M_AXI_GP1_AWQOS("M_AXI_GP1_AWQOS"), M_AXI_GP1_WSTRB("M_AXI_GP1_WSTRB"), M_AXI_GP1_ACLK("M_AXI_GP1_ACLK"), M_AXI_GP1_ARREADY("M_AXI_GP1_ARREADY"), M_AXI_GP1_AWREADY("M_AXI_GP1_AWREADY"), M_AXI_GP1_BVALID("M_AXI_GP1_BVALID"), M_AXI_GP1_RLAST("M_AXI_GP1_RLAST"), M_AXI_GP1_RVALID("M_AXI_GP1_RVALID"), M_AXI_GP1_WREADY("M_AXI_GP1_WREADY"), M_AXI_GP1_BID("M_AXI_GP1_BID"), M_AXI_GP1_RID("M_AXI_GP1_RID"), M_AXI_GP1_BRESP("M_AXI_GP1_BRESP"), M_AXI_GP1_RRESP("M_AXI_GP1_RRESP"), M_AXI_GP1_RDATA("M_AXI_GP1_RDATA"), FCLK_CLK0("FCLK_CLK0"), FCLK_RESET0_N("FCLK_RESET0_N"), MIO("MIO"), DDR_CAS_n("DDR_CAS_n"), DDR_CKE("DDR_CKE"), DDR_Clk_n("DDR_Clk_n"), DDR_Clk("DDR_Clk"), DDR_CS_n("DDR_CS_n"), DDR_DRSTB("DDR_DRSTB"), DDR_ODT("DDR_ODT"), DDR_RAS_n("DDR_RAS_n"), DDR_WEB("DDR_WEB"), DDR_BankAddr("DDR_BankAddr"), DDR_Addr("DDR_Addr"), DDR_VRN("DDR_VRN"), DDR_VRP("DDR_VRP"), DDR_DM("DDR_DM"), DDR_DQ("DDR_DQ"), DDR_DQS_n("DDR_DQS_n"), DDR_DQS("DDR_DQS"), PS_SRSTB("PS_SRSTB"), PS_CLK("PS_CLK"), PS_PORB("PS_PORB")
{

  // initialize pins
  mp_impl->GPIO_I(GPIO_I);
  mp_impl->GPIO_O(GPIO_O);
  mp_impl->GPIO_T(GPIO_T);
  mp_impl->I2C0_SDA_I(I2C0_SDA_I);
  mp_impl->I2C0_SDA_O(I2C0_SDA_O);
  mp_impl->I2C0_SDA_T(I2C0_SDA_T);
  mp_impl->I2C0_SCL_I(I2C0_SCL_I);
  mp_impl->I2C0_SCL_O(I2C0_SCL_O);
  mp_impl->I2C0_SCL_T(I2C0_SCL_T);
  mp_impl->USB0_PORT_INDCTL(USB0_PORT_INDCTL);
  mp_impl->USB0_VBUS_PWRSELECT(USB0_VBUS_PWRSELECT);
  mp_impl->USB0_VBUS_PWRFAULT(USB0_VBUS_PWRFAULT);
  mp_impl->M_AXI_GP0_ACLK(M_AXI_GP0_ACLK);
  mp_impl->M_AXI_GP1_ACLK(M_AXI_GP1_ACLK);
  mp_impl->FCLK_CLK0(FCLK_CLK0);
  mp_impl->FCLK_RESET0_N(FCLK_RESET0_N);
  mp_impl->MIO(MIO);
  mp_impl->DDR_CAS_n(DDR_CAS_n);
  mp_impl->DDR_CKE(DDR_CKE);
  mp_impl->DDR_Clk_n(DDR_Clk_n);
  mp_impl->DDR_Clk(DDR_Clk);
  mp_impl->DDR_CS_n(DDR_CS_n);
  mp_impl->DDR_DRSTB(DDR_DRSTB);
  mp_impl->DDR_ODT(DDR_ODT);
  mp_impl->DDR_RAS_n(DDR_RAS_n);
  mp_impl->DDR_WEB(DDR_WEB);
  mp_impl->DDR_BankAddr(DDR_BankAddr);
  mp_impl->DDR_Addr(DDR_Addr);
  mp_impl->DDR_VRN(DDR_VRN);
  mp_impl->DDR_VRP(DDR_VRP);
  mp_impl->DDR_DM(DDR_DM);
  mp_impl->DDR_DQ(DDR_DQ);
  mp_impl->DDR_DQS_n(DDR_DQS_n);
  mp_impl->DDR_DQS(DDR_DQS);
  mp_impl->PS_SRSTB(PS_SRSTB);
  mp_impl->PS_CLK(PS_CLK);
  mp_impl->PS_PORB(PS_PORB);

  // initialize transactors
  mp_M_AXI_GP0_transactor = NULL;
  mp_M_AXI_GP0_ARLOCK_converter = NULL;
  mp_M_AXI_GP0_AWLOCK_converter = NULL;
  mp_M_AXI_GP0_ARLEN_converter = NULL;
  mp_M_AXI_GP0_AWLEN_converter = NULL;
  mp_M_AXI_GP1_transactor = NULL;
  mp_M_AXI_GP1_ARLOCK_converter = NULL;
  mp_M_AXI_GP1_AWLOCK_converter = NULL;
  mp_M_AXI_GP1_ARLEN_converter = NULL;
  mp_M_AXI_GP1_AWLEN_converter = NULL;

  // initialize socket stubs

}

void system_ps_0_0::before_end_of_elaboration()
{
  // configure 'M_AXI_GP0' transactor

  if (xsc::utils::xsc_sim_manager::getInstanceParameterInt("system_ps_0_0", "M_AXI_GP0_TLM_MODE") != 1)
  {
    // Instantiate Socket Stubs

  // 'M_AXI_GP0' transactor parameters
    xsc::common_cpp::properties M_AXI_GP0_transactor_param_props;
    M_AXI_GP0_transactor_param_props.addLong("SUPPORTS_NARROW_BURST", "0");
    M_AXI_GP0_transactor_param_props.addLong("NUM_WRITE_OUTSTANDING", "8");
    M_AXI_GP0_transactor_param_props.addLong("NUM_READ_OUTSTANDING", "8");
    M_AXI_GP0_transactor_param_props.addLong("DATA_WIDTH", "32");
    M_AXI_GP0_transactor_param_props.addLong("FREQ_HZ", "122880000");
    M_AXI_GP0_transactor_param_props.addLong("ID_WIDTH", "12");
    M_AXI_GP0_transactor_param_props.addLong("ADDR_WIDTH", "32");
    M_AXI_GP0_transactor_param_props.addLong("AWUSER_WIDTH", "0");
    M_AXI_GP0_transactor_param_props.addLong("ARUSER_WIDTH", "0");
    M_AXI_GP0_transactor_param_props.addLong("WUSER_WIDTH", "0");
    M_AXI_GP0_transactor_param_props.addLong("RUSER_WIDTH", "0");
    M_AXI_GP0_transactor_param_props.addLong("BUSER_WIDTH", "0");
    M_AXI_GP0_transactor_param_props.addLong("HAS_BURST", "1");
    M_AXI_GP0_transactor_param_props.addLong("HAS_LOCK", "1");
    M_AXI_GP0_transactor_param_props.addLong("HAS_PROT", "1");
    M_AXI_GP0_transactor_param_props.addLong("HAS_CACHE", "1");
    M_AXI_GP0_transactor_param_props.addLong("HAS_QOS", "1");
    M_AXI_GP0_transactor_param_props.addLong("HAS_REGION", "0");
    M_AXI_GP0_transactor_param_props.addLong("HAS_WSTRB", "1");
    M_AXI_GP0_transactor_param_props.addLong("HAS_BRESP", "1");
    M_AXI_GP0_transactor_param_props.addLong("HAS_RRESP", "1");
    M_AXI_GP0_transactor_param_props.addLong("MAX_BURST_LENGTH", "16");
    M_AXI_GP0_transactor_param_props.addLong("NUM_READ_THREADS", "4");
    M_AXI_GP0_transactor_param_props.addLong("NUM_WRITE_THREADS", "4");
    M_AXI_GP0_transactor_param_props.addLong("RUSER_BITS_PER_BYTE", "0");
    M_AXI_GP0_transactor_param_props.addLong("WUSER_BITS_PER_BYTE", "0");
    M_AXI_GP0_transactor_param_props.addLong("HAS_SIZE", "1");
    M_AXI_GP0_transactor_param_props.addLong("HAS_RESET", "0");
    M_AXI_GP0_transactor_param_props.addFloat("PHASE", "0.0");
    M_AXI_GP0_transactor_param_props.addString("PROTOCOL", "AXI3");
    M_AXI_GP0_transactor_param_props.addString("READ_WRITE_MODE", "READ_WRITE");
    M_AXI_GP0_transactor_param_props.addString("CLK_DOMAIN", "/pll_0_clk_out1");

    mp_M_AXI_GP0_transactor = new xtlm::xaximm_xtlm2pin_t<32,32,12,1,1,1,1,1>("M_AXI_GP0_transactor", M_AXI_GP0_transactor_param_props);

    // M_AXI_GP0' transactor ports

    mp_M_AXI_GP0_transactor->ARVALID(M_AXI_GP0_ARVALID);
    mp_M_AXI_GP0_transactor->AWVALID(M_AXI_GP0_AWVALID);
    mp_M_AXI_GP0_transactor->BREADY(M_AXI_GP0_BREADY);
    mp_M_AXI_GP0_transactor->RREADY(M_AXI_GP0_RREADY);
    mp_M_AXI_GP0_transactor->WLAST(M_AXI_GP0_WLAST);
    mp_M_AXI_GP0_transactor->WVALID(M_AXI_GP0_WVALID);
    mp_M_AXI_GP0_transactor->ARID(M_AXI_GP0_ARID);
    mp_M_AXI_GP0_transactor->AWID(M_AXI_GP0_AWID);
    mp_M_AXI_GP0_transactor->ARBURST(M_AXI_GP0_ARBURST);
    mp_M_AXI_GP0_ARLOCK_converter = new xsc::common::scalar2vectorN_converter<2>("M_AXI_GP0_ARLOCK_converter");
    mp_M_AXI_GP0_ARLOCK_converter->scalar_in(m_M_AXI_GP0_ARLOCK_converter_signal);
    mp_M_AXI_GP0_ARLOCK_converter->vector_out(M_AXI_GP0_ARLOCK);
    mp_M_AXI_GP0_transactor->ARLOCK(m_M_AXI_GP0_ARLOCK_converter_signal);
    mp_M_AXI_GP0_transactor->ARSIZE(M_AXI_GP0_ARSIZE);
    mp_M_AXI_GP0_transactor->AWBURST(M_AXI_GP0_AWBURST);
    mp_M_AXI_GP0_AWLOCK_converter = new xsc::common::scalar2vectorN_converter<2>("M_AXI_GP0_AWLOCK_converter");
    mp_M_AXI_GP0_AWLOCK_converter->scalar_in(m_M_AXI_GP0_AWLOCK_converter_signal);
    mp_M_AXI_GP0_AWLOCK_converter->vector_out(M_AXI_GP0_AWLOCK);
    mp_M_AXI_GP0_transactor->AWLOCK(m_M_AXI_GP0_AWLOCK_converter_signal);
    mp_M_AXI_GP0_transactor->AWSIZE(M_AXI_GP0_AWSIZE);
    mp_M_AXI_GP0_transactor->ARPROT(M_AXI_GP0_ARPROT);
    mp_M_AXI_GP0_transactor->AWPROT(M_AXI_GP0_AWPROT);
    mp_M_AXI_GP0_transactor->ARADDR(M_AXI_GP0_ARADDR);
    mp_M_AXI_GP0_transactor->AWADDR(M_AXI_GP0_AWADDR);
    mp_M_AXI_GP0_transactor->WDATA(M_AXI_GP0_WDATA);
    mp_M_AXI_GP0_transactor->ARCACHE(M_AXI_GP0_ARCACHE);
    mp_M_AXI_GP0_ARLEN_converter = new xsc::common::vector2vector_converter<8,4>("M_AXI_GP0_ARLEN_converter");
    mp_M_AXI_GP0_ARLEN_converter->vector_in(m_M_AXI_GP0_ARLEN_converter_signal);
    mp_M_AXI_GP0_ARLEN_converter->vector_out(M_AXI_GP0_ARLEN);
    mp_M_AXI_GP0_transactor->ARLEN(m_M_AXI_GP0_ARLEN_converter_signal);
    mp_M_AXI_GP0_transactor->ARQOS(M_AXI_GP0_ARQOS);
    mp_M_AXI_GP0_transactor->AWCACHE(M_AXI_GP0_AWCACHE);
    mp_M_AXI_GP0_AWLEN_converter = new xsc::common::vector2vector_converter<8,4>("M_AXI_GP0_AWLEN_converter");
    mp_M_AXI_GP0_AWLEN_converter->vector_in(m_M_AXI_GP0_AWLEN_converter_signal);
    mp_M_AXI_GP0_AWLEN_converter->vector_out(M_AXI_GP0_AWLEN);
    mp_M_AXI_GP0_transactor->AWLEN(m_M_AXI_GP0_AWLEN_converter_signal);
    mp_M_AXI_GP0_transactor->AWQOS(M_AXI_GP0_AWQOS);
    mp_M_AXI_GP0_transactor->WSTRB(M_AXI_GP0_WSTRB);
    mp_M_AXI_GP0_transactor->ARREADY(M_AXI_GP0_ARREADY);
    mp_M_AXI_GP0_transactor->AWREADY(M_AXI_GP0_AWREADY);
    mp_M_AXI_GP0_transactor->BVALID(M_AXI_GP0_BVALID);
    mp_M_AXI_GP0_transactor->RLAST(M_AXI_GP0_RLAST);
    mp_M_AXI_GP0_transactor->RVALID(M_AXI_GP0_RVALID);
    mp_M_AXI_GP0_transactor->WREADY(M_AXI_GP0_WREADY);
    mp_M_AXI_GP0_transactor->BID(M_AXI_GP0_BID);
    mp_M_AXI_GP0_transactor->RID(M_AXI_GP0_RID);
    mp_M_AXI_GP0_transactor->BRESP(M_AXI_GP0_BRESP);
    mp_M_AXI_GP0_transactor->RRESP(M_AXI_GP0_RRESP);
    mp_M_AXI_GP0_transactor->RDATA(M_AXI_GP0_RDATA);
    mp_M_AXI_GP0_transactor->CLK(M_AXI_GP0_ACLK);
    m_M_AXI_GP0_transactor_rst_signal.write(1);
    mp_M_AXI_GP0_transactor->RST(m_M_AXI_GP0_transactor_rst_signal);

    // M_AXI_GP0' transactor sockets

    mp_impl->M_AXI_GP0_rd_socket->bind(*(mp_M_AXI_GP0_transactor->rd_socket));
    mp_impl->M_AXI_GP0_wr_socket->bind(*(mp_M_AXI_GP0_transactor->wr_socket));
  }
  else
  {
  }

  // configure 'M_AXI_GP1' transactor

  if (xsc::utils::xsc_sim_manager::getInstanceParameterInt("system_ps_0_0", "M_AXI_GP1_TLM_MODE") != 1)
  {
    // Instantiate Socket Stubs

  // 'M_AXI_GP1' transactor parameters
    xsc::common_cpp::properties M_AXI_GP1_transactor_param_props;
    M_AXI_GP1_transactor_param_props.addLong("NUM_WRITE_OUTSTANDING", "8");
    M_AXI_GP1_transactor_param_props.addLong("NUM_READ_OUTSTANDING", "8");
    M_AXI_GP1_transactor_param_props.addLong("SUPPORTS_NARROW_BURST", "0");
    M_AXI_GP1_transactor_param_props.addLong("DATA_WIDTH", "32");
    M_AXI_GP1_transactor_param_props.addLong("FREQ_HZ", "122880000");
    M_AXI_GP1_transactor_param_props.addLong("ID_WIDTH", "12");
    M_AXI_GP1_transactor_param_props.addLong("ADDR_WIDTH", "32");
    M_AXI_GP1_transactor_param_props.addLong("AWUSER_WIDTH", "0");
    M_AXI_GP1_transactor_param_props.addLong("ARUSER_WIDTH", "0");
    M_AXI_GP1_transactor_param_props.addLong("WUSER_WIDTH", "0");
    M_AXI_GP1_transactor_param_props.addLong("RUSER_WIDTH", "0");
    M_AXI_GP1_transactor_param_props.addLong("BUSER_WIDTH", "0");
    M_AXI_GP1_transactor_param_props.addLong("HAS_BURST", "1");
    M_AXI_GP1_transactor_param_props.addLong("HAS_LOCK", "1");
    M_AXI_GP1_transactor_param_props.addLong("HAS_PROT", "1");
    M_AXI_GP1_transactor_param_props.addLong("HAS_CACHE", "1");
    M_AXI_GP1_transactor_param_props.addLong("HAS_QOS", "1");
    M_AXI_GP1_transactor_param_props.addLong("HAS_REGION", "0");
    M_AXI_GP1_transactor_param_props.addLong("HAS_WSTRB", "1");
    M_AXI_GP1_transactor_param_props.addLong("HAS_BRESP", "1");
    M_AXI_GP1_transactor_param_props.addLong("HAS_RRESP", "1");
    M_AXI_GP1_transactor_param_props.addLong("MAX_BURST_LENGTH", "16");
    M_AXI_GP1_transactor_param_props.addLong("NUM_READ_THREADS", "4");
    M_AXI_GP1_transactor_param_props.addLong("NUM_WRITE_THREADS", "4");
    M_AXI_GP1_transactor_param_props.addLong("RUSER_BITS_PER_BYTE", "0");
    M_AXI_GP1_transactor_param_props.addLong("WUSER_BITS_PER_BYTE", "0");
    M_AXI_GP1_transactor_param_props.addLong("HAS_SIZE", "1");
    M_AXI_GP1_transactor_param_props.addLong("HAS_RESET", "0");
    M_AXI_GP1_transactor_param_props.addFloat("PHASE", "0.0");
    M_AXI_GP1_transactor_param_props.addString("PROTOCOL", "AXI3");
    M_AXI_GP1_transactor_param_props.addString("READ_WRITE_MODE", "READ_WRITE");
    M_AXI_GP1_transactor_param_props.addString("CLK_DOMAIN", "/pll_0_clk_out1");

    mp_M_AXI_GP1_transactor = new xtlm::xaximm_xtlm2pin_t<32,32,12,1,1,1,1,1>("M_AXI_GP1_transactor", M_AXI_GP1_transactor_param_props);

    // M_AXI_GP1' transactor ports

    mp_M_AXI_GP1_transactor->ARVALID(M_AXI_GP1_ARVALID);
    mp_M_AXI_GP1_transactor->AWVALID(M_AXI_GP1_AWVALID);
    mp_M_AXI_GP1_transactor->BREADY(M_AXI_GP1_BREADY);
    mp_M_AXI_GP1_transactor->RREADY(M_AXI_GP1_RREADY);
    mp_M_AXI_GP1_transactor->WLAST(M_AXI_GP1_WLAST);
    mp_M_AXI_GP1_transactor->WVALID(M_AXI_GP1_WVALID);
    mp_M_AXI_GP1_transactor->ARID(M_AXI_GP1_ARID);
    mp_M_AXI_GP1_transactor->AWID(M_AXI_GP1_AWID);
    mp_M_AXI_GP1_transactor->ARBURST(M_AXI_GP1_ARBURST);
    mp_M_AXI_GP1_ARLOCK_converter = new xsc::common::scalar2vectorN_converter<2>("M_AXI_GP1_ARLOCK_converter");
    mp_M_AXI_GP1_ARLOCK_converter->scalar_in(m_M_AXI_GP1_ARLOCK_converter_signal);
    mp_M_AXI_GP1_ARLOCK_converter->vector_out(M_AXI_GP1_ARLOCK);
    mp_M_AXI_GP1_transactor->ARLOCK(m_M_AXI_GP1_ARLOCK_converter_signal);
    mp_M_AXI_GP1_transactor->ARSIZE(M_AXI_GP1_ARSIZE);
    mp_M_AXI_GP1_transactor->AWBURST(M_AXI_GP1_AWBURST);
    mp_M_AXI_GP1_AWLOCK_converter = new xsc::common::scalar2vectorN_converter<2>("M_AXI_GP1_AWLOCK_converter");
    mp_M_AXI_GP1_AWLOCK_converter->scalar_in(m_M_AXI_GP1_AWLOCK_converter_signal);
    mp_M_AXI_GP1_AWLOCK_converter->vector_out(M_AXI_GP1_AWLOCK);
    mp_M_AXI_GP1_transactor->AWLOCK(m_M_AXI_GP1_AWLOCK_converter_signal);
    mp_M_AXI_GP1_transactor->AWSIZE(M_AXI_GP1_AWSIZE);
    mp_M_AXI_GP1_transactor->ARPROT(M_AXI_GP1_ARPROT);
    mp_M_AXI_GP1_transactor->AWPROT(M_AXI_GP1_AWPROT);
    mp_M_AXI_GP1_transactor->ARADDR(M_AXI_GP1_ARADDR);
    mp_M_AXI_GP1_transactor->AWADDR(M_AXI_GP1_AWADDR);
    mp_M_AXI_GP1_transactor->WDATA(M_AXI_GP1_WDATA);
    mp_M_AXI_GP1_transactor->ARCACHE(M_AXI_GP1_ARCACHE);
    mp_M_AXI_GP1_ARLEN_converter = new xsc::common::vector2vector_converter<8,4>("M_AXI_GP1_ARLEN_converter");
    mp_M_AXI_GP1_ARLEN_converter->vector_in(m_M_AXI_GP1_ARLEN_converter_signal);
    mp_M_AXI_GP1_ARLEN_converter->vector_out(M_AXI_GP1_ARLEN);
    mp_M_AXI_GP1_transactor->ARLEN(m_M_AXI_GP1_ARLEN_converter_signal);
    mp_M_AXI_GP1_transactor->ARQOS(M_AXI_GP1_ARQOS);
    mp_M_AXI_GP1_transactor->AWCACHE(M_AXI_GP1_AWCACHE);
    mp_M_AXI_GP1_AWLEN_converter = new xsc::common::vector2vector_converter<8,4>("M_AXI_GP1_AWLEN_converter");
    mp_M_AXI_GP1_AWLEN_converter->vector_in(m_M_AXI_GP1_AWLEN_converter_signal);
    mp_M_AXI_GP1_AWLEN_converter->vector_out(M_AXI_GP1_AWLEN);
    mp_M_AXI_GP1_transactor->AWLEN(m_M_AXI_GP1_AWLEN_converter_signal);
    mp_M_AXI_GP1_transactor->AWQOS(M_AXI_GP1_AWQOS);
    mp_M_AXI_GP1_transactor->WSTRB(M_AXI_GP1_WSTRB);
    mp_M_AXI_GP1_transactor->ARREADY(M_AXI_GP1_ARREADY);
    mp_M_AXI_GP1_transactor->AWREADY(M_AXI_GP1_AWREADY);
    mp_M_AXI_GP1_transactor->BVALID(M_AXI_GP1_BVALID);
    mp_M_AXI_GP1_transactor->RLAST(M_AXI_GP1_RLAST);
    mp_M_AXI_GP1_transactor->RVALID(M_AXI_GP1_RVALID);
    mp_M_AXI_GP1_transactor->WREADY(M_AXI_GP1_WREADY);
    mp_M_AXI_GP1_transactor->BID(M_AXI_GP1_BID);
    mp_M_AXI_GP1_transactor->RID(M_AXI_GP1_RID);
    mp_M_AXI_GP1_transactor->BRESP(M_AXI_GP1_BRESP);
    mp_M_AXI_GP1_transactor->RRESP(M_AXI_GP1_RRESP);
    mp_M_AXI_GP1_transactor->RDATA(M_AXI_GP1_RDATA);
    mp_M_AXI_GP1_transactor->CLK(M_AXI_GP1_ACLK);
    m_M_AXI_GP1_transactor_rst_signal.write(1);
    mp_M_AXI_GP1_transactor->RST(m_M_AXI_GP1_transactor_rst_signal);

    // M_AXI_GP1' transactor sockets

    mp_impl->M_AXI_GP1_rd_socket->bind(*(mp_M_AXI_GP1_transactor->rd_socket));
    mp_impl->M_AXI_GP1_wr_socket->bind(*(mp_M_AXI_GP1_transactor->wr_socket));
  }
  else
  {
  }

}

#endif // XILINX_SIMULATOR




#ifdef XM_SYSTEMC
system_ps_0_0::system_ps_0_0(const sc_core::sc_module_name& nm) : system_ps_0_0_sc(nm), GPIO_I("GPIO_I"), GPIO_O("GPIO_O"), GPIO_T("GPIO_T"), I2C0_SDA_I("I2C0_SDA_I"), I2C0_SDA_O("I2C0_SDA_O"), I2C0_SDA_T("I2C0_SDA_T"), I2C0_SCL_I("I2C0_SCL_I"), I2C0_SCL_O("I2C0_SCL_O"), I2C0_SCL_T("I2C0_SCL_T"), USB0_PORT_INDCTL("USB0_PORT_INDCTL"), USB0_VBUS_PWRSELECT("USB0_VBUS_PWRSELECT"), USB0_VBUS_PWRFAULT("USB0_VBUS_PWRFAULT"), M_AXI_GP0_ARVALID("M_AXI_GP0_ARVALID"), M_AXI_GP0_AWVALID("M_AXI_GP0_AWVALID"), M_AXI_GP0_BREADY("M_AXI_GP0_BREADY"), M_AXI_GP0_RREADY("M_AXI_GP0_RREADY"), M_AXI_GP0_WLAST("M_AXI_GP0_WLAST"), M_AXI_GP0_WVALID("M_AXI_GP0_WVALID"), M_AXI_GP0_ARID("M_AXI_GP0_ARID"), M_AXI_GP0_AWID("M_AXI_GP0_AWID"), M_AXI_GP0_WID("M_AXI_GP0_WID"), M_AXI_GP0_ARBURST("M_AXI_GP0_ARBURST"), M_AXI_GP0_ARLOCK("M_AXI_GP0_ARLOCK"), M_AXI_GP0_ARSIZE("M_AXI_GP0_ARSIZE"), M_AXI_GP0_AWBURST("M_AXI_GP0_AWBURST"), M_AXI_GP0_AWLOCK("M_AXI_GP0_AWLOCK"), M_AXI_GP0_AWSIZE("M_AXI_GP0_AWSIZE"), M_AXI_GP0_ARPROT("M_AXI_GP0_ARPROT"), M_AXI_GP0_AWPROT("M_AXI_GP0_AWPROT"), M_AXI_GP0_ARADDR("M_AXI_GP0_ARADDR"), M_AXI_GP0_AWADDR("M_AXI_GP0_AWADDR"), M_AXI_GP0_WDATA("M_AXI_GP0_WDATA"), M_AXI_GP0_ARCACHE("M_AXI_GP0_ARCACHE"), M_AXI_GP0_ARLEN("M_AXI_GP0_ARLEN"), M_AXI_GP0_ARQOS("M_AXI_GP0_ARQOS"), M_AXI_GP0_AWCACHE("M_AXI_GP0_AWCACHE"), M_AXI_GP0_AWLEN("M_AXI_GP0_AWLEN"), M_AXI_GP0_AWQOS("M_AXI_GP0_AWQOS"), M_AXI_GP0_WSTRB("M_AXI_GP0_WSTRB"), M_AXI_GP0_ACLK("M_AXI_GP0_ACLK"), M_AXI_GP0_ARREADY("M_AXI_GP0_ARREADY"), M_AXI_GP0_AWREADY("M_AXI_GP0_AWREADY"), M_AXI_GP0_BVALID("M_AXI_GP0_BVALID"), M_AXI_GP0_RLAST("M_AXI_GP0_RLAST"), M_AXI_GP0_RVALID("M_AXI_GP0_RVALID"), M_AXI_GP0_WREADY("M_AXI_GP0_WREADY"), M_AXI_GP0_BID("M_AXI_GP0_BID"), M_AXI_GP0_RID("M_AXI_GP0_RID"), M_AXI_GP0_BRESP("M_AXI_GP0_BRESP"), M_AXI_GP0_RRESP("M_AXI_GP0_RRESP"), M_AXI_GP0_RDATA("M_AXI_GP0_RDATA"), M_AXI_GP1_ARVALID("M_AXI_GP1_ARVALID"), M_AXI_GP1_AWVALID("M_AXI_GP1_AWVALID"), M_AXI_GP1_BREADY("M_AXI_GP1_BREADY"), M_AXI_GP1_RREADY("M_AXI_GP1_RREADY"), M_AXI_GP1_WLAST("M_AXI_GP1_WLAST"), M_AXI_GP1_WVALID("M_AXI_GP1_WVALID"), M_AXI_GP1_ARID("M_AXI_GP1_ARID"), M_AXI_GP1_AWID("M_AXI_GP1_AWID"), M_AXI_GP1_WID("M_AXI_GP1_WID"), M_AXI_GP1_ARBURST("M_AXI_GP1_ARBURST"), M_AXI_GP1_ARLOCK("M_AXI_GP1_ARLOCK"), M_AXI_GP1_ARSIZE("M_AXI_GP1_ARSIZE"), M_AXI_GP1_AWBURST("M_AXI_GP1_AWBURST"), M_AXI_GP1_AWLOCK("M_AXI_GP1_AWLOCK"), M_AXI_GP1_AWSIZE("M_AXI_GP1_AWSIZE"), M_AXI_GP1_ARPROT("M_AXI_GP1_ARPROT"), M_AXI_GP1_AWPROT("M_AXI_GP1_AWPROT"), M_AXI_GP1_ARADDR("M_AXI_GP1_ARADDR"), M_AXI_GP1_AWADDR("M_AXI_GP1_AWADDR"), M_AXI_GP1_WDATA("M_AXI_GP1_WDATA"), M_AXI_GP1_ARCACHE("M_AXI_GP1_ARCACHE"), M_AXI_GP1_ARLEN("M_AXI_GP1_ARLEN"), M_AXI_GP1_ARQOS("M_AXI_GP1_ARQOS"), M_AXI_GP1_AWCACHE("M_AXI_GP1_AWCACHE"), M_AXI_GP1_AWLEN("M_AXI_GP1_AWLEN"), M_AXI_GP1_AWQOS("M_AXI_GP1_AWQOS"), M_AXI_GP1_WSTRB("M_AXI_GP1_WSTRB"), M_AXI_GP1_ACLK("M_AXI_GP1_ACLK"), M_AXI_GP1_ARREADY("M_AXI_GP1_ARREADY"), M_AXI_GP1_AWREADY("M_AXI_GP1_AWREADY"), M_AXI_GP1_BVALID("M_AXI_GP1_BVALID"), M_AXI_GP1_RLAST("M_AXI_GP1_RLAST"), M_AXI_GP1_RVALID("M_AXI_GP1_RVALID"), M_AXI_GP1_WREADY("M_AXI_GP1_WREADY"), M_AXI_GP1_BID("M_AXI_GP1_BID"), M_AXI_GP1_RID("M_AXI_GP1_RID"), M_AXI_GP1_BRESP("M_AXI_GP1_BRESP"), M_AXI_GP1_RRESP("M_AXI_GP1_RRESP"), M_AXI_GP1_RDATA("M_AXI_GP1_RDATA"), FCLK_CLK0("FCLK_CLK0"), FCLK_RESET0_N("FCLK_RESET0_N"), MIO("MIO"), DDR_CAS_n("DDR_CAS_n"), DDR_CKE("DDR_CKE"), DDR_Clk_n("DDR_Clk_n"), DDR_Clk("DDR_Clk"), DDR_CS_n("DDR_CS_n"), DDR_DRSTB("DDR_DRSTB"), DDR_ODT("DDR_ODT"), DDR_RAS_n("DDR_RAS_n"), DDR_WEB("DDR_WEB"), DDR_BankAddr("DDR_BankAddr"), DDR_Addr("DDR_Addr"), DDR_VRN("DDR_VRN"), DDR_VRP("DDR_VRP"), DDR_DM("DDR_DM"), DDR_DQ("DDR_DQ"), DDR_DQS_n("DDR_DQS_n"), DDR_DQS("DDR_DQS"), PS_SRSTB("PS_SRSTB"), PS_CLK("PS_CLK"), PS_PORB("PS_PORB")
{

  // initialize pins
  mp_impl->GPIO_I(GPIO_I);
  mp_impl->GPIO_O(GPIO_O);
  mp_impl->GPIO_T(GPIO_T);
  mp_impl->I2C0_SDA_I(I2C0_SDA_I);
  mp_impl->I2C0_SDA_O(I2C0_SDA_O);
  mp_impl->I2C0_SDA_T(I2C0_SDA_T);
  mp_impl->I2C0_SCL_I(I2C0_SCL_I);
  mp_impl->I2C0_SCL_O(I2C0_SCL_O);
  mp_impl->I2C0_SCL_T(I2C0_SCL_T);
  mp_impl->USB0_PORT_INDCTL(USB0_PORT_INDCTL);
  mp_impl->USB0_VBUS_PWRSELECT(USB0_VBUS_PWRSELECT);
  mp_impl->USB0_VBUS_PWRFAULT(USB0_VBUS_PWRFAULT);
  mp_impl->M_AXI_GP0_ACLK(M_AXI_GP0_ACLK);
  mp_impl->M_AXI_GP1_ACLK(M_AXI_GP1_ACLK);
  mp_impl->FCLK_CLK0(FCLK_CLK0);
  mp_impl->FCLK_RESET0_N(FCLK_RESET0_N);
  mp_impl->MIO(MIO);
  mp_impl->DDR_CAS_n(DDR_CAS_n);
  mp_impl->DDR_CKE(DDR_CKE);
  mp_impl->DDR_Clk_n(DDR_Clk_n);
  mp_impl->DDR_Clk(DDR_Clk);
  mp_impl->DDR_CS_n(DDR_CS_n);
  mp_impl->DDR_DRSTB(DDR_DRSTB);
  mp_impl->DDR_ODT(DDR_ODT);
  mp_impl->DDR_RAS_n(DDR_RAS_n);
  mp_impl->DDR_WEB(DDR_WEB);
  mp_impl->DDR_BankAddr(DDR_BankAddr);
  mp_impl->DDR_Addr(DDR_Addr);
  mp_impl->DDR_VRN(DDR_VRN);
  mp_impl->DDR_VRP(DDR_VRP);
  mp_impl->DDR_DM(DDR_DM);
  mp_impl->DDR_DQ(DDR_DQ);
  mp_impl->DDR_DQS_n(DDR_DQS_n);
  mp_impl->DDR_DQS(DDR_DQS);
  mp_impl->PS_SRSTB(PS_SRSTB);
  mp_impl->PS_CLK(PS_CLK);
  mp_impl->PS_PORB(PS_PORB);

  // initialize transactors
  mp_M_AXI_GP0_transactor = NULL;
  mp_M_AXI_GP0_ARLOCK_converter = NULL;
  mp_M_AXI_GP0_AWLOCK_converter = NULL;
  mp_M_AXI_GP0_ARLEN_converter = NULL;
  mp_M_AXI_GP0_AWLEN_converter = NULL;
  mp_M_AXI_GP1_transactor = NULL;
  mp_M_AXI_GP1_ARLOCK_converter = NULL;
  mp_M_AXI_GP1_AWLOCK_converter = NULL;
  mp_M_AXI_GP1_ARLEN_converter = NULL;
  mp_M_AXI_GP1_AWLEN_converter = NULL;

  // initialize socket stubs

}

void system_ps_0_0::before_end_of_elaboration()
{
  // configure 'M_AXI_GP0' transactor

  if (xsc::utils::xsc_sim_manager::getInstanceParameterInt("system_ps_0_0", "M_AXI_GP0_TLM_MODE") != 1)
  {
    // Instantiate Socket Stubs

  // 'M_AXI_GP0' transactor parameters
    xsc::common_cpp::properties M_AXI_GP0_transactor_param_props;
    M_AXI_GP0_transactor_param_props.addLong("SUPPORTS_NARROW_BURST", "0");
    M_AXI_GP0_transactor_param_props.addLong("NUM_WRITE_OUTSTANDING", "8");
    M_AXI_GP0_transactor_param_props.addLong("NUM_READ_OUTSTANDING", "8");
    M_AXI_GP0_transactor_param_props.addLong("DATA_WIDTH", "32");
    M_AXI_GP0_transactor_param_props.addLong("FREQ_HZ", "122880000");
    M_AXI_GP0_transactor_param_props.addLong("ID_WIDTH", "12");
    M_AXI_GP0_transactor_param_props.addLong("ADDR_WIDTH", "32");
    M_AXI_GP0_transactor_param_props.addLong("AWUSER_WIDTH", "0");
    M_AXI_GP0_transactor_param_props.addLong("ARUSER_WIDTH", "0");
    M_AXI_GP0_transactor_param_props.addLong("WUSER_WIDTH", "0");
    M_AXI_GP0_transactor_param_props.addLong("RUSER_WIDTH", "0");
    M_AXI_GP0_transactor_param_props.addLong("BUSER_WIDTH", "0");
    M_AXI_GP0_transactor_param_props.addLong("HAS_BURST", "1");
    M_AXI_GP0_transactor_param_props.addLong("HAS_LOCK", "1");
    M_AXI_GP0_transactor_param_props.addLong("HAS_PROT", "1");
    M_AXI_GP0_transactor_param_props.addLong("HAS_CACHE", "1");
    M_AXI_GP0_transactor_param_props.addLong("HAS_QOS", "1");
    M_AXI_GP0_transactor_param_props.addLong("HAS_REGION", "0");
    M_AXI_GP0_transactor_param_props.addLong("HAS_WSTRB", "1");
    M_AXI_GP0_transactor_param_props.addLong("HAS_BRESP", "1");
    M_AXI_GP0_transactor_param_props.addLong("HAS_RRESP", "1");
    M_AXI_GP0_transactor_param_props.addLong("MAX_BURST_LENGTH", "16");
    M_AXI_GP0_transactor_param_props.addLong("NUM_READ_THREADS", "4");
    M_AXI_GP0_transactor_param_props.addLong("NUM_WRITE_THREADS", "4");
    M_AXI_GP0_transactor_param_props.addLong("RUSER_BITS_PER_BYTE", "0");
    M_AXI_GP0_transactor_param_props.addLong("WUSER_BITS_PER_BYTE", "0");
    M_AXI_GP0_transactor_param_props.addLong("HAS_SIZE", "1");
    M_AXI_GP0_transactor_param_props.addLong("HAS_RESET", "0");
    M_AXI_GP0_transactor_param_props.addFloat("PHASE", "0.0");
    M_AXI_GP0_transactor_param_props.addString("PROTOCOL", "AXI3");
    M_AXI_GP0_transactor_param_props.addString("READ_WRITE_MODE", "READ_WRITE");
    M_AXI_GP0_transactor_param_props.addString("CLK_DOMAIN", "/pll_0_clk_out1");

    mp_M_AXI_GP0_transactor = new xtlm::xaximm_xtlm2pin_t<32,32,12,1,1,1,1,1>("M_AXI_GP0_transactor", M_AXI_GP0_transactor_param_props);

    // M_AXI_GP0' transactor ports

    mp_M_AXI_GP0_transactor->ARVALID(M_AXI_GP0_ARVALID);
    mp_M_AXI_GP0_transactor->AWVALID(M_AXI_GP0_AWVALID);
    mp_M_AXI_GP0_transactor->BREADY(M_AXI_GP0_BREADY);
    mp_M_AXI_GP0_transactor->RREADY(M_AXI_GP0_RREADY);
    mp_M_AXI_GP0_transactor->WLAST(M_AXI_GP0_WLAST);
    mp_M_AXI_GP0_transactor->WVALID(M_AXI_GP0_WVALID);
    mp_M_AXI_GP0_transactor->ARID(M_AXI_GP0_ARID);
    mp_M_AXI_GP0_transactor->AWID(M_AXI_GP0_AWID);
    mp_M_AXI_GP0_transactor->ARBURST(M_AXI_GP0_ARBURST);
    mp_M_AXI_GP0_ARLOCK_converter = new xsc::common::scalar2vectorN_converter<2>("M_AXI_GP0_ARLOCK_converter");
    mp_M_AXI_GP0_ARLOCK_converter->scalar_in(m_M_AXI_GP0_ARLOCK_converter_signal);
    mp_M_AXI_GP0_ARLOCK_converter->vector_out(M_AXI_GP0_ARLOCK);
    mp_M_AXI_GP0_transactor->ARLOCK(m_M_AXI_GP0_ARLOCK_converter_signal);
    mp_M_AXI_GP0_transactor->ARSIZE(M_AXI_GP0_ARSIZE);
    mp_M_AXI_GP0_transactor->AWBURST(M_AXI_GP0_AWBURST);
    mp_M_AXI_GP0_AWLOCK_converter = new xsc::common::scalar2vectorN_converter<2>("M_AXI_GP0_AWLOCK_converter");
    mp_M_AXI_GP0_AWLOCK_converter->scalar_in(m_M_AXI_GP0_AWLOCK_converter_signal);
    mp_M_AXI_GP0_AWLOCK_converter->vector_out(M_AXI_GP0_AWLOCK);
    mp_M_AXI_GP0_transactor->AWLOCK(m_M_AXI_GP0_AWLOCK_converter_signal);
    mp_M_AXI_GP0_transactor->AWSIZE(M_AXI_GP0_AWSIZE);
    mp_M_AXI_GP0_transactor->ARPROT(M_AXI_GP0_ARPROT);
    mp_M_AXI_GP0_transactor->AWPROT(M_AXI_GP0_AWPROT);
    mp_M_AXI_GP0_transactor->ARADDR(M_AXI_GP0_ARADDR);
    mp_M_AXI_GP0_transactor->AWADDR(M_AXI_GP0_AWADDR);
    mp_M_AXI_GP0_transactor->WDATA(M_AXI_GP0_WDATA);
    mp_M_AXI_GP0_transactor->ARCACHE(M_AXI_GP0_ARCACHE);
    mp_M_AXI_GP0_ARLEN_converter = new xsc::common::vector2vector_converter<8,4>("M_AXI_GP0_ARLEN_converter");
    mp_M_AXI_GP0_ARLEN_converter->vector_in(m_M_AXI_GP0_ARLEN_converter_signal);
    mp_M_AXI_GP0_ARLEN_converter->vector_out(M_AXI_GP0_ARLEN);
    mp_M_AXI_GP0_transactor->ARLEN(m_M_AXI_GP0_ARLEN_converter_signal);
    mp_M_AXI_GP0_transactor->ARQOS(M_AXI_GP0_ARQOS);
    mp_M_AXI_GP0_transactor->AWCACHE(M_AXI_GP0_AWCACHE);
    mp_M_AXI_GP0_AWLEN_converter = new xsc::common::vector2vector_converter<8,4>("M_AXI_GP0_AWLEN_converter");
    mp_M_AXI_GP0_AWLEN_converter->vector_in(m_M_AXI_GP0_AWLEN_converter_signal);
    mp_M_AXI_GP0_AWLEN_converter->vector_out(M_AXI_GP0_AWLEN);
    mp_M_AXI_GP0_transactor->AWLEN(m_M_AXI_GP0_AWLEN_converter_signal);
    mp_M_AXI_GP0_transactor->AWQOS(M_AXI_GP0_AWQOS);
    mp_M_AXI_GP0_transactor->WSTRB(M_AXI_GP0_WSTRB);
    mp_M_AXI_GP0_transactor->ARREADY(M_AXI_GP0_ARREADY);
    mp_M_AXI_GP0_transactor->AWREADY(M_AXI_GP0_AWREADY);
    mp_M_AXI_GP0_transactor->BVALID(M_AXI_GP0_BVALID);
    mp_M_AXI_GP0_transactor->RLAST(M_AXI_GP0_RLAST);
    mp_M_AXI_GP0_transactor->RVALID(M_AXI_GP0_RVALID);
    mp_M_AXI_GP0_transactor->WREADY(M_AXI_GP0_WREADY);
    mp_M_AXI_GP0_transactor->BID(M_AXI_GP0_BID);
    mp_M_AXI_GP0_transactor->RID(M_AXI_GP0_RID);
    mp_M_AXI_GP0_transactor->BRESP(M_AXI_GP0_BRESP);
    mp_M_AXI_GP0_transactor->RRESP(M_AXI_GP0_RRESP);
    mp_M_AXI_GP0_transactor->RDATA(M_AXI_GP0_RDATA);
    mp_M_AXI_GP0_transactor->CLK(M_AXI_GP0_ACLK);
    m_M_AXI_GP0_transactor_rst_signal.write(1);
    mp_M_AXI_GP0_transactor->RST(m_M_AXI_GP0_transactor_rst_signal);

    // M_AXI_GP0' transactor sockets

    mp_impl->M_AXI_GP0_rd_socket->bind(*(mp_M_AXI_GP0_transactor->rd_socket));
    mp_impl->M_AXI_GP0_wr_socket->bind(*(mp_M_AXI_GP0_transactor->wr_socket));
  }
  else
  {
  }

  // configure 'M_AXI_GP1' transactor

  if (xsc::utils::xsc_sim_manager::getInstanceParameterInt("system_ps_0_0", "M_AXI_GP1_TLM_MODE") != 1)
  {
    // Instantiate Socket Stubs

  // 'M_AXI_GP1' transactor parameters
    xsc::common_cpp::properties M_AXI_GP1_transactor_param_props;
    M_AXI_GP1_transactor_param_props.addLong("NUM_WRITE_OUTSTANDING", "8");
    M_AXI_GP1_transactor_param_props.addLong("NUM_READ_OUTSTANDING", "8");
    M_AXI_GP1_transactor_param_props.addLong("SUPPORTS_NARROW_BURST", "0");
    M_AXI_GP1_transactor_param_props.addLong("DATA_WIDTH", "32");
    M_AXI_GP1_transactor_param_props.addLong("FREQ_HZ", "122880000");
    M_AXI_GP1_transactor_param_props.addLong("ID_WIDTH", "12");
    M_AXI_GP1_transactor_param_props.addLong("ADDR_WIDTH", "32");
    M_AXI_GP1_transactor_param_props.addLong("AWUSER_WIDTH", "0");
    M_AXI_GP1_transactor_param_props.addLong("ARUSER_WIDTH", "0");
    M_AXI_GP1_transactor_param_props.addLong("WUSER_WIDTH", "0");
    M_AXI_GP1_transactor_param_props.addLong("RUSER_WIDTH", "0");
    M_AXI_GP1_transactor_param_props.addLong("BUSER_WIDTH", "0");
    M_AXI_GP1_transactor_param_props.addLong("HAS_BURST", "1");
    M_AXI_GP1_transactor_param_props.addLong("HAS_LOCK", "1");
    M_AXI_GP1_transactor_param_props.addLong("HAS_PROT", "1");
    M_AXI_GP1_transactor_param_props.addLong("HAS_CACHE", "1");
    M_AXI_GP1_transactor_param_props.addLong("HAS_QOS", "1");
    M_AXI_GP1_transactor_param_props.addLong("HAS_REGION", "0");
    M_AXI_GP1_transactor_param_props.addLong("HAS_WSTRB", "1");
    M_AXI_GP1_transactor_param_props.addLong("HAS_BRESP", "1");
    M_AXI_GP1_transactor_param_props.addLong("HAS_RRESP", "1");
    M_AXI_GP1_transactor_param_props.addLong("MAX_BURST_LENGTH", "16");
    M_AXI_GP1_transactor_param_props.addLong("NUM_READ_THREADS", "4");
    M_AXI_GP1_transactor_param_props.addLong("NUM_WRITE_THREADS", "4");
    M_AXI_GP1_transactor_param_props.addLong("RUSER_BITS_PER_BYTE", "0");
    M_AXI_GP1_transactor_param_props.addLong("WUSER_BITS_PER_BYTE", "0");
    M_AXI_GP1_transactor_param_props.addLong("HAS_SIZE", "1");
    M_AXI_GP1_transactor_param_props.addLong("HAS_RESET", "0");
    M_AXI_GP1_transactor_param_props.addFloat("PHASE", "0.0");
    M_AXI_GP1_transactor_param_props.addString("PROTOCOL", "AXI3");
    M_AXI_GP1_transactor_param_props.addString("READ_WRITE_MODE", "READ_WRITE");
    M_AXI_GP1_transactor_param_props.addString("CLK_DOMAIN", "/pll_0_clk_out1");

    mp_M_AXI_GP1_transactor = new xtlm::xaximm_xtlm2pin_t<32,32,12,1,1,1,1,1>("M_AXI_GP1_transactor", M_AXI_GP1_transactor_param_props);

    // M_AXI_GP1' transactor ports

    mp_M_AXI_GP1_transactor->ARVALID(M_AXI_GP1_ARVALID);
    mp_M_AXI_GP1_transactor->AWVALID(M_AXI_GP1_AWVALID);
    mp_M_AXI_GP1_transactor->BREADY(M_AXI_GP1_BREADY);
    mp_M_AXI_GP1_transactor->RREADY(M_AXI_GP1_RREADY);
    mp_M_AXI_GP1_transactor->WLAST(M_AXI_GP1_WLAST);
    mp_M_AXI_GP1_transactor->WVALID(M_AXI_GP1_WVALID);
    mp_M_AXI_GP1_transactor->ARID(M_AXI_GP1_ARID);
    mp_M_AXI_GP1_transactor->AWID(M_AXI_GP1_AWID);
    mp_M_AXI_GP1_transactor->ARBURST(M_AXI_GP1_ARBURST);
    mp_M_AXI_GP1_ARLOCK_converter = new xsc::common::scalar2vectorN_converter<2>("M_AXI_GP1_ARLOCK_converter");
    mp_M_AXI_GP1_ARLOCK_converter->scalar_in(m_M_AXI_GP1_ARLOCK_converter_signal);
    mp_M_AXI_GP1_ARLOCK_converter->vector_out(M_AXI_GP1_ARLOCK);
    mp_M_AXI_GP1_transactor->ARLOCK(m_M_AXI_GP1_ARLOCK_converter_signal);
    mp_M_AXI_GP1_transactor->ARSIZE(M_AXI_GP1_ARSIZE);
    mp_M_AXI_GP1_transactor->AWBURST(M_AXI_GP1_AWBURST);
    mp_M_AXI_GP1_AWLOCK_converter = new xsc::common::scalar2vectorN_converter<2>("M_AXI_GP1_AWLOCK_converter");
    mp_M_AXI_GP1_AWLOCK_converter->scalar_in(m_M_AXI_GP1_AWLOCK_converter_signal);
    mp_M_AXI_GP1_AWLOCK_converter->vector_out(M_AXI_GP1_AWLOCK);
    mp_M_AXI_GP1_transactor->AWLOCK(m_M_AXI_GP1_AWLOCK_converter_signal);
    mp_M_AXI_GP1_transactor->AWSIZE(M_AXI_GP1_AWSIZE);
    mp_M_AXI_GP1_transactor->ARPROT(M_AXI_GP1_ARPROT);
    mp_M_AXI_GP1_transactor->AWPROT(M_AXI_GP1_AWPROT);
    mp_M_AXI_GP1_transactor->ARADDR(M_AXI_GP1_ARADDR);
    mp_M_AXI_GP1_transactor->AWADDR(M_AXI_GP1_AWADDR);
    mp_M_AXI_GP1_transactor->WDATA(M_AXI_GP1_WDATA);
    mp_M_AXI_GP1_transactor->ARCACHE(M_AXI_GP1_ARCACHE);
    mp_M_AXI_GP1_ARLEN_converter = new xsc::common::vector2vector_converter<8,4>("M_AXI_GP1_ARLEN_converter");
    mp_M_AXI_GP1_ARLEN_converter->vector_in(m_M_AXI_GP1_ARLEN_converter_signal);
    mp_M_AXI_GP1_ARLEN_converter->vector_out(M_AXI_GP1_ARLEN);
    mp_M_AXI_GP1_transactor->ARLEN(m_M_AXI_GP1_ARLEN_converter_signal);
    mp_M_AXI_GP1_transactor->ARQOS(M_AXI_GP1_ARQOS);
    mp_M_AXI_GP1_transactor->AWCACHE(M_AXI_GP1_AWCACHE);
    mp_M_AXI_GP1_AWLEN_converter = new xsc::common::vector2vector_converter<8,4>("M_AXI_GP1_AWLEN_converter");
    mp_M_AXI_GP1_AWLEN_converter->vector_in(m_M_AXI_GP1_AWLEN_converter_signal);
    mp_M_AXI_GP1_AWLEN_converter->vector_out(M_AXI_GP1_AWLEN);
    mp_M_AXI_GP1_transactor->AWLEN(m_M_AXI_GP1_AWLEN_converter_signal);
    mp_M_AXI_GP1_transactor->AWQOS(M_AXI_GP1_AWQOS);
    mp_M_AXI_GP1_transactor->WSTRB(M_AXI_GP1_WSTRB);
    mp_M_AXI_GP1_transactor->ARREADY(M_AXI_GP1_ARREADY);
    mp_M_AXI_GP1_transactor->AWREADY(M_AXI_GP1_AWREADY);
    mp_M_AXI_GP1_transactor->BVALID(M_AXI_GP1_BVALID);
    mp_M_AXI_GP1_transactor->RLAST(M_AXI_GP1_RLAST);
    mp_M_AXI_GP1_transactor->RVALID(M_AXI_GP1_RVALID);
    mp_M_AXI_GP1_transactor->WREADY(M_AXI_GP1_WREADY);
    mp_M_AXI_GP1_transactor->BID(M_AXI_GP1_BID);
    mp_M_AXI_GP1_transactor->RID(M_AXI_GP1_RID);
    mp_M_AXI_GP1_transactor->BRESP(M_AXI_GP1_BRESP);
    mp_M_AXI_GP1_transactor->RRESP(M_AXI_GP1_RRESP);
    mp_M_AXI_GP1_transactor->RDATA(M_AXI_GP1_RDATA);
    mp_M_AXI_GP1_transactor->CLK(M_AXI_GP1_ACLK);
    m_M_AXI_GP1_transactor_rst_signal.write(1);
    mp_M_AXI_GP1_transactor->RST(m_M_AXI_GP1_transactor_rst_signal);

    // M_AXI_GP1' transactor sockets

    mp_impl->M_AXI_GP1_rd_socket->bind(*(mp_M_AXI_GP1_transactor->rd_socket));
    mp_impl->M_AXI_GP1_wr_socket->bind(*(mp_M_AXI_GP1_transactor->wr_socket));
  }
  else
  {
  }

}

#endif // XM_SYSTEMC




#ifdef RIVIERA
system_ps_0_0::system_ps_0_0(const sc_core::sc_module_name& nm) : system_ps_0_0_sc(nm), GPIO_I("GPIO_I"), GPIO_O("GPIO_O"), GPIO_T("GPIO_T"), I2C0_SDA_I("I2C0_SDA_I"), I2C0_SDA_O("I2C0_SDA_O"), I2C0_SDA_T("I2C0_SDA_T"), I2C0_SCL_I("I2C0_SCL_I"), I2C0_SCL_O("I2C0_SCL_O"), I2C0_SCL_T("I2C0_SCL_T"), USB0_PORT_INDCTL("USB0_PORT_INDCTL"), USB0_VBUS_PWRSELECT("USB0_VBUS_PWRSELECT"), USB0_VBUS_PWRFAULT("USB0_VBUS_PWRFAULT"), M_AXI_GP0_ARVALID("M_AXI_GP0_ARVALID"), M_AXI_GP0_AWVALID("M_AXI_GP0_AWVALID"), M_AXI_GP0_BREADY("M_AXI_GP0_BREADY"), M_AXI_GP0_RREADY("M_AXI_GP0_RREADY"), M_AXI_GP0_WLAST("M_AXI_GP0_WLAST"), M_AXI_GP0_WVALID("M_AXI_GP0_WVALID"), M_AXI_GP0_ARID("M_AXI_GP0_ARID"), M_AXI_GP0_AWID("M_AXI_GP0_AWID"), M_AXI_GP0_WID("M_AXI_GP0_WID"), M_AXI_GP0_ARBURST("M_AXI_GP0_ARBURST"), M_AXI_GP0_ARLOCK("M_AXI_GP0_ARLOCK"), M_AXI_GP0_ARSIZE("M_AXI_GP0_ARSIZE"), M_AXI_GP0_AWBURST("M_AXI_GP0_AWBURST"), M_AXI_GP0_AWLOCK("M_AXI_GP0_AWLOCK"), M_AXI_GP0_AWSIZE("M_AXI_GP0_AWSIZE"), M_AXI_GP0_ARPROT("M_AXI_GP0_ARPROT"), M_AXI_GP0_AWPROT("M_AXI_GP0_AWPROT"), M_AXI_GP0_ARADDR("M_AXI_GP0_ARADDR"), M_AXI_GP0_AWADDR("M_AXI_GP0_AWADDR"), M_AXI_GP0_WDATA("M_AXI_GP0_WDATA"), M_AXI_GP0_ARCACHE("M_AXI_GP0_ARCACHE"), M_AXI_GP0_ARLEN("M_AXI_GP0_ARLEN"), M_AXI_GP0_ARQOS("M_AXI_GP0_ARQOS"), M_AXI_GP0_AWCACHE("M_AXI_GP0_AWCACHE"), M_AXI_GP0_AWLEN("M_AXI_GP0_AWLEN"), M_AXI_GP0_AWQOS("M_AXI_GP0_AWQOS"), M_AXI_GP0_WSTRB("M_AXI_GP0_WSTRB"), M_AXI_GP0_ACLK("M_AXI_GP0_ACLK"), M_AXI_GP0_ARREADY("M_AXI_GP0_ARREADY"), M_AXI_GP0_AWREADY("M_AXI_GP0_AWREADY"), M_AXI_GP0_BVALID("M_AXI_GP0_BVALID"), M_AXI_GP0_RLAST("M_AXI_GP0_RLAST"), M_AXI_GP0_RVALID("M_AXI_GP0_RVALID"), M_AXI_GP0_WREADY("M_AXI_GP0_WREADY"), M_AXI_GP0_BID("M_AXI_GP0_BID"), M_AXI_GP0_RID("M_AXI_GP0_RID"), M_AXI_GP0_BRESP("M_AXI_GP0_BRESP"), M_AXI_GP0_RRESP("M_AXI_GP0_RRESP"), M_AXI_GP0_RDATA("M_AXI_GP0_RDATA"), M_AXI_GP1_ARVALID("M_AXI_GP1_ARVALID"), M_AXI_GP1_AWVALID("M_AXI_GP1_AWVALID"), M_AXI_GP1_BREADY("M_AXI_GP1_BREADY"), M_AXI_GP1_RREADY("M_AXI_GP1_RREADY"), M_AXI_GP1_WLAST("M_AXI_GP1_WLAST"), M_AXI_GP1_WVALID("M_AXI_GP1_WVALID"), M_AXI_GP1_ARID("M_AXI_GP1_ARID"), M_AXI_GP1_AWID("M_AXI_GP1_AWID"), M_AXI_GP1_WID("M_AXI_GP1_WID"), M_AXI_GP1_ARBURST("M_AXI_GP1_ARBURST"), M_AXI_GP1_ARLOCK("M_AXI_GP1_ARLOCK"), M_AXI_GP1_ARSIZE("M_AXI_GP1_ARSIZE"), M_AXI_GP1_AWBURST("M_AXI_GP1_AWBURST"), M_AXI_GP1_AWLOCK("M_AXI_GP1_AWLOCK"), M_AXI_GP1_AWSIZE("M_AXI_GP1_AWSIZE"), M_AXI_GP1_ARPROT("M_AXI_GP1_ARPROT"), M_AXI_GP1_AWPROT("M_AXI_GP1_AWPROT"), M_AXI_GP1_ARADDR("M_AXI_GP1_ARADDR"), M_AXI_GP1_AWADDR("M_AXI_GP1_AWADDR"), M_AXI_GP1_WDATA("M_AXI_GP1_WDATA"), M_AXI_GP1_ARCACHE("M_AXI_GP1_ARCACHE"), M_AXI_GP1_ARLEN("M_AXI_GP1_ARLEN"), M_AXI_GP1_ARQOS("M_AXI_GP1_ARQOS"), M_AXI_GP1_AWCACHE("M_AXI_GP1_AWCACHE"), M_AXI_GP1_AWLEN("M_AXI_GP1_AWLEN"), M_AXI_GP1_AWQOS("M_AXI_GP1_AWQOS"), M_AXI_GP1_WSTRB("M_AXI_GP1_WSTRB"), M_AXI_GP1_ACLK("M_AXI_GP1_ACLK"), M_AXI_GP1_ARREADY("M_AXI_GP1_ARREADY"), M_AXI_GP1_AWREADY("M_AXI_GP1_AWREADY"), M_AXI_GP1_BVALID("M_AXI_GP1_BVALID"), M_AXI_GP1_RLAST("M_AXI_GP1_RLAST"), M_AXI_GP1_RVALID("M_AXI_GP1_RVALID"), M_AXI_GP1_WREADY("M_AXI_GP1_WREADY"), M_AXI_GP1_BID("M_AXI_GP1_BID"), M_AXI_GP1_RID("M_AXI_GP1_RID"), M_AXI_GP1_BRESP("M_AXI_GP1_BRESP"), M_AXI_GP1_RRESP("M_AXI_GP1_RRESP"), M_AXI_GP1_RDATA("M_AXI_GP1_RDATA"), FCLK_CLK0("FCLK_CLK0"), FCLK_RESET0_N("FCLK_RESET0_N"), MIO("MIO"), DDR_CAS_n("DDR_CAS_n"), DDR_CKE("DDR_CKE"), DDR_Clk_n("DDR_Clk_n"), DDR_Clk("DDR_Clk"), DDR_CS_n("DDR_CS_n"), DDR_DRSTB("DDR_DRSTB"), DDR_ODT("DDR_ODT"), DDR_RAS_n("DDR_RAS_n"), DDR_WEB("DDR_WEB"), DDR_BankAddr("DDR_BankAddr"), DDR_Addr("DDR_Addr"), DDR_VRN("DDR_VRN"), DDR_VRP("DDR_VRP"), DDR_DM("DDR_DM"), DDR_DQ("DDR_DQ"), DDR_DQS_n("DDR_DQS_n"), DDR_DQS("DDR_DQS"), PS_SRSTB("PS_SRSTB"), PS_CLK("PS_CLK"), PS_PORB("PS_PORB")
{

  // initialize pins
  mp_impl->GPIO_I(GPIO_I);
  mp_impl->GPIO_O(GPIO_O);
  mp_impl->GPIO_T(GPIO_T);
  mp_impl->I2C0_SDA_I(I2C0_SDA_I);
  mp_impl->I2C0_SDA_O(I2C0_SDA_O);
  mp_impl->I2C0_SDA_T(I2C0_SDA_T);
  mp_impl->I2C0_SCL_I(I2C0_SCL_I);
  mp_impl->I2C0_SCL_O(I2C0_SCL_O);
  mp_impl->I2C0_SCL_T(I2C0_SCL_T);
  mp_impl->USB0_PORT_INDCTL(USB0_PORT_INDCTL);
  mp_impl->USB0_VBUS_PWRSELECT(USB0_VBUS_PWRSELECT);
  mp_impl->USB0_VBUS_PWRFAULT(USB0_VBUS_PWRFAULT);
  mp_impl->M_AXI_GP0_ACLK(M_AXI_GP0_ACLK);
  mp_impl->M_AXI_GP1_ACLK(M_AXI_GP1_ACLK);
  mp_impl->FCLK_CLK0(FCLK_CLK0);
  mp_impl->FCLK_RESET0_N(FCLK_RESET0_N);
  mp_impl->MIO(MIO);
  mp_impl->DDR_CAS_n(DDR_CAS_n);
  mp_impl->DDR_CKE(DDR_CKE);
  mp_impl->DDR_Clk_n(DDR_Clk_n);
  mp_impl->DDR_Clk(DDR_Clk);
  mp_impl->DDR_CS_n(DDR_CS_n);
  mp_impl->DDR_DRSTB(DDR_DRSTB);
  mp_impl->DDR_ODT(DDR_ODT);
  mp_impl->DDR_RAS_n(DDR_RAS_n);
  mp_impl->DDR_WEB(DDR_WEB);
  mp_impl->DDR_BankAddr(DDR_BankAddr);
  mp_impl->DDR_Addr(DDR_Addr);
  mp_impl->DDR_VRN(DDR_VRN);
  mp_impl->DDR_VRP(DDR_VRP);
  mp_impl->DDR_DM(DDR_DM);
  mp_impl->DDR_DQ(DDR_DQ);
  mp_impl->DDR_DQS_n(DDR_DQS_n);
  mp_impl->DDR_DQS(DDR_DQS);
  mp_impl->PS_SRSTB(PS_SRSTB);
  mp_impl->PS_CLK(PS_CLK);
  mp_impl->PS_PORB(PS_PORB);

  // initialize transactors
  mp_M_AXI_GP0_transactor = NULL;
  mp_M_AXI_GP0_ARLOCK_converter = NULL;
  mp_M_AXI_GP0_AWLOCK_converter = NULL;
  mp_M_AXI_GP0_ARLEN_converter = NULL;
  mp_M_AXI_GP0_AWLEN_converter = NULL;
  mp_M_AXI_GP1_transactor = NULL;
  mp_M_AXI_GP1_ARLOCK_converter = NULL;
  mp_M_AXI_GP1_AWLOCK_converter = NULL;
  mp_M_AXI_GP1_ARLEN_converter = NULL;
  mp_M_AXI_GP1_AWLEN_converter = NULL;

  // initialize socket stubs

}

void system_ps_0_0::before_end_of_elaboration()
{
  // configure 'M_AXI_GP0' transactor

  if (xsc::utils::xsc_sim_manager::getInstanceParameterInt("system_ps_0_0", "M_AXI_GP0_TLM_MODE") != 1)
  {
    // Instantiate Socket Stubs

  // 'M_AXI_GP0' transactor parameters
    xsc::common_cpp::properties M_AXI_GP0_transactor_param_props;
    M_AXI_GP0_transactor_param_props.addLong("SUPPORTS_NARROW_BURST", "0");
    M_AXI_GP0_transactor_param_props.addLong("NUM_WRITE_OUTSTANDING", "8");
    M_AXI_GP0_transactor_param_props.addLong("NUM_READ_OUTSTANDING", "8");
    M_AXI_GP0_transactor_param_props.addLong("DATA_WIDTH", "32");
    M_AXI_GP0_transactor_param_props.addLong("FREQ_HZ", "122880000");
    M_AXI_GP0_transactor_param_props.addLong("ID_WIDTH", "12");
    M_AXI_GP0_transactor_param_props.addLong("ADDR_WIDTH", "32");
    M_AXI_GP0_transactor_param_props.addLong("AWUSER_WIDTH", "0");
    M_AXI_GP0_transactor_param_props.addLong("ARUSER_WIDTH", "0");
    M_AXI_GP0_transactor_param_props.addLong("WUSER_WIDTH", "0");
    M_AXI_GP0_transactor_param_props.addLong("RUSER_WIDTH", "0");
    M_AXI_GP0_transactor_param_props.addLong("BUSER_WIDTH", "0");
    M_AXI_GP0_transactor_param_props.addLong("HAS_BURST", "1");
    M_AXI_GP0_transactor_param_props.addLong("HAS_LOCK", "1");
    M_AXI_GP0_transactor_param_props.addLong("HAS_PROT", "1");
    M_AXI_GP0_transactor_param_props.addLong("HAS_CACHE", "1");
    M_AXI_GP0_transactor_param_props.addLong("HAS_QOS", "1");
    M_AXI_GP0_transactor_param_props.addLong("HAS_REGION", "0");
    M_AXI_GP0_transactor_param_props.addLong("HAS_WSTRB", "1");
    M_AXI_GP0_transactor_param_props.addLong("HAS_BRESP", "1");
    M_AXI_GP0_transactor_param_props.addLong("HAS_RRESP", "1");
    M_AXI_GP0_transactor_param_props.addLong("MAX_BURST_LENGTH", "16");
    M_AXI_GP0_transactor_param_props.addLong("NUM_READ_THREADS", "4");
    M_AXI_GP0_transactor_param_props.addLong("NUM_WRITE_THREADS", "4");
    M_AXI_GP0_transactor_param_props.addLong("RUSER_BITS_PER_BYTE", "0");
    M_AXI_GP0_transactor_param_props.addLong("WUSER_BITS_PER_BYTE", "0");
    M_AXI_GP0_transactor_param_props.addLong("HAS_SIZE", "1");
    M_AXI_GP0_transactor_param_props.addLong("HAS_RESET", "0");
    M_AXI_GP0_transactor_param_props.addFloat("PHASE", "0.0");
    M_AXI_GP0_transactor_param_props.addString("PROTOCOL", "AXI3");
    M_AXI_GP0_transactor_param_props.addString("READ_WRITE_MODE", "READ_WRITE");
    M_AXI_GP0_transactor_param_props.addString("CLK_DOMAIN", "/pll_0_clk_out1");

    mp_M_AXI_GP0_transactor = new xtlm::xaximm_xtlm2pin_t<32,32,12,1,1,1,1,1>("M_AXI_GP0_transactor", M_AXI_GP0_transactor_param_props);

    // M_AXI_GP0' transactor ports

    mp_M_AXI_GP0_transactor->ARVALID(M_AXI_GP0_ARVALID);
    mp_M_AXI_GP0_transactor->AWVALID(M_AXI_GP0_AWVALID);
    mp_M_AXI_GP0_transactor->BREADY(M_AXI_GP0_BREADY);
    mp_M_AXI_GP0_transactor->RREADY(M_AXI_GP0_RREADY);
    mp_M_AXI_GP0_transactor->WLAST(M_AXI_GP0_WLAST);
    mp_M_AXI_GP0_transactor->WVALID(M_AXI_GP0_WVALID);
    mp_M_AXI_GP0_transactor->ARID(M_AXI_GP0_ARID);
    mp_M_AXI_GP0_transactor->AWID(M_AXI_GP0_AWID);
    mp_M_AXI_GP0_transactor->ARBURST(M_AXI_GP0_ARBURST);
    mp_M_AXI_GP0_ARLOCK_converter = new xsc::common::scalar2vectorN_converter<2>("M_AXI_GP0_ARLOCK_converter");
    mp_M_AXI_GP0_ARLOCK_converter->scalar_in(m_M_AXI_GP0_ARLOCK_converter_signal);
    mp_M_AXI_GP0_ARLOCK_converter->vector_out(M_AXI_GP0_ARLOCK);
    mp_M_AXI_GP0_transactor->ARLOCK(m_M_AXI_GP0_ARLOCK_converter_signal);
    mp_M_AXI_GP0_transactor->ARSIZE(M_AXI_GP0_ARSIZE);
    mp_M_AXI_GP0_transactor->AWBURST(M_AXI_GP0_AWBURST);
    mp_M_AXI_GP0_AWLOCK_converter = new xsc::common::scalar2vectorN_converter<2>("M_AXI_GP0_AWLOCK_converter");
    mp_M_AXI_GP0_AWLOCK_converter->scalar_in(m_M_AXI_GP0_AWLOCK_converter_signal);
    mp_M_AXI_GP0_AWLOCK_converter->vector_out(M_AXI_GP0_AWLOCK);
    mp_M_AXI_GP0_transactor->AWLOCK(m_M_AXI_GP0_AWLOCK_converter_signal);
    mp_M_AXI_GP0_transactor->AWSIZE(M_AXI_GP0_AWSIZE);
    mp_M_AXI_GP0_transactor->ARPROT(M_AXI_GP0_ARPROT);
    mp_M_AXI_GP0_transactor->AWPROT(M_AXI_GP0_AWPROT);
    mp_M_AXI_GP0_transactor->ARADDR(M_AXI_GP0_ARADDR);
    mp_M_AXI_GP0_transactor->AWADDR(M_AXI_GP0_AWADDR);
    mp_M_AXI_GP0_transactor->WDATA(M_AXI_GP0_WDATA);
    mp_M_AXI_GP0_transactor->ARCACHE(M_AXI_GP0_ARCACHE);
    mp_M_AXI_GP0_ARLEN_converter = new xsc::common::vector2vector_converter<8,4>("M_AXI_GP0_ARLEN_converter");
    mp_M_AXI_GP0_ARLEN_converter->vector_in(m_M_AXI_GP0_ARLEN_converter_signal);
    mp_M_AXI_GP0_ARLEN_converter->vector_out(M_AXI_GP0_ARLEN);
    mp_M_AXI_GP0_transactor->ARLEN(m_M_AXI_GP0_ARLEN_converter_signal);
    mp_M_AXI_GP0_transactor->ARQOS(M_AXI_GP0_ARQOS);
    mp_M_AXI_GP0_transactor->AWCACHE(M_AXI_GP0_AWCACHE);
    mp_M_AXI_GP0_AWLEN_converter = new xsc::common::vector2vector_converter<8,4>("M_AXI_GP0_AWLEN_converter");
    mp_M_AXI_GP0_AWLEN_converter->vector_in(m_M_AXI_GP0_AWLEN_converter_signal);
    mp_M_AXI_GP0_AWLEN_converter->vector_out(M_AXI_GP0_AWLEN);
    mp_M_AXI_GP0_transactor->AWLEN(m_M_AXI_GP0_AWLEN_converter_signal);
    mp_M_AXI_GP0_transactor->AWQOS(M_AXI_GP0_AWQOS);
    mp_M_AXI_GP0_transactor->WSTRB(M_AXI_GP0_WSTRB);
    mp_M_AXI_GP0_transactor->ARREADY(M_AXI_GP0_ARREADY);
    mp_M_AXI_GP0_transactor->AWREADY(M_AXI_GP0_AWREADY);
    mp_M_AXI_GP0_transactor->BVALID(M_AXI_GP0_BVALID);
    mp_M_AXI_GP0_transactor->RLAST(M_AXI_GP0_RLAST);
    mp_M_AXI_GP0_transactor->RVALID(M_AXI_GP0_RVALID);
    mp_M_AXI_GP0_transactor->WREADY(M_AXI_GP0_WREADY);
    mp_M_AXI_GP0_transactor->BID(M_AXI_GP0_BID);
    mp_M_AXI_GP0_transactor->RID(M_AXI_GP0_RID);
    mp_M_AXI_GP0_transactor->BRESP(M_AXI_GP0_BRESP);
    mp_M_AXI_GP0_transactor->RRESP(M_AXI_GP0_RRESP);
    mp_M_AXI_GP0_transactor->RDATA(M_AXI_GP0_RDATA);
    mp_M_AXI_GP0_transactor->CLK(M_AXI_GP0_ACLK);
    m_M_AXI_GP0_transactor_rst_signal.write(1);
    mp_M_AXI_GP0_transactor->RST(m_M_AXI_GP0_transactor_rst_signal);

    // M_AXI_GP0' transactor sockets

    mp_impl->M_AXI_GP0_rd_socket->bind(*(mp_M_AXI_GP0_transactor->rd_socket));
    mp_impl->M_AXI_GP0_wr_socket->bind(*(mp_M_AXI_GP0_transactor->wr_socket));
  }
  else
  {
  }

  // configure 'M_AXI_GP1' transactor

  if (xsc::utils::xsc_sim_manager::getInstanceParameterInt("system_ps_0_0", "M_AXI_GP1_TLM_MODE") != 1)
  {
    // Instantiate Socket Stubs

  // 'M_AXI_GP1' transactor parameters
    xsc::common_cpp::properties M_AXI_GP1_transactor_param_props;
    M_AXI_GP1_transactor_param_props.addLong("NUM_WRITE_OUTSTANDING", "8");
    M_AXI_GP1_transactor_param_props.addLong("NUM_READ_OUTSTANDING", "8");
    M_AXI_GP1_transactor_param_props.addLong("SUPPORTS_NARROW_BURST", "0");
    M_AXI_GP1_transactor_param_props.addLong("DATA_WIDTH", "32");
    M_AXI_GP1_transactor_param_props.addLong("FREQ_HZ", "122880000");
    M_AXI_GP1_transactor_param_props.addLong("ID_WIDTH", "12");
    M_AXI_GP1_transactor_param_props.addLong("ADDR_WIDTH", "32");
    M_AXI_GP1_transactor_param_props.addLong("AWUSER_WIDTH", "0");
    M_AXI_GP1_transactor_param_props.addLong("ARUSER_WIDTH", "0");
    M_AXI_GP1_transactor_param_props.addLong("WUSER_WIDTH", "0");
    M_AXI_GP1_transactor_param_props.addLong("RUSER_WIDTH", "0");
    M_AXI_GP1_transactor_param_props.addLong("BUSER_WIDTH", "0");
    M_AXI_GP1_transactor_param_props.addLong("HAS_BURST", "1");
    M_AXI_GP1_transactor_param_props.addLong("HAS_LOCK", "1");
    M_AXI_GP1_transactor_param_props.addLong("HAS_PROT", "1");
    M_AXI_GP1_transactor_param_props.addLong("HAS_CACHE", "1");
    M_AXI_GP1_transactor_param_props.addLong("HAS_QOS", "1");
    M_AXI_GP1_transactor_param_props.addLong("HAS_REGION", "0");
    M_AXI_GP1_transactor_param_props.addLong("HAS_WSTRB", "1");
    M_AXI_GP1_transactor_param_props.addLong("HAS_BRESP", "1");
    M_AXI_GP1_transactor_param_props.addLong("HAS_RRESP", "1");
    M_AXI_GP1_transactor_param_props.addLong("MAX_BURST_LENGTH", "16");
    M_AXI_GP1_transactor_param_props.addLong("NUM_READ_THREADS", "4");
    M_AXI_GP1_transactor_param_props.addLong("NUM_WRITE_THREADS", "4");
    M_AXI_GP1_transactor_param_props.addLong("RUSER_BITS_PER_BYTE", "0");
    M_AXI_GP1_transactor_param_props.addLong("WUSER_BITS_PER_BYTE", "0");
    M_AXI_GP1_transactor_param_props.addLong("HAS_SIZE", "1");
    M_AXI_GP1_transactor_param_props.addLong("HAS_RESET", "0");
    M_AXI_GP1_transactor_param_props.addFloat("PHASE", "0.0");
    M_AXI_GP1_transactor_param_props.addString("PROTOCOL", "AXI3");
    M_AXI_GP1_transactor_param_props.addString("READ_WRITE_MODE", "READ_WRITE");
    M_AXI_GP1_transactor_param_props.addString("CLK_DOMAIN", "/pll_0_clk_out1");

    mp_M_AXI_GP1_transactor = new xtlm::xaximm_xtlm2pin_t<32,32,12,1,1,1,1,1>("M_AXI_GP1_transactor", M_AXI_GP1_transactor_param_props);

    // M_AXI_GP1' transactor ports

    mp_M_AXI_GP1_transactor->ARVALID(M_AXI_GP1_ARVALID);
    mp_M_AXI_GP1_transactor->AWVALID(M_AXI_GP1_AWVALID);
    mp_M_AXI_GP1_transactor->BREADY(M_AXI_GP1_BREADY);
    mp_M_AXI_GP1_transactor->RREADY(M_AXI_GP1_RREADY);
    mp_M_AXI_GP1_transactor->WLAST(M_AXI_GP1_WLAST);
    mp_M_AXI_GP1_transactor->WVALID(M_AXI_GP1_WVALID);
    mp_M_AXI_GP1_transactor->ARID(M_AXI_GP1_ARID);
    mp_M_AXI_GP1_transactor->AWID(M_AXI_GP1_AWID);
    mp_M_AXI_GP1_transactor->ARBURST(M_AXI_GP1_ARBURST);
    mp_M_AXI_GP1_ARLOCK_converter = new xsc::common::scalar2vectorN_converter<2>("M_AXI_GP1_ARLOCK_converter");
    mp_M_AXI_GP1_ARLOCK_converter->scalar_in(m_M_AXI_GP1_ARLOCK_converter_signal);
    mp_M_AXI_GP1_ARLOCK_converter->vector_out(M_AXI_GP1_ARLOCK);
    mp_M_AXI_GP1_transactor->ARLOCK(m_M_AXI_GP1_ARLOCK_converter_signal);
    mp_M_AXI_GP1_transactor->ARSIZE(M_AXI_GP1_ARSIZE);
    mp_M_AXI_GP1_transactor->AWBURST(M_AXI_GP1_AWBURST);
    mp_M_AXI_GP1_AWLOCK_converter = new xsc::common::scalar2vectorN_converter<2>("M_AXI_GP1_AWLOCK_converter");
    mp_M_AXI_GP1_AWLOCK_converter->scalar_in(m_M_AXI_GP1_AWLOCK_converter_signal);
    mp_M_AXI_GP1_AWLOCK_converter->vector_out(M_AXI_GP1_AWLOCK);
    mp_M_AXI_GP1_transactor->AWLOCK(m_M_AXI_GP1_AWLOCK_converter_signal);
    mp_M_AXI_GP1_transactor->AWSIZE(M_AXI_GP1_AWSIZE);
    mp_M_AXI_GP1_transactor->ARPROT(M_AXI_GP1_ARPROT);
    mp_M_AXI_GP1_transactor->AWPROT(M_AXI_GP1_AWPROT);
    mp_M_AXI_GP1_transactor->ARADDR(M_AXI_GP1_ARADDR);
    mp_M_AXI_GP1_transactor->AWADDR(M_AXI_GP1_AWADDR);
    mp_M_AXI_GP1_transactor->WDATA(M_AXI_GP1_WDATA);
    mp_M_AXI_GP1_transactor->ARCACHE(M_AXI_GP1_ARCACHE);
    mp_M_AXI_GP1_ARLEN_converter = new xsc::common::vector2vector_converter<8,4>("M_AXI_GP1_ARLEN_converter");
    mp_M_AXI_GP1_ARLEN_converter->vector_in(m_M_AXI_GP1_ARLEN_converter_signal);
    mp_M_AXI_GP1_ARLEN_converter->vector_out(M_AXI_GP1_ARLEN);
    mp_M_AXI_GP1_transactor->ARLEN(m_M_AXI_GP1_ARLEN_converter_signal);
    mp_M_AXI_GP1_transactor->ARQOS(M_AXI_GP1_ARQOS);
    mp_M_AXI_GP1_transactor->AWCACHE(M_AXI_GP1_AWCACHE);
    mp_M_AXI_GP1_AWLEN_converter = new xsc::common::vector2vector_converter<8,4>("M_AXI_GP1_AWLEN_converter");
    mp_M_AXI_GP1_AWLEN_converter->vector_in(m_M_AXI_GP1_AWLEN_converter_signal);
    mp_M_AXI_GP1_AWLEN_converter->vector_out(M_AXI_GP1_AWLEN);
    mp_M_AXI_GP1_transactor->AWLEN(m_M_AXI_GP1_AWLEN_converter_signal);
    mp_M_AXI_GP1_transactor->AWQOS(M_AXI_GP1_AWQOS);
    mp_M_AXI_GP1_transactor->WSTRB(M_AXI_GP1_WSTRB);
    mp_M_AXI_GP1_transactor->ARREADY(M_AXI_GP1_ARREADY);
    mp_M_AXI_GP1_transactor->AWREADY(M_AXI_GP1_AWREADY);
    mp_M_AXI_GP1_transactor->BVALID(M_AXI_GP1_BVALID);
    mp_M_AXI_GP1_transactor->RLAST(M_AXI_GP1_RLAST);
    mp_M_AXI_GP1_transactor->RVALID(M_AXI_GP1_RVALID);
    mp_M_AXI_GP1_transactor->WREADY(M_AXI_GP1_WREADY);
    mp_M_AXI_GP1_transactor->BID(M_AXI_GP1_BID);
    mp_M_AXI_GP1_transactor->RID(M_AXI_GP1_RID);
    mp_M_AXI_GP1_transactor->BRESP(M_AXI_GP1_BRESP);
    mp_M_AXI_GP1_transactor->RRESP(M_AXI_GP1_RRESP);
    mp_M_AXI_GP1_transactor->RDATA(M_AXI_GP1_RDATA);
    mp_M_AXI_GP1_transactor->CLK(M_AXI_GP1_ACLK);
    m_M_AXI_GP1_transactor_rst_signal.write(1);
    mp_M_AXI_GP1_transactor->RST(m_M_AXI_GP1_transactor_rst_signal);

    // M_AXI_GP1' transactor sockets

    mp_impl->M_AXI_GP1_rd_socket->bind(*(mp_M_AXI_GP1_transactor->rd_socket));
    mp_impl->M_AXI_GP1_wr_socket->bind(*(mp_M_AXI_GP1_transactor->wr_socket));
  }
  else
  {
  }

}

#endif // RIVIERA




#ifdef VCSSYSTEMC
system_ps_0_0::system_ps_0_0(const sc_core::sc_module_name& nm) : system_ps_0_0_sc(nm),  GPIO_I("GPIO_I"), GPIO_O("GPIO_O"), GPIO_T("GPIO_T"), I2C0_SDA_I("I2C0_SDA_I"), I2C0_SDA_O("I2C0_SDA_O"), I2C0_SDA_T("I2C0_SDA_T"), I2C0_SCL_I("I2C0_SCL_I"), I2C0_SCL_O("I2C0_SCL_O"), I2C0_SCL_T("I2C0_SCL_T"), USB0_PORT_INDCTL("USB0_PORT_INDCTL"), USB0_VBUS_PWRSELECT("USB0_VBUS_PWRSELECT"), USB0_VBUS_PWRFAULT("USB0_VBUS_PWRFAULT"), M_AXI_GP0_ARVALID("M_AXI_GP0_ARVALID"), M_AXI_GP0_AWVALID("M_AXI_GP0_AWVALID"), M_AXI_GP0_BREADY("M_AXI_GP0_BREADY"), M_AXI_GP0_RREADY("M_AXI_GP0_RREADY"), M_AXI_GP0_WLAST("M_AXI_GP0_WLAST"), M_AXI_GP0_WVALID("M_AXI_GP0_WVALID"), M_AXI_GP0_ARID("M_AXI_GP0_ARID"), M_AXI_GP0_AWID("M_AXI_GP0_AWID"), M_AXI_GP0_WID("M_AXI_GP0_WID"), M_AXI_GP0_ARBURST("M_AXI_GP0_ARBURST"), M_AXI_GP0_ARLOCK("M_AXI_GP0_ARLOCK"), M_AXI_GP0_ARSIZE("M_AXI_GP0_ARSIZE"), M_AXI_GP0_AWBURST("M_AXI_GP0_AWBURST"), M_AXI_GP0_AWLOCK("M_AXI_GP0_AWLOCK"), M_AXI_GP0_AWSIZE("M_AXI_GP0_AWSIZE"), M_AXI_GP0_ARPROT("M_AXI_GP0_ARPROT"), M_AXI_GP0_AWPROT("M_AXI_GP0_AWPROT"), M_AXI_GP0_ARADDR("M_AXI_GP0_ARADDR"), M_AXI_GP0_AWADDR("M_AXI_GP0_AWADDR"), M_AXI_GP0_WDATA("M_AXI_GP0_WDATA"), M_AXI_GP0_ARCACHE("M_AXI_GP0_ARCACHE"), M_AXI_GP0_ARLEN("M_AXI_GP0_ARLEN"), M_AXI_GP0_ARQOS("M_AXI_GP0_ARQOS"), M_AXI_GP0_AWCACHE("M_AXI_GP0_AWCACHE"), M_AXI_GP0_AWLEN("M_AXI_GP0_AWLEN"), M_AXI_GP0_AWQOS("M_AXI_GP0_AWQOS"), M_AXI_GP0_WSTRB("M_AXI_GP0_WSTRB"), M_AXI_GP0_ACLK("M_AXI_GP0_ACLK"), M_AXI_GP0_ARREADY("M_AXI_GP0_ARREADY"), M_AXI_GP0_AWREADY("M_AXI_GP0_AWREADY"), M_AXI_GP0_BVALID("M_AXI_GP0_BVALID"), M_AXI_GP0_RLAST("M_AXI_GP0_RLAST"), M_AXI_GP0_RVALID("M_AXI_GP0_RVALID"), M_AXI_GP0_WREADY("M_AXI_GP0_WREADY"), M_AXI_GP0_BID("M_AXI_GP0_BID"), M_AXI_GP0_RID("M_AXI_GP0_RID"), M_AXI_GP0_BRESP("M_AXI_GP0_BRESP"), M_AXI_GP0_RRESP("M_AXI_GP0_RRESP"), M_AXI_GP0_RDATA("M_AXI_GP0_RDATA"), M_AXI_GP1_ARVALID("M_AXI_GP1_ARVALID"), M_AXI_GP1_AWVALID("M_AXI_GP1_AWVALID"), M_AXI_GP1_BREADY("M_AXI_GP1_BREADY"), M_AXI_GP1_RREADY("M_AXI_GP1_RREADY"), M_AXI_GP1_WLAST("M_AXI_GP1_WLAST"), M_AXI_GP1_WVALID("M_AXI_GP1_WVALID"), M_AXI_GP1_ARID("M_AXI_GP1_ARID"), M_AXI_GP1_AWID("M_AXI_GP1_AWID"), M_AXI_GP1_WID("M_AXI_GP1_WID"), M_AXI_GP1_ARBURST("M_AXI_GP1_ARBURST"), M_AXI_GP1_ARLOCK("M_AXI_GP1_ARLOCK"), M_AXI_GP1_ARSIZE("M_AXI_GP1_ARSIZE"), M_AXI_GP1_AWBURST("M_AXI_GP1_AWBURST"), M_AXI_GP1_AWLOCK("M_AXI_GP1_AWLOCK"), M_AXI_GP1_AWSIZE("M_AXI_GP1_AWSIZE"), M_AXI_GP1_ARPROT("M_AXI_GP1_ARPROT"), M_AXI_GP1_AWPROT("M_AXI_GP1_AWPROT"), M_AXI_GP1_ARADDR("M_AXI_GP1_ARADDR"), M_AXI_GP1_AWADDR("M_AXI_GP1_AWADDR"), M_AXI_GP1_WDATA("M_AXI_GP1_WDATA"), M_AXI_GP1_ARCACHE("M_AXI_GP1_ARCACHE"), M_AXI_GP1_ARLEN("M_AXI_GP1_ARLEN"), M_AXI_GP1_ARQOS("M_AXI_GP1_ARQOS"), M_AXI_GP1_AWCACHE("M_AXI_GP1_AWCACHE"), M_AXI_GP1_AWLEN("M_AXI_GP1_AWLEN"), M_AXI_GP1_AWQOS("M_AXI_GP1_AWQOS"), M_AXI_GP1_WSTRB("M_AXI_GP1_WSTRB"), M_AXI_GP1_ACLK("M_AXI_GP1_ACLK"), M_AXI_GP1_ARREADY("M_AXI_GP1_ARREADY"), M_AXI_GP1_AWREADY("M_AXI_GP1_AWREADY"), M_AXI_GP1_BVALID("M_AXI_GP1_BVALID"), M_AXI_GP1_RLAST("M_AXI_GP1_RLAST"), M_AXI_GP1_RVALID("M_AXI_GP1_RVALID"), M_AXI_GP1_WREADY("M_AXI_GP1_WREADY"), M_AXI_GP1_BID("M_AXI_GP1_BID"), M_AXI_GP1_RID("M_AXI_GP1_RID"), M_AXI_GP1_BRESP("M_AXI_GP1_BRESP"), M_AXI_GP1_RRESP("M_AXI_GP1_RRESP"), M_AXI_GP1_RDATA("M_AXI_GP1_RDATA"), FCLK_CLK0("FCLK_CLK0"), FCLK_RESET0_N("FCLK_RESET0_N"), MIO("MIO"), DDR_CAS_n("DDR_CAS_n"), DDR_CKE("DDR_CKE"), DDR_Clk_n("DDR_Clk_n"), DDR_Clk("DDR_Clk"), DDR_CS_n("DDR_CS_n"), DDR_DRSTB("DDR_DRSTB"), DDR_ODT("DDR_ODT"), DDR_RAS_n("DDR_RAS_n"), DDR_WEB("DDR_WEB"), DDR_BankAddr("DDR_BankAddr"), DDR_Addr("DDR_Addr"), DDR_VRN("DDR_VRN"), DDR_VRP("DDR_VRP"), DDR_DM("DDR_DM"), DDR_DQ("DDR_DQ"), DDR_DQS_n("DDR_DQS_n"), DDR_DQS("DDR_DQS"), PS_SRSTB("PS_SRSTB"), PS_CLK("PS_CLK"), PS_PORB("PS_PORB")
{
  // initialize pins
  mp_impl->GPIO_I(GPIO_I);
  mp_impl->GPIO_O(GPIO_O);
  mp_impl->GPIO_T(GPIO_T);
  mp_impl->I2C0_SDA_I(I2C0_SDA_I);
  mp_impl->I2C0_SDA_O(I2C0_SDA_O);
  mp_impl->I2C0_SDA_T(I2C0_SDA_T);
  mp_impl->I2C0_SCL_I(I2C0_SCL_I);
  mp_impl->I2C0_SCL_O(I2C0_SCL_O);
  mp_impl->I2C0_SCL_T(I2C0_SCL_T);
  mp_impl->USB0_PORT_INDCTL(USB0_PORT_INDCTL);
  mp_impl->USB0_VBUS_PWRSELECT(USB0_VBUS_PWRSELECT);
  mp_impl->USB0_VBUS_PWRFAULT(USB0_VBUS_PWRFAULT);
  mp_impl->M_AXI_GP0_ACLK(M_AXI_GP0_ACLK);
  mp_impl->M_AXI_GP1_ACLK(M_AXI_GP1_ACLK);
  mp_impl->FCLK_CLK0(FCLK_CLK0);
  mp_impl->FCLK_RESET0_N(FCLK_RESET0_N);
  mp_impl->MIO(MIO);
  mp_impl->DDR_CAS_n(DDR_CAS_n);
  mp_impl->DDR_CKE(DDR_CKE);
  mp_impl->DDR_Clk_n(DDR_Clk_n);
  mp_impl->DDR_Clk(DDR_Clk);
  mp_impl->DDR_CS_n(DDR_CS_n);
  mp_impl->DDR_DRSTB(DDR_DRSTB);
  mp_impl->DDR_ODT(DDR_ODT);
  mp_impl->DDR_RAS_n(DDR_RAS_n);
  mp_impl->DDR_WEB(DDR_WEB);
  mp_impl->DDR_BankAddr(DDR_BankAddr);
  mp_impl->DDR_Addr(DDR_Addr);
  mp_impl->DDR_VRN(DDR_VRN);
  mp_impl->DDR_VRP(DDR_VRP);
  mp_impl->DDR_DM(DDR_DM);
  mp_impl->DDR_DQ(DDR_DQ);
  mp_impl->DDR_DQS_n(DDR_DQS_n);
  mp_impl->DDR_DQS(DDR_DQS);
  mp_impl->PS_SRSTB(PS_SRSTB);
  mp_impl->PS_CLK(PS_CLK);
  mp_impl->PS_PORB(PS_PORB);

  // initialize transactors
  mp_M_AXI_GP0_transactor = NULL;
  mp_M_AXI_GP0_ARLOCK_converter = NULL;
  mp_M_AXI_GP0_AWLOCK_converter = NULL;
  mp_M_AXI_GP0_ARLEN_converter = NULL;
  mp_M_AXI_GP0_AWLEN_converter = NULL;
  mp_M_AXI_GP1_transactor = NULL;
  mp_M_AXI_GP1_ARLOCK_converter = NULL;
  mp_M_AXI_GP1_AWLOCK_converter = NULL;
  mp_M_AXI_GP1_ARLEN_converter = NULL;
  mp_M_AXI_GP1_AWLEN_converter = NULL;

  // Instantiate Socket Stubs

  // configure M_AXI_GP0_transactor
    xsc::common_cpp::properties M_AXI_GP0_transactor_param_props;
    M_AXI_GP0_transactor_param_props.addLong("SUPPORTS_NARROW_BURST", "0");
    M_AXI_GP0_transactor_param_props.addLong("NUM_WRITE_OUTSTANDING", "8");
    M_AXI_GP0_transactor_param_props.addLong("NUM_READ_OUTSTANDING", "8");
    M_AXI_GP0_transactor_param_props.addLong("DATA_WIDTH", "32");
    M_AXI_GP0_transactor_param_props.addLong("FREQ_HZ", "122880000");
    M_AXI_GP0_transactor_param_props.addLong("ID_WIDTH", "12");
    M_AXI_GP0_transactor_param_props.addLong("ADDR_WIDTH", "32");
    M_AXI_GP0_transactor_param_props.addLong("AWUSER_WIDTH", "0");
    M_AXI_GP0_transactor_param_props.addLong("ARUSER_WIDTH", "0");
    M_AXI_GP0_transactor_param_props.addLong("WUSER_WIDTH", "0");
    M_AXI_GP0_transactor_param_props.addLong("RUSER_WIDTH", "0");
    M_AXI_GP0_transactor_param_props.addLong("BUSER_WIDTH", "0");
    M_AXI_GP0_transactor_param_props.addLong("HAS_BURST", "1");
    M_AXI_GP0_transactor_param_props.addLong("HAS_LOCK", "1");
    M_AXI_GP0_transactor_param_props.addLong("HAS_PROT", "1");
    M_AXI_GP0_transactor_param_props.addLong("HAS_CACHE", "1");
    M_AXI_GP0_transactor_param_props.addLong("HAS_QOS", "1");
    M_AXI_GP0_transactor_param_props.addLong("HAS_REGION", "0");
    M_AXI_GP0_transactor_param_props.addLong("HAS_WSTRB", "1");
    M_AXI_GP0_transactor_param_props.addLong("HAS_BRESP", "1");
    M_AXI_GP0_transactor_param_props.addLong("HAS_RRESP", "1");
    M_AXI_GP0_transactor_param_props.addLong("MAX_BURST_LENGTH", "16");
    M_AXI_GP0_transactor_param_props.addLong("NUM_READ_THREADS", "4");
    M_AXI_GP0_transactor_param_props.addLong("NUM_WRITE_THREADS", "4");
    M_AXI_GP0_transactor_param_props.addLong("RUSER_BITS_PER_BYTE", "0");
    M_AXI_GP0_transactor_param_props.addLong("WUSER_BITS_PER_BYTE", "0");
    M_AXI_GP0_transactor_param_props.addLong("HAS_SIZE", "1");
    M_AXI_GP0_transactor_param_props.addLong("HAS_RESET", "0");
    M_AXI_GP0_transactor_param_props.addFloat("PHASE", "0.0");
    M_AXI_GP0_transactor_param_props.addString("PROTOCOL", "AXI3");
    M_AXI_GP0_transactor_param_props.addString("READ_WRITE_MODE", "READ_WRITE");
    M_AXI_GP0_transactor_param_props.addString("CLK_DOMAIN", "/pll_0_clk_out1");

    mp_M_AXI_GP0_transactor = new xtlm::xaximm_xtlm2pin_t<32,32,12,1,1,1,1,1>("M_AXI_GP0_transactor", M_AXI_GP0_transactor_param_props);
  mp_M_AXI_GP0_transactor->ARVALID(M_AXI_GP0_ARVALID);
  mp_M_AXI_GP0_transactor->AWVALID(M_AXI_GP0_AWVALID);
  mp_M_AXI_GP0_transactor->BREADY(M_AXI_GP0_BREADY);
  mp_M_AXI_GP0_transactor->RREADY(M_AXI_GP0_RREADY);
  mp_M_AXI_GP0_transactor->WLAST(M_AXI_GP0_WLAST);
  mp_M_AXI_GP0_transactor->WVALID(M_AXI_GP0_WVALID);
  mp_M_AXI_GP0_transactor->ARID(M_AXI_GP0_ARID);
  mp_M_AXI_GP0_transactor->AWID(M_AXI_GP0_AWID);
  mp_M_AXI_GP0_transactor->ARBURST(M_AXI_GP0_ARBURST);
  mp_M_AXI_GP0_ARLOCK_converter = new xsc::common::scalar2vectorN_converter<2>("M_AXI_GP0_ARLOCK_converter");
  mp_M_AXI_GP0_ARLOCK_converter->scalar_in(m_M_AXI_GP0_ARLOCK_converter_signal);
  mp_M_AXI_GP0_ARLOCK_converter->vector_out(M_AXI_GP0_ARLOCK);
  mp_M_AXI_GP0_transactor->ARLOCK(m_M_AXI_GP0_ARLOCK_converter_signal);
  mp_M_AXI_GP0_transactor->ARSIZE(M_AXI_GP0_ARSIZE);
  mp_M_AXI_GP0_transactor->AWBURST(M_AXI_GP0_AWBURST);
  mp_M_AXI_GP0_AWLOCK_converter = new xsc::common::scalar2vectorN_converter<2>("M_AXI_GP0_AWLOCK_converter");
  mp_M_AXI_GP0_AWLOCK_converter->scalar_in(m_M_AXI_GP0_AWLOCK_converter_signal);
  mp_M_AXI_GP0_AWLOCK_converter->vector_out(M_AXI_GP0_AWLOCK);
  mp_M_AXI_GP0_transactor->AWLOCK(m_M_AXI_GP0_AWLOCK_converter_signal);
  mp_M_AXI_GP0_transactor->AWSIZE(M_AXI_GP0_AWSIZE);
  mp_M_AXI_GP0_transactor->ARPROT(M_AXI_GP0_ARPROT);
  mp_M_AXI_GP0_transactor->AWPROT(M_AXI_GP0_AWPROT);
  mp_M_AXI_GP0_transactor->ARADDR(M_AXI_GP0_ARADDR);
  mp_M_AXI_GP0_transactor->AWADDR(M_AXI_GP0_AWADDR);
  mp_M_AXI_GP0_transactor->WDATA(M_AXI_GP0_WDATA);
  mp_M_AXI_GP0_transactor->ARCACHE(M_AXI_GP0_ARCACHE);
  mp_M_AXI_GP0_ARLEN_converter = new xsc::common::vector2vector_converter<8,4>("M_AXI_GP0_ARLEN_converter");
  mp_M_AXI_GP0_ARLEN_converter->vector_in(m_M_AXI_GP0_ARLEN_converter_signal);
  mp_M_AXI_GP0_ARLEN_converter->vector_out(M_AXI_GP0_ARLEN);
  mp_M_AXI_GP0_transactor->ARLEN(m_M_AXI_GP0_ARLEN_converter_signal);
  mp_M_AXI_GP0_transactor->ARQOS(M_AXI_GP0_ARQOS);
  mp_M_AXI_GP0_transactor->AWCACHE(M_AXI_GP0_AWCACHE);
  mp_M_AXI_GP0_AWLEN_converter = new xsc::common::vector2vector_converter<8,4>("M_AXI_GP0_AWLEN_converter");
  mp_M_AXI_GP0_AWLEN_converter->vector_in(m_M_AXI_GP0_AWLEN_converter_signal);
  mp_M_AXI_GP0_AWLEN_converter->vector_out(M_AXI_GP0_AWLEN);
  mp_M_AXI_GP0_transactor->AWLEN(m_M_AXI_GP0_AWLEN_converter_signal);
  mp_M_AXI_GP0_transactor->AWQOS(M_AXI_GP0_AWQOS);
  mp_M_AXI_GP0_transactor->WSTRB(M_AXI_GP0_WSTRB);
  mp_M_AXI_GP0_transactor->ARREADY(M_AXI_GP0_ARREADY);
  mp_M_AXI_GP0_transactor->AWREADY(M_AXI_GP0_AWREADY);
  mp_M_AXI_GP0_transactor->BVALID(M_AXI_GP0_BVALID);
  mp_M_AXI_GP0_transactor->RLAST(M_AXI_GP0_RLAST);
  mp_M_AXI_GP0_transactor->RVALID(M_AXI_GP0_RVALID);
  mp_M_AXI_GP0_transactor->WREADY(M_AXI_GP0_WREADY);
  mp_M_AXI_GP0_transactor->BID(M_AXI_GP0_BID);
  mp_M_AXI_GP0_transactor->RID(M_AXI_GP0_RID);
  mp_M_AXI_GP0_transactor->BRESP(M_AXI_GP0_BRESP);
  mp_M_AXI_GP0_transactor->RRESP(M_AXI_GP0_RRESP);
  mp_M_AXI_GP0_transactor->RDATA(M_AXI_GP0_RDATA);
  mp_M_AXI_GP0_transactor->CLK(M_AXI_GP0_ACLK);
  m_M_AXI_GP0_transactor_rst_signal.write(1);
  mp_M_AXI_GP0_transactor->RST(m_M_AXI_GP0_transactor_rst_signal);
  // configure M_AXI_GP1_transactor
    xsc::common_cpp::properties M_AXI_GP1_transactor_param_props;
    M_AXI_GP1_transactor_param_props.addLong("NUM_WRITE_OUTSTANDING", "8");
    M_AXI_GP1_transactor_param_props.addLong("NUM_READ_OUTSTANDING", "8");
    M_AXI_GP1_transactor_param_props.addLong("SUPPORTS_NARROW_BURST", "0");
    M_AXI_GP1_transactor_param_props.addLong("DATA_WIDTH", "32");
    M_AXI_GP1_transactor_param_props.addLong("FREQ_HZ", "122880000");
    M_AXI_GP1_transactor_param_props.addLong("ID_WIDTH", "12");
    M_AXI_GP1_transactor_param_props.addLong("ADDR_WIDTH", "32");
    M_AXI_GP1_transactor_param_props.addLong("AWUSER_WIDTH", "0");
    M_AXI_GP1_transactor_param_props.addLong("ARUSER_WIDTH", "0");
    M_AXI_GP1_transactor_param_props.addLong("WUSER_WIDTH", "0");
    M_AXI_GP1_transactor_param_props.addLong("RUSER_WIDTH", "0");
    M_AXI_GP1_transactor_param_props.addLong("BUSER_WIDTH", "0");
    M_AXI_GP1_transactor_param_props.addLong("HAS_BURST", "1");
    M_AXI_GP1_transactor_param_props.addLong("HAS_LOCK", "1");
    M_AXI_GP1_transactor_param_props.addLong("HAS_PROT", "1");
    M_AXI_GP1_transactor_param_props.addLong("HAS_CACHE", "1");
    M_AXI_GP1_transactor_param_props.addLong("HAS_QOS", "1");
    M_AXI_GP1_transactor_param_props.addLong("HAS_REGION", "0");
    M_AXI_GP1_transactor_param_props.addLong("HAS_WSTRB", "1");
    M_AXI_GP1_transactor_param_props.addLong("HAS_BRESP", "1");
    M_AXI_GP1_transactor_param_props.addLong("HAS_RRESP", "1");
    M_AXI_GP1_transactor_param_props.addLong("MAX_BURST_LENGTH", "16");
    M_AXI_GP1_transactor_param_props.addLong("NUM_READ_THREADS", "4");
    M_AXI_GP1_transactor_param_props.addLong("NUM_WRITE_THREADS", "4");
    M_AXI_GP1_transactor_param_props.addLong("RUSER_BITS_PER_BYTE", "0");
    M_AXI_GP1_transactor_param_props.addLong("WUSER_BITS_PER_BYTE", "0");
    M_AXI_GP1_transactor_param_props.addLong("HAS_SIZE", "1");
    M_AXI_GP1_transactor_param_props.addLong("HAS_RESET", "0");
    M_AXI_GP1_transactor_param_props.addFloat("PHASE", "0.0");
    M_AXI_GP1_transactor_param_props.addString("PROTOCOL", "AXI3");
    M_AXI_GP1_transactor_param_props.addString("READ_WRITE_MODE", "READ_WRITE");
    M_AXI_GP1_transactor_param_props.addString("CLK_DOMAIN", "/pll_0_clk_out1");

    mp_M_AXI_GP1_transactor = new xtlm::xaximm_xtlm2pin_t<32,32,12,1,1,1,1,1>("M_AXI_GP1_transactor", M_AXI_GP1_transactor_param_props);
  mp_M_AXI_GP1_transactor->ARVALID(M_AXI_GP1_ARVALID);
  mp_M_AXI_GP1_transactor->AWVALID(M_AXI_GP1_AWVALID);
  mp_M_AXI_GP1_transactor->BREADY(M_AXI_GP1_BREADY);
  mp_M_AXI_GP1_transactor->RREADY(M_AXI_GP1_RREADY);
  mp_M_AXI_GP1_transactor->WLAST(M_AXI_GP1_WLAST);
  mp_M_AXI_GP1_transactor->WVALID(M_AXI_GP1_WVALID);
  mp_M_AXI_GP1_transactor->ARID(M_AXI_GP1_ARID);
  mp_M_AXI_GP1_transactor->AWID(M_AXI_GP1_AWID);
  mp_M_AXI_GP1_transactor->ARBURST(M_AXI_GP1_ARBURST);
  mp_M_AXI_GP1_ARLOCK_converter = new xsc::common::scalar2vectorN_converter<2>("M_AXI_GP1_ARLOCK_converter");
  mp_M_AXI_GP1_ARLOCK_converter->scalar_in(m_M_AXI_GP1_ARLOCK_converter_signal);
  mp_M_AXI_GP1_ARLOCK_converter->vector_out(M_AXI_GP1_ARLOCK);
  mp_M_AXI_GP1_transactor->ARLOCK(m_M_AXI_GP1_ARLOCK_converter_signal);
  mp_M_AXI_GP1_transactor->ARSIZE(M_AXI_GP1_ARSIZE);
  mp_M_AXI_GP1_transactor->AWBURST(M_AXI_GP1_AWBURST);
  mp_M_AXI_GP1_AWLOCK_converter = new xsc::common::scalar2vectorN_converter<2>("M_AXI_GP1_AWLOCK_converter");
  mp_M_AXI_GP1_AWLOCK_converter->scalar_in(m_M_AXI_GP1_AWLOCK_converter_signal);
  mp_M_AXI_GP1_AWLOCK_converter->vector_out(M_AXI_GP1_AWLOCK);
  mp_M_AXI_GP1_transactor->AWLOCK(m_M_AXI_GP1_AWLOCK_converter_signal);
  mp_M_AXI_GP1_transactor->AWSIZE(M_AXI_GP1_AWSIZE);
  mp_M_AXI_GP1_transactor->ARPROT(M_AXI_GP1_ARPROT);
  mp_M_AXI_GP1_transactor->AWPROT(M_AXI_GP1_AWPROT);
  mp_M_AXI_GP1_transactor->ARADDR(M_AXI_GP1_ARADDR);
  mp_M_AXI_GP1_transactor->AWADDR(M_AXI_GP1_AWADDR);
  mp_M_AXI_GP1_transactor->WDATA(M_AXI_GP1_WDATA);
  mp_M_AXI_GP1_transactor->ARCACHE(M_AXI_GP1_ARCACHE);
  mp_M_AXI_GP1_ARLEN_converter = new xsc::common::vector2vector_converter<8,4>("M_AXI_GP1_ARLEN_converter");
  mp_M_AXI_GP1_ARLEN_converter->vector_in(m_M_AXI_GP1_ARLEN_converter_signal);
  mp_M_AXI_GP1_ARLEN_converter->vector_out(M_AXI_GP1_ARLEN);
  mp_M_AXI_GP1_transactor->ARLEN(m_M_AXI_GP1_ARLEN_converter_signal);
  mp_M_AXI_GP1_transactor->ARQOS(M_AXI_GP1_ARQOS);
  mp_M_AXI_GP1_transactor->AWCACHE(M_AXI_GP1_AWCACHE);
  mp_M_AXI_GP1_AWLEN_converter = new xsc::common::vector2vector_converter<8,4>("M_AXI_GP1_AWLEN_converter");
  mp_M_AXI_GP1_AWLEN_converter->vector_in(m_M_AXI_GP1_AWLEN_converter_signal);
  mp_M_AXI_GP1_AWLEN_converter->vector_out(M_AXI_GP1_AWLEN);
  mp_M_AXI_GP1_transactor->AWLEN(m_M_AXI_GP1_AWLEN_converter_signal);
  mp_M_AXI_GP1_transactor->AWQOS(M_AXI_GP1_AWQOS);
  mp_M_AXI_GP1_transactor->WSTRB(M_AXI_GP1_WSTRB);
  mp_M_AXI_GP1_transactor->ARREADY(M_AXI_GP1_ARREADY);
  mp_M_AXI_GP1_transactor->AWREADY(M_AXI_GP1_AWREADY);
  mp_M_AXI_GP1_transactor->BVALID(M_AXI_GP1_BVALID);
  mp_M_AXI_GP1_transactor->RLAST(M_AXI_GP1_RLAST);
  mp_M_AXI_GP1_transactor->RVALID(M_AXI_GP1_RVALID);
  mp_M_AXI_GP1_transactor->WREADY(M_AXI_GP1_WREADY);
  mp_M_AXI_GP1_transactor->BID(M_AXI_GP1_BID);
  mp_M_AXI_GP1_transactor->RID(M_AXI_GP1_RID);
  mp_M_AXI_GP1_transactor->BRESP(M_AXI_GP1_BRESP);
  mp_M_AXI_GP1_transactor->RRESP(M_AXI_GP1_RRESP);
  mp_M_AXI_GP1_transactor->RDATA(M_AXI_GP1_RDATA);
  mp_M_AXI_GP1_transactor->CLK(M_AXI_GP1_ACLK);
  m_M_AXI_GP1_transactor_rst_signal.write(1);
  mp_M_AXI_GP1_transactor->RST(m_M_AXI_GP1_transactor_rst_signal);

  // initialize transactors stubs
  M_AXI_GP0_transactor_initiator_wr_socket_stub = nullptr;
  M_AXI_GP0_transactor_initiator_rd_socket_stub = nullptr;
  M_AXI_GP1_transactor_initiator_wr_socket_stub = nullptr;
  M_AXI_GP1_transactor_initiator_rd_socket_stub = nullptr;

}

void system_ps_0_0::before_end_of_elaboration()
{
  // configure 'M_AXI_GP0' transactor
  if (xsc::utils::xsc_sim_manager::getInstanceParameterInt("system_ps_0_0", "M_AXI_GP0_TLM_MODE") != 1)
  {
    mp_impl->M_AXI_GP0_rd_socket->bind(*(mp_M_AXI_GP0_transactor->rd_socket));
    mp_impl->M_AXI_GP0_wr_socket->bind(*(mp_M_AXI_GP0_transactor->wr_socket));
  
  }
  else
  {
    M_AXI_GP0_transactor_initiator_wr_socket_stub = new xtlm::xtlm_aximm_initiator_stub("wr_socket",0);
    M_AXI_GP0_transactor_initiator_wr_socket_stub->bind(*(mp_M_AXI_GP0_transactor->wr_socket));
    M_AXI_GP0_transactor_initiator_rd_socket_stub = new xtlm::xtlm_aximm_initiator_stub("rd_socket",0);
    M_AXI_GP0_transactor_initiator_rd_socket_stub->bind(*(mp_M_AXI_GP0_transactor->rd_socket));
    mp_M_AXI_GP0_transactor->disable_transactor();
  }

  // configure 'M_AXI_GP1' transactor
  if (xsc::utils::xsc_sim_manager::getInstanceParameterInt("system_ps_0_0", "M_AXI_GP1_TLM_MODE") != 1)
  {
    mp_impl->M_AXI_GP1_rd_socket->bind(*(mp_M_AXI_GP1_transactor->rd_socket));
    mp_impl->M_AXI_GP1_wr_socket->bind(*(mp_M_AXI_GP1_transactor->wr_socket));
  
  }
  else
  {
    M_AXI_GP1_transactor_initiator_wr_socket_stub = new xtlm::xtlm_aximm_initiator_stub("wr_socket",0);
    M_AXI_GP1_transactor_initiator_wr_socket_stub->bind(*(mp_M_AXI_GP1_transactor->wr_socket));
    M_AXI_GP1_transactor_initiator_rd_socket_stub = new xtlm::xtlm_aximm_initiator_stub("rd_socket",0);
    M_AXI_GP1_transactor_initiator_rd_socket_stub->bind(*(mp_M_AXI_GP1_transactor->rd_socket));
    mp_M_AXI_GP1_transactor->disable_transactor();
  }

}

#endif // VCSSYSTEMC




#ifdef MTI_SYSTEMC
system_ps_0_0::system_ps_0_0(const sc_core::sc_module_name& nm) : system_ps_0_0_sc(nm),  GPIO_I("GPIO_I"), GPIO_O("GPIO_O"), GPIO_T("GPIO_T"), I2C0_SDA_I("I2C0_SDA_I"), I2C0_SDA_O("I2C0_SDA_O"), I2C0_SDA_T("I2C0_SDA_T"), I2C0_SCL_I("I2C0_SCL_I"), I2C0_SCL_O("I2C0_SCL_O"), I2C0_SCL_T("I2C0_SCL_T"), USB0_PORT_INDCTL("USB0_PORT_INDCTL"), USB0_VBUS_PWRSELECT("USB0_VBUS_PWRSELECT"), USB0_VBUS_PWRFAULT("USB0_VBUS_PWRFAULT"), M_AXI_GP0_ARVALID("M_AXI_GP0_ARVALID"), M_AXI_GP0_AWVALID("M_AXI_GP0_AWVALID"), M_AXI_GP0_BREADY("M_AXI_GP0_BREADY"), M_AXI_GP0_RREADY("M_AXI_GP0_RREADY"), M_AXI_GP0_WLAST("M_AXI_GP0_WLAST"), M_AXI_GP0_WVALID("M_AXI_GP0_WVALID"), M_AXI_GP0_ARID("M_AXI_GP0_ARID"), M_AXI_GP0_AWID("M_AXI_GP0_AWID"), M_AXI_GP0_WID("M_AXI_GP0_WID"), M_AXI_GP0_ARBURST("M_AXI_GP0_ARBURST"), M_AXI_GP0_ARLOCK("M_AXI_GP0_ARLOCK"), M_AXI_GP0_ARSIZE("M_AXI_GP0_ARSIZE"), M_AXI_GP0_AWBURST("M_AXI_GP0_AWBURST"), M_AXI_GP0_AWLOCK("M_AXI_GP0_AWLOCK"), M_AXI_GP0_AWSIZE("M_AXI_GP0_AWSIZE"), M_AXI_GP0_ARPROT("M_AXI_GP0_ARPROT"), M_AXI_GP0_AWPROT("M_AXI_GP0_AWPROT"), M_AXI_GP0_ARADDR("M_AXI_GP0_ARADDR"), M_AXI_GP0_AWADDR("M_AXI_GP0_AWADDR"), M_AXI_GP0_WDATA("M_AXI_GP0_WDATA"), M_AXI_GP0_ARCACHE("M_AXI_GP0_ARCACHE"), M_AXI_GP0_ARLEN("M_AXI_GP0_ARLEN"), M_AXI_GP0_ARQOS("M_AXI_GP0_ARQOS"), M_AXI_GP0_AWCACHE("M_AXI_GP0_AWCACHE"), M_AXI_GP0_AWLEN("M_AXI_GP0_AWLEN"), M_AXI_GP0_AWQOS("M_AXI_GP0_AWQOS"), M_AXI_GP0_WSTRB("M_AXI_GP0_WSTRB"), M_AXI_GP0_ACLK("M_AXI_GP0_ACLK"), M_AXI_GP0_ARREADY("M_AXI_GP0_ARREADY"), M_AXI_GP0_AWREADY("M_AXI_GP0_AWREADY"), M_AXI_GP0_BVALID("M_AXI_GP0_BVALID"), M_AXI_GP0_RLAST("M_AXI_GP0_RLAST"), M_AXI_GP0_RVALID("M_AXI_GP0_RVALID"), M_AXI_GP0_WREADY("M_AXI_GP0_WREADY"), M_AXI_GP0_BID("M_AXI_GP0_BID"), M_AXI_GP0_RID("M_AXI_GP0_RID"), M_AXI_GP0_BRESP("M_AXI_GP0_BRESP"), M_AXI_GP0_RRESP("M_AXI_GP0_RRESP"), M_AXI_GP0_RDATA("M_AXI_GP0_RDATA"), M_AXI_GP1_ARVALID("M_AXI_GP1_ARVALID"), M_AXI_GP1_AWVALID("M_AXI_GP1_AWVALID"), M_AXI_GP1_BREADY("M_AXI_GP1_BREADY"), M_AXI_GP1_RREADY("M_AXI_GP1_RREADY"), M_AXI_GP1_WLAST("M_AXI_GP1_WLAST"), M_AXI_GP1_WVALID("M_AXI_GP1_WVALID"), M_AXI_GP1_ARID("M_AXI_GP1_ARID"), M_AXI_GP1_AWID("M_AXI_GP1_AWID"), M_AXI_GP1_WID("M_AXI_GP1_WID"), M_AXI_GP1_ARBURST("M_AXI_GP1_ARBURST"), M_AXI_GP1_ARLOCK("M_AXI_GP1_ARLOCK"), M_AXI_GP1_ARSIZE("M_AXI_GP1_ARSIZE"), M_AXI_GP1_AWBURST("M_AXI_GP1_AWBURST"), M_AXI_GP1_AWLOCK("M_AXI_GP1_AWLOCK"), M_AXI_GP1_AWSIZE("M_AXI_GP1_AWSIZE"), M_AXI_GP1_ARPROT("M_AXI_GP1_ARPROT"), M_AXI_GP1_AWPROT("M_AXI_GP1_AWPROT"), M_AXI_GP1_ARADDR("M_AXI_GP1_ARADDR"), M_AXI_GP1_AWADDR("M_AXI_GP1_AWADDR"), M_AXI_GP1_WDATA("M_AXI_GP1_WDATA"), M_AXI_GP1_ARCACHE("M_AXI_GP1_ARCACHE"), M_AXI_GP1_ARLEN("M_AXI_GP1_ARLEN"), M_AXI_GP1_ARQOS("M_AXI_GP1_ARQOS"), M_AXI_GP1_AWCACHE("M_AXI_GP1_AWCACHE"), M_AXI_GP1_AWLEN("M_AXI_GP1_AWLEN"), M_AXI_GP1_AWQOS("M_AXI_GP1_AWQOS"), M_AXI_GP1_WSTRB("M_AXI_GP1_WSTRB"), M_AXI_GP1_ACLK("M_AXI_GP1_ACLK"), M_AXI_GP1_ARREADY("M_AXI_GP1_ARREADY"), M_AXI_GP1_AWREADY("M_AXI_GP1_AWREADY"), M_AXI_GP1_BVALID("M_AXI_GP1_BVALID"), M_AXI_GP1_RLAST("M_AXI_GP1_RLAST"), M_AXI_GP1_RVALID("M_AXI_GP1_RVALID"), M_AXI_GP1_WREADY("M_AXI_GP1_WREADY"), M_AXI_GP1_BID("M_AXI_GP1_BID"), M_AXI_GP1_RID("M_AXI_GP1_RID"), M_AXI_GP1_BRESP("M_AXI_GP1_BRESP"), M_AXI_GP1_RRESP("M_AXI_GP1_RRESP"), M_AXI_GP1_RDATA("M_AXI_GP1_RDATA"), FCLK_CLK0("FCLK_CLK0"), FCLK_RESET0_N("FCLK_RESET0_N"), MIO("MIO"), DDR_CAS_n("DDR_CAS_n"), DDR_CKE("DDR_CKE"), DDR_Clk_n("DDR_Clk_n"), DDR_Clk("DDR_Clk"), DDR_CS_n("DDR_CS_n"), DDR_DRSTB("DDR_DRSTB"), DDR_ODT("DDR_ODT"), DDR_RAS_n("DDR_RAS_n"), DDR_WEB("DDR_WEB"), DDR_BankAddr("DDR_BankAddr"), DDR_Addr("DDR_Addr"), DDR_VRN("DDR_VRN"), DDR_VRP("DDR_VRP"), DDR_DM("DDR_DM"), DDR_DQ("DDR_DQ"), DDR_DQS_n("DDR_DQS_n"), DDR_DQS("DDR_DQS"), PS_SRSTB("PS_SRSTB"), PS_CLK("PS_CLK"), PS_PORB("PS_PORB")
{
  // initialize pins
  mp_impl->GPIO_I(GPIO_I);
  mp_impl->GPIO_O(GPIO_O);
  mp_impl->GPIO_T(GPIO_T);
  mp_impl->I2C0_SDA_I(I2C0_SDA_I);
  mp_impl->I2C0_SDA_O(I2C0_SDA_O);
  mp_impl->I2C0_SDA_T(I2C0_SDA_T);
  mp_impl->I2C0_SCL_I(I2C0_SCL_I);
  mp_impl->I2C0_SCL_O(I2C0_SCL_O);
  mp_impl->I2C0_SCL_T(I2C0_SCL_T);
  mp_impl->USB0_PORT_INDCTL(USB0_PORT_INDCTL);
  mp_impl->USB0_VBUS_PWRSELECT(USB0_VBUS_PWRSELECT);
  mp_impl->USB0_VBUS_PWRFAULT(USB0_VBUS_PWRFAULT);
  mp_impl->M_AXI_GP0_ACLK(M_AXI_GP0_ACLK);
  mp_impl->M_AXI_GP1_ACLK(M_AXI_GP1_ACLK);
  mp_impl->FCLK_CLK0(FCLK_CLK0);
  mp_impl->FCLK_RESET0_N(FCLK_RESET0_N);
  mp_impl->MIO(MIO);
  mp_impl->DDR_CAS_n(DDR_CAS_n);
  mp_impl->DDR_CKE(DDR_CKE);
  mp_impl->DDR_Clk_n(DDR_Clk_n);
  mp_impl->DDR_Clk(DDR_Clk);
  mp_impl->DDR_CS_n(DDR_CS_n);
  mp_impl->DDR_DRSTB(DDR_DRSTB);
  mp_impl->DDR_ODT(DDR_ODT);
  mp_impl->DDR_RAS_n(DDR_RAS_n);
  mp_impl->DDR_WEB(DDR_WEB);
  mp_impl->DDR_BankAddr(DDR_BankAddr);
  mp_impl->DDR_Addr(DDR_Addr);
  mp_impl->DDR_VRN(DDR_VRN);
  mp_impl->DDR_VRP(DDR_VRP);
  mp_impl->DDR_DM(DDR_DM);
  mp_impl->DDR_DQ(DDR_DQ);
  mp_impl->DDR_DQS_n(DDR_DQS_n);
  mp_impl->DDR_DQS(DDR_DQS);
  mp_impl->PS_SRSTB(PS_SRSTB);
  mp_impl->PS_CLK(PS_CLK);
  mp_impl->PS_PORB(PS_PORB);

  // initialize transactors
  mp_M_AXI_GP0_transactor = NULL;
  mp_M_AXI_GP0_ARLOCK_converter = NULL;
  mp_M_AXI_GP0_AWLOCK_converter = NULL;
  mp_M_AXI_GP0_ARLEN_converter = NULL;
  mp_M_AXI_GP0_AWLEN_converter = NULL;
  mp_M_AXI_GP1_transactor = NULL;
  mp_M_AXI_GP1_ARLOCK_converter = NULL;
  mp_M_AXI_GP1_AWLOCK_converter = NULL;
  mp_M_AXI_GP1_ARLEN_converter = NULL;
  mp_M_AXI_GP1_AWLEN_converter = NULL;

  // Instantiate Socket Stubs

  // configure M_AXI_GP0_transactor
    xsc::common_cpp::properties M_AXI_GP0_transactor_param_props;
    M_AXI_GP0_transactor_param_props.addLong("SUPPORTS_NARROW_BURST", "0");
    M_AXI_GP0_transactor_param_props.addLong("NUM_WRITE_OUTSTANDING", "8");
    M_AXI_GP0_transactor_param_props.addLong("NUM_READ_OUTSTANDING", "8");
    M_AXI_GP0_transactor_param_props.addLong("DATA_WIDTH", "32");
    M_AXI_GP0_transactor_param_props.addLong("FREQ_HZ", "122880000");
    M_AXI_GP0_transactor_param_props.addLong("ID_WIDTH", "12");
    M_AXI_GP0_transactor_param_props.addLong("ADDR_WIDTH", "32");
    M_AXI_GP0_transactor_param_props.addLong("AWUSER_WIDTH", "0");
    M_AXI_GP0_transactor_param_props.addLong("ARUSER_WIDTH", "0");
    M_AXI_GP0_transactor_param_props.addLong("WUSER_WIDTH", "0");
    M_AXI_GP0_transactor_param_props.addLong("RUSER_WIDTH", "0");
    M_AXI_GP0_transactor_param_props.addLong("BUSER_WIDTH", "0");
    M_AXI_GP0_transactor_param_props.addLong("HAS_BURST", "1");
    M_AXI_GP0_transactor_param_props.addLong("HAS_LOCK", "1");
    M_AXI_GP0_transactor_param_props.addLong("HAS_PROT", "1");
    M_AXI_GP0_transactor_param_props.addLong("HAS_CACHE", "1");
    M_AXI_GP0_transactor_param_props.addLong("HAS_QOS", "1");
    M_AXI_GP0_transactor_param_props.addLong("HAS_REGION", "0");
    M_AXI_GP0_transactor_param_props.addLong("HAS_WSTRB", "1");
    M_AXI_GP0_transactor_param_props.addLong("HAS_BRESP", "1");
    M_AXI_GP0_transactor_param_props.addLong("HAS_RRESP", "1");
    M_AXI_GP0_transactor_param_props.addLong("MAX_BURST_LENGTH", "16");
    M_AXI_GP0_transactor_param_props.addLong("NUM_READ_THREADS", "4");
    M_AXI_GP0_transactor_param_props.addLong("NUM_WRITE_THREADS", "4");
    M_AXI_GP0_transactor_param_props.addLong("RUSER_BITS_PER_BYTE", "0");
    M_AXI_GP0_transactor_param_props.addLong("WUSER_BITS_PER_BYTE", "0");
    M_AXI_GP0_transactor_param_props.addLong("HAS_SIZE", "1");
    M_AXI_GP0_transactor_param_props.addLong("HAS_RESET", "0");
    M_AXI_GP0_transactor_param_props.addFloat("PHASE", "0.0");
    M_AXI_GP0_transactor_param_props.addString("PROTOCOL", "AXI3");
    M_AXI_GP0_transactor_param_props.addString("READ_WRITE_MODE", "READ_WRITE");
    M_AXI_GP0_transactor_param_props.addString("CLK_DOMAIN", "/pll_0_clk_out1");

    mp_M_AXI_GP0_transactor = new xtlm::xaximm_xtlm2pin_t<32,32,12,1,1,1,1,1>("M_AXI_GP0_transactor", M_AXI_GP0_transactor_param_props);
  mp_M_AXI_GP0_transactor->ARVALID(M_AXI_GP0_ARVALID);
  mp_M_AXI_GP0_transactor->AWVALID(M_AXI_GP0_AWVALID);
  mp_M_AXI_GP0_transactor->BREADY(M_AXI_GP0_BREADY);
  mp_M_AXI_GP0_transactor->RREADY(M_AXI_GP0_RREADY);
  mp_M_AXI_GP0_transactor->WLAST(M_AXI_GP0_WLAST);
  mp_M_AXI_GP0_transactor->WVALID(M_AXI_GP0_WVALID);
  mp_M_AXI_GP0_transactor->ARID(M_AXI_GP0_ARID);
  mp_M_AXI_GP0_transactor->AWID(M_AXI_GP0_AWID);
  mp_M_AXI_GP0_transactor->ARBURST(M_AXI_GP0_ARBURST);
  mp_M_AXI_GP0_ARLOCK_converter = new xsc::common::scalar2vectorN_converter<2>("M_AXI_GP0_ARLOCK_converter");
  mp_M_AXI_GP0_ARLOCK_converter->scalar_in(m_M_AXI_GP0_ARLOCK_converter_signal);
  mp_M_AXI_GP0_ARLOCK_converter->vector_out(M_AXI_GP0_ARLOCK);
  mp_M_AXI_GP0_transactor->ARLOCK(m_M_AXI_GP0_ARLOCK_converter_signal);
  mp_M_AXI_GP0_transactor->ARSIZE(M_AXI_GP0_ARSIZE);
  mp_M_AXI_GP0_transactor->AWBURST(M_AXI_GP0_AWBURST);
  mp_M_AXI_GP0_AWLOCK_converter = new xsc::common::scalar2vectorN_converter<2>("M_AXI_GP0_AWLOCK_converter");
  mp_M_AXI_GP0_AWLOCK_converter->scalar_in(m_M_AXI_GP0_AWLOCK_converter_signal);
  mp_M_AXI_GP0_AWLOCK_converter->vector_out(M_AXI_GP0_AWLOCK);
  mp_M_AXI_GP0_transactor->AWLOCK(m_M_AXI_GP0_AWLOCK_converter_signal);
  mp_M_AXI_GP0_transactor->AWSIZE(M_AXI_GP0_AWSIZE);
  mp_M_AXI_GP0_transactor->ARPROT(M_AXI_GP0_ARPROT);
  mp_M_AXI_GP0_transactor->AWPROT(M_AXI_GP0_AWPROT);
  mp_M_AXI_GP0_transactor->ARADDR(M_AXI_GP0_ARADDR);
  mp_M_AXI_GP0_transactor->AWADDR(M_AXI_GP0_AWADDR);
  mp_M_AXI_GP0_transactor->WDATA(M_AXI_GP0_WDATA);
  mp_M_AXI_GP0_transactor->ARCACHE(M_AXI_GP0_ARCACHE);
  mp_M_AXI_GP0_ARLEN_converter = new xsc::common::vector2vector_converter<8,4>("M_AXI_GP0_ARLEN_converter");
  mp_M_AXI_GP0_ARLEN_converter->vector_in(m_M_AXI_GP0_ARLEN_converter_signal);
  mp_M_AXI_GP0_ARLEN_converter->vector_out(M_AXI_GP0_ARLEN);
  mp_M_AXI_GP0_transactor->ARLEN(m_M_AXI_GP0_ARLEN_converter_signal);
  mp_M_AXI_GP0_transactor->ARQOS(M_AXI_GP0_ARQOS);
  mp_M_AXI_GP0_transactor->AWCACHE(M_AXI_GP0_AWCACHE);
  mp_M_AXI_GP0_AWLEN_converter = new xsc::common::vector2vector_converter<8,4>("M_AXI_GP0_AWLEN_converter");
  mp_M_AXI_GP0_AWLEN_converter->vector_in(m_M_AXI_GP0_AWLEN_converter_signal);
  mp_M_AXI_GP0_AWLEN_converter->vector_out(M_AXI_GP0_AWLEN);
  mp_M_AXI_GP0_transactor->AWLEN(m_M_AXI_GP0_AWLEN_converter_signal);
  mp_M_AXI_GP0_transactor->AWQOS(M_AXI_GP0_AWQOS);
  mp_M_AXI_GP0_transactor->WSTRB(M_AXI_GP0_WSTRB);
  mp_M_AXI_GP0_transactor->ARREADY(M_AXI_GP0_ARREADY);
  mp_M_AXI_GP0_transactor->AWREADY(M_AXI_GP0_AWREADY);
  mp_M_AXI_GP0_transactor->BVALID(M_AXI_GP0_BVALID);
  mp_M_AXI_GP0_transactor->RLAST(M_AXI_GP0_RLAST);
  mp_M_AXI_GP0_transactor->RVALID(M_AXI_GP0_RVALID);
  mp_M_AXI_GP0_transactor->WREADY(M_AXI_GP0_WREADY);
  mp_M_AXI_GP0_transactor->BID(M_AXI_GP0_BID);
  mp_M_AXI_GP0_transactor->RID(M_AXI_GP0_RID);
  mp_M_AXI_GP0_transactor->BRESP(M_AXI_GP0_BRESP);
  mp_M_AXI_GP0_transactor->RRESP(M_AXI_GP0_RRESP);
  mp_M_AXI_GP0_transactor->RDATA(M_AXI_GP0_RDATA);
  mp_M_AXI_GP0_transactor->CLK(M_AXI_GP0_ACLK);
  m_M_AXI_GP0_transactor_rst_signal.write(1);
  mp_M_AXI_GP0_transactor->RST(m_M_AXI_GP0_transactor_rst_signal);
  // configure M_AXI_GP1_transactor
    xsc::common_cpp::properties M_AXI_GP1_transactor_param_props;
    M_AXI_GP1_transactor_param_props.addLong("NUM_WRITE_OUTSTANDING", "8");
    M_AXI_GP1_transactor_param_props.addLong("NUM_READ_OUTSTANDING", "8");
    M_AXI_GP1_transactor_param_props.addLong("SUPPORTS_NARROW_BURST", "0");
    M_AXI_GP1_transactor_param_props.addLong("DATA_WIDTH", "32");
    M_AXI_GP1_transactor_param_props.addLong("FREQ_HZ", "122880000");
    M_AXI_GP1_transactor_param_props.addLong("ID_WIDTH", "12");
    M_AXI_GP1_transactor_param_props.addLong("ADDR_WIDTH", "32");
    M_AXI_GP1_transactor_param_props.addLong("AWUSER_WIDTH", "0");
    M_AXI_GP1_transactor_param_props.addLong("ARUSER_WIDTH", "0");
    M_AXI_GP1_transactor_param_props.addLong("WUSER_WIDTH", "0");
    M_AXI_GP1_transactor_param_props.addLong("RUSER_WIDTH", "0");
    M_AXI_GP1_transactor_param_props.addLong("BUSER_WIDTH", "0");
    M_AXI_GP1_transactor_param_props.addLong("HAS_BURST", "1");
    M_AXI_GP1_transactor_param_props.addLong("HAS_LOCK", "1");
    M_AXI_GP1_transactor_param_props.addLong("HAS_PROT", "1");
    M_AXI_GP1_transactor_param_props.addLong("HAS_CACHE", "1");
    M_AXI_GP1_transactor_param_props.addLong("HAS_QOS", "1");
    M_AXI_GP1_transactor_param_props.addLong("HAS_REGION", "0");
    M_AXI_GP1_transactor_param_props.addLong("HAS_WSTRB", "1");
    M_AXI_GP1_transactor_param_props.addLong("HAS_BRESP", "1");
    M_AXI_GP1_transactor_param_props.addLong("HAS_RRESP", "1");
    M_AXI_GP1_transactor_param_props.addLong("MAX_BURST_LENGTH", "16");
    M_AXI_GP1_transactor_param_props.addLong("NUM_READ_THREADS", "4");
    M_AXI_GP1_transactor_param_props.addLong("NUM_WRITE_THREADS", "4");
    M_AXI_GP1_transactor_param_props.addLong("RUSER_BITS_PER_BYTE", "0");
    M_AXI_GP1_transactor_param_props.addLong("WUSER_BITS_PER_BYTE", "0");
    M_AXI_GP1_transactor_param_props.addLong("HAS_SIZE", "1");
    M_AXI_GP1_transactor_param_props.addLong("HAS_RESET", "0");
    M_AXI_GP1_transactor_param_props.addFloat("PHASE", "0.0");
    M_AXI_GP1_transactor_param_props.addString("PROTOCOL", "AXI3");
    M_AXI_GP1_transactor_param_props.addString("READ_WRITE_MODE", "READ_WRITE");
    M_AXI_GP1_transactor_param_props.addString("CLK_DOMAIN", "/pll_0_clk_out1");

    mp_M_AXI_GP1_transactor = new xtlm::xaximm_xtlm2pin_t<32,32,12,1,1,1,1,1>("M_AXI_GP1_transactor", M_AXI_GP1_transactor_param_props);
  mp_M_AXI_GP1_transactor->ARVALID(M_AXI_GP1_ARVALID);
  mp_M_AXI_GP1_transactor->AWVALID(M_AXI_GP1_AWVALID);
  mp_M_AXI_GP1_transactor->BREADY(M_AXI_GP1_BREADY);
  mp_M_AXI_GP1_transactor->RREADY(M_AXI_GP1_RREADY);
  mp_M_AXI_GP1_transactor->WLAST(M_AXI_GP1_WLAST);
  mp_M_AXI_GP1_transactor->WVALID(M_AXI_GP1_WVALID);
  mp_M_AXI_GP1_transactor->ARID(M_AXI_GP1_ARID);
  mp_M_AXI_GP1_transactor->AWID(M_AXI_GP1_AWID);
  mp_M_AXI_GP1_transactor->ARBURST(M_AXI_GP1_ARBURST);
  mp_M_AXI_GP1_ARLOCK_converter = new xsc::common::scalar2vectorN_converter<2>("M_AXI_GP1_ARLOCK_converter");
  mp_M_AXI_GP1_ARLOCK_converter->scalar_in(m_M_AXI_GP1_ARLOCK_converter_signal);
  mp_M_AXI_GP1_ARLOCK_converter->vector_out(M_AXI_GP1_ARLOCK);
  mp_M_AXI_GP1_transactor->ARLOCK(m_M_AXI_GP1_ARLOCK_converter_signal);
  mp_M_AXI_GP1_transactor->ARSIZE(M_AXI_GP1_ARSIZE);
  mp_M_AXI_GP1_transactor->AWBURST(M_AXI_GP1_AWBURST);
  mp_M_AXI_GP1_AWLOCK_converter = new xsc::common::scalar2vectorN_converter<2>("M_AXI_GP1_AWLOCK_converter");
  mp_M_AXI_GP1_AWLOCK_converter->scalar_in(m_M_AXI_GP1_AWLOCK_converter_signal);
  mp_M_AXI_GP1_AWLOCK_converter->vector_out(M_AXI_GP1_AWLOCK);
  mp_M_AXI_GP1_transactor->AWLOCK(m_M_AXI_GP1_AWLOCK_converter_signal);
  mp_M_AXI_GP1_transactor->AWSIZE(M_AXI_GP1_AWSIZE);
  mp_M_AXI_GP1_transactor->ARPROT(M_AXI_GP1_ARPROT);
  mp_M_AXI_GP1_transactor->AWPROT(M_AXI_GP1_AWPROT);
  mp_M_AXI_GP1_transactor->ARADDR(M_AXI_GP1_ARADDR);
  mp_M_AXI_GP1_transactor->AWADDR(M_AXI_GP1_AWADDR);
  mp_M_AXI_GP1_transactor->WDATA(M_AXI_GP1_WDATA);
  mp_M_AXI_GP1_transactor->ARCACHE(M_AXI_GP1_ARCACHE);
  mp_M_AXI_GP1_ARLEN_converter = new xsc::common::vector2vector_converter<8,4>("M_AXI_GP1_ARLEN_converter");
  mp_M_AXI_GP1_ARLEN_converter->vector_in(m_M_AXI_GP1_ARLEN_converter_signal);
  mp_M_AXI_GP1_ARLEN_converter->vector_out(M_AXI_GP1_ARLEN);
  mp_M_AXI_GP1_transactor->ARLEN(m_M_AXI_GP1_ARLEN_converter_signal);
  mp_M_AXI_GP1_transactor->ARQOS(M_AXI_GP1_ARQOS);
  mp_M_AXI_GP1_transactor->AWCACHE(M_AXI_GP1_AWCACHE);
  mp_M_AXI_GP1_AWLEN_converter = new xsc::common::vector2vector_converter<8,4>("M_AXI_GP1_AWLEN_converter");
  mp_M_AXI_GP1_AWLEN_converter->vector_in(m_M_AXI_GP1_AWLEN_converter_signal);
  mp_M_AXI_GP1_AWLEN_converter->vector_out(M_AXI_GP1_AWLEN);
  mp_M_AXI_GP1_transactor->AWLEN(m_M_AXI_GP1_AWLEN_converter_signal);
  mp_M_AXI_GP1_transactor->AWQOS(M_AXI_GP1_AWQOS);
  mp_M_AXI_GP1_transactor->WSTRB(M_AXI_GP1_WSTRB);
  mp_M_AXI_GP1_transactor->ARREADY(M_AXI_GP1_ARREADY);
  mp_M_AXI_GP1_transactor->AWREADY(M_AXI_GP1_AWREADY);
  mp_M_AXI_GP1_transactor->BVALID(M_AXI_GP1_BVALID);
  mp_M_AXI_GP1_transactor->RLAST(M_AXI_GP1_RLAST);
  mp_M_AXI_GP1_transactor->RVALID(M_AXI_GP1_RVALID);
  mp_M_AXI_GP1_transactor->WREADY(M_AXI_GP1_WREADY);
  mp_M_AXI_GP1_transactor->BID(M_AXI_GP1_BID);
  mp_M_AXI_GP1_transactor->RID(M_AXI_GP1_RID);
  mp_M_AXI_GP1_transactor->BRESP(M_AXI_GP1_BRESP);
  mp_M_AXI_GP1_transactor->RRESP(M_AXI_GP1_RRESP);
  mp_M_AXI_GP1_transactor->RDATA(M_AXI_GP1_RDATA);
  mp_M_AXI_GP1_transactor->CLK(M_AXI_GP1_ACLK);
  m_M_AXI_GP1_transactor_rst_signal.write(1);
  mp_M_AXI_GP1_transactor->RST(m_M_AXI_GP1_transactor_rst_signal);

  // initialize transactors stubs
  M_AXI_GP0_transactor_initiator_wr_socket_stub = nullptr;
  M_AXI_GP0_transactor_initiator_rd_socket_stub = nullptr;
  M_AXI_GP1_transactor_initiator_wr_socket_stub = nullptr;
  M_AXI_GP1_transactor_initiator_rd_socket_stub = nullptr;

}

void system_ps_0_0::before_end_of_elaboration()
{
  // configure 'M_AXI_GP0' transactor
  if (xsc::utils::xsc_sim_manager::getInstanceParameterInt("system_ps_0_0", "M_AXI_GP0_TLM_MODE") != 1)
  {
    mp_impl->M_AXI_GP0_rd_socket->bind(*(mp_M_AXI_GP0_transactor->rd_socket));
    mp_impl->M_AXI_GP0_wr_socket->bind(*(mp_M_AXI_GP0_transactor->wr_socket));
  
  }
  else
  {
    M_AXI_GP0_transactor_initiator_wr_socket_stub = new xtlm::xtlm_aximm_initiator_stub("wr_socket",0);
    M_AXI_GP0_transactor_initiator_wr_socket_stub->bind(*(mp_M_AXI_GP0_transactor->wr_socket));
    M_AXI_GP0_transactor_initiator_rd_socket_stub = new xtlm::xtlm_aximm_initiator_stub("rd_socket",0);
    M_AXI_GP0_transactor_initiator_rd_socket_stub->bind(*(mp_M_AXI_GP0_transactor->rd_socket));
    mp_M_AXI_GP0_transactor->disable_transactor();
  }

  // configure 'M_AXI_GP1' transactor
  if (xsc::utils::xsc_sim_manager::getInstanceParameterInt("system_ps_0_0", "M_AXI_GP1_TLM_MODE") != 1)
  {
    mp_impl->M_AXI_GP1_rd_socket->bind(*(mp_M_AXI_GP1_transactor->rd_socket));
    mp_impl->M_AXI_GP1_wr_socket->bind(*(mp_M_AXI_GP1_transactor->wr_socket));
  
  }
  else
  {
    M_AXI_GP1_transactor_initiator_wr_socket_stub = new xtlm::xtlm_aximm_initiator_stub("wr_socket",0);
    M_AXI_GP1_transactor_initiator_wr_socket_stub->bind(*(mp_M_AXI_GP1_transactor->wr_socket));
    M_AXI_GP1_transactor_initiator_rd_socket_stub = new xtlm::xtlm_aximm_initiator_stub("rd_socket",0);
    M_AXI_GP1_transactor_initiator_rd_socket_stub->bind(*(mp_M_AXI_GP1_transactor->rd_socket));
    mp_M_AXI_GP1_transactor->disable_transactor();
  }

}

#endif // MTI_SYSTEMC




system_ps_0_0::~system_ps_0_0()
{
  delete mp_M_AXI_GP0_transactor;
  delete mp_M_AXI_GP0_ARLOCK_converter;
  delete mp_M_AXI_GP0_AWLOCK_converter;
  delete mp_M_AXI_GP0_ARLEN_converter;
  delete mp_M_AXI_GP0_AWLEN_converter;

  delete mp_M_AXI_GP1_transactor;
  delete mp_M_AXI_GP1_ARLOCK_converter;
  delete mp_M_AXI_GP1_AWLOCK_converter;
  delete mp_M_AXI_GP1_ARLEN_converter;
  delete mp_M_AXI_GP1_AWLEN_converter;

}

#ifdef MTI_SYSTEMC
SC_MODULE_EXPORT(system_ps_0_0);
#endif

#ifdef XM_SYSTEMC
XMSC_MODULE_EXPORT(system_ps_0_0);
#endif

#ifdef RIVIERA
SC_MODULE_EXPORT(system_ps_0_0);
SC_REGISTER_BV(64);
#endif
