Eskdagoat/Qorvo_F24_SD/SD1_Fall24/Computer/Eclypse/Eclypse_Transceiver/Eclypse_Transceiver/Eclypse_Transceiver.gen/sources_1/bd/system/ip/system_ps_0_0/sim/system_ps_0_0_stub.sv

// (c) Copyright 1986-2022 Xilinx, Inc. All Rights Reserved.
// (c) Copyright 2022-2024 Advanced Micro Devices, Inc. All rights reserved.
// 
// This file contains confidential and proprietary information
// of AMD and is protected under U.S. and international copyright
// and other intellectual property laws.
// 
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
// CRITICAL APPLICATIONS
// AMD products are not designed or intended to be fail-
// safe, or for use in any application requiring fail-safe
// performance, such as life-support or safety devices or
// systems, Class III medical devices, nuclear facilities,
// applications related to the deployment of airbags, or any
// other applications that could lead to death, personal
// injury, or severe property or environmental damage
// (individually and collectively, "Critical
// Applications"). Customer assumes the sole risk and
// liability of any use of AMD products in Critical
// Applications, subject only to applicable laws and
// regulations governing limitations on product liability.
// 
// THIS COPYRIGHT NOTICE AND DISCLAIMER MUST BE RETAINED AS
// PART OF THIS FILE AT ALL TIMES.
// 
// DO NOT MODIFY THIS FILE.


//------------------------------------------------------------------------------------
// Filename:    system_ps_0_0_stub.sv
// Description: This HDL file is intended to be used with following simulators only:
//
//   Vivado Simulator (XSim)
//   Cadence Xcelium Simulator
//
//------------------------------------------------------------------------------------
`timescale 1ps/1ps

`ifdef XILINX_SIMULATOR

`ifndef XILINX_SIMULATOR_BITASBOOL
`define XILINX_SIMULATOR_BITASBOOL
typedef bit bit_as_bool;
`endif

(* SC_MODULE_EXPORT *)
module system_ps_0_0 (
  input bit [63 : 0] GPIO_I,
  output bit [63 : 0] GPIO_O,
  output bit [63 : 0] GPIO_T,
  input bit_as_bool I2C0_SDA_I,
  output bit_as_bool I2C0_SDA_O,
  output bit_as_bool I2C0_SDA_T,
  input bit_as_bool I2C0_SCL_I,
  output bit_as_bool I2C0_SCL_O,
  output bit_as_bool I2C0_SCL_T,
  output bit [1 : 0] USB0_PORT_INDCTL,
  output bit_as_bool USB0_VBUS_PWRSELECT,
  input bit_as_bool USB0_VBUS_PWRFAULT,
  output bit_as_bool M_AXI_GP0_ARVALID,
  output bit_as_bool M_AXI_GP0_AWVALID,
  output bit_as_bool M_AXI_GP0_BREADY,
  output bit_as_bool M_AXI_GP0_RREADY,
  output bit_as_bool M_AXI_GP0_WLAST,
  output bit_as_bool M_AXI_GP0_WVALID,
  output bit [11 : 0] M_AXI_GP0_ARID,
  output bit [11 : 0] M_AXI_GP0_AWID,
  output bit [11 : 0] M_AXI_GP0_WID,
  output bit [1 : 0] M_AXI_GP0_ARBURST,
  output bit [1 : 0] M_AXI_GP0_ARLOCK,
  output bit [2 : 0] M_AXI_GP0_ARSIZE,
  output bit [1 : 0] M_AXI_GP0_AWBURST,
  output bit [1 : 0] M_AXI_GP0_AWLOCK,
  output bit [2 : 0] M_AXI_GP0_AWSIZE,
  output bit [2 : 0] M_AXI_GP0_ARPROT,
  output bit [2 : 0] M_AXI_GP0_AWPROT,
  output bit [31 : 0] M_AXI_GP0_ARADDR,
  output bit [31 : 0] M_AXI_GP0_AWADDR,
  output bit [31 : 0] M_AXI_GP0_WDATA,
  output bit [3 : 0] M_AXI_GP0_ARCACHE,
  output bit [3 : 0] M_AXI_GP0_ARLEN,
  output bit [3 : 0] M_AXI_GP0_ARQOS,
  output bit [3 : 0] M_AXI_GP0_AWCACHE,
  output bit [3 : 0] M_AXI_GP0_AWLEN,
  output bit [3 : 0] M_AXI_GP0_AWQOS,
  output bit [3 : 0] M_AXI_GP0_WSTRB,
  input bit_as_bool M_AXI_GP0_ACLK,
  input bit_as_bool M_AXI_GP0_ARREADY,
  input bit_as_bool M_AXI_GP0_AWREADY,
  input bit_as_bool M_AXI_GP0_BVALID,
  input bit_as_bool M_AXI_GP0_RLAST,
  input bit_as_bool M_AXI_GP0_RVALID,
  input bit_as_bool M_AXI_GP0_WREADY,
  input bit [11 : 0] M_AXI_GP0_BID,
  input bit [11 : 0] M_AXI_GP0_RID,
  input bit [1 : 0] M_AXI_GP0_BRESP,
  input bit [1 : 0] M_AXI_GP0_RRESP,
  input bit [31 : 0] M_AXI_GP0_RDATA,
  output bit_as_bool M_AXI_GP1_ARVALID,
  output bit_as_bool M_AXI_GP1_AWVALID,
  output bit_as_bool M_AXI_GP1_BREADY,
  output bit_as_bool M_AXI_GP1_RREADY,
  output bit_as_bool M_AXI_GP1_WLAST,
  output bit_as_bool M_AXI_GP1_WVALID,
  output bit [11 : 0] M_AXI_GP1_ARID,
  output bit [11 : 0] M_AXI_GP1_AWID,
  output bit [11 : 0] M_AXI_GP1_WID,
  output bit [1 : 0] M_AXI_GP1_ARBURST,
  output bit [1 : 0] M_AXI_GP1_ARLOCK,
  output bit [2 : 0] M_AXI_GP1_ARSIZE,
  output bit [1 : 0] M_AXI_GP1_AWBURST,
  output bit [1 : 0] M_AXI_GP1_AWLOCK,
  output bit [2 : 0] M_AXI_GP1_AWSIZE,
  output bit [2 : 0] M_AXI_GP1_ARPROT,
  output bit [2 : 0] M_AXI_GP1_AWPROT,
  output bit [31 : 0] M_AXI_GP1_ARADDR,
  output bit [31 : 0] M_AXI_GP1_AWADDR,
  output bit [31 : 0] M_AXI_GP1_WDATA,
  output bit [3 : 0] M_AXI_GP1_ARCACHE,
  output bit [3 : 0] M_AXI_GP1_ARLEN,
  output bit [3 : 0] M_AXI_GP1_ARQOS,
  output bit [3 : 0] M_AXI_GP1_AWCACHE,
  output bit [3 : 0] M_AXI_GP1_AWLEN,
  output bit [3 : 0] M_AXI_GP1_AWQOS,
  output bit [3 : 0] M_AXI_GP1_WSTRB,
  input bit_as_bool M_AXI_GP1_ACLK,
  input bit_as_bool M_AXI_GP1_ARREADY,
  input bit_as_bool M_AXI_GP1_AWREADY,
  input bit_as_bool M_AXI_GP1_BVALID,
  input bit_as_bool M_AXI_GP1_RLAST,
  input bit_as_bool M_AXI_GP1_RVALID,
  input bit_as_bool M_AXI_GP1_WREADY,
  input bit [11 : 0] M_AXI_GP1_BID,
  input bit [11 : 0] M_AXI_GP1_RID,
  input bit [1 : 0] M_AXI_GP1_BRESP,
  input bit [1 : 0] M_AXI_GP1_RRESP,
  input bit [31 : 0] M_AXI_GP1_RDATA,
  output bit_as_bool FCLK_CLK0,
  output bit_as_bool FCLK_RESET0_N,
  output bit [53 : 0] MIO,
  output bit_as_bool DDR_CAS_n,
  output bit_as_bool DDR_CKE,
  output bit_as_bool DDR_Clk_n,
  output bit_as_bool DDR_Clk,
  output bit_as_bool DDR_CS_n,
  output bit_as_bool DDR_DRSTB,
  output bit_as_bool DDR_ODT,
  output bit_as_bool DDR_RAS_n,
  output bit_as_bool DDR_WEB,
  output bit [2 : 0] DDR_BankAddr,
  output bit [14 : 0] DDR_Addr,
  output bit_as_bool DDR_VRN,
  output bit_as_bool DDR_VRP,
  output bit [3 : 0] DDR_DM,
  output bit [31 : 0] DDR_DQ,
  output bit [3 : 0] DDR_DQS_n,
  output bit [3 : 0] DDR_DQS,
  output bit_as_bool PS_SRSTB,
  output bit_as_bool PS_CLK,
  output bit_as_bool PS_PORB
);
endmodule
`endif
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
