Eskdagoat/Qorvo_F24_SD/(commit log)

2024-11-08 GNU Radio IP Communication
    Pynq LED 0 Control via TCP/IP
2025-01-28 Create SPI_Master.vhdl
    A general SPI master interface that handles communication with both the I/O Expander (MCP23017) and the LO (ADF4351). This interface selects which device to communicate with, using the Chip Select (CS) signal to activate the correct device.
2025-01-28 Create SPI_Rx_test.vhd
    Test code to add receive signals to SPI communication
2025-05-02 clean up[
    [FPGA_Coding_Notes.xlsx]
